IndustriasBizarras/SIE/PCB/Kicad/sie_kicad_mini/SAKC.brd.org

PCBNEW-BOARD Version 1 date Mon 28 Jun 2010 10:10:36 AM COT

$GENERAL
LayerCount 2
Ly 1FFF8001
Links 552
NoConn 0
Di 54745 42295 109665 82225
Ndraw 30
Ntrack 4642
Nzone 8332
Nmodule 163
Nnets 208
$EndGENERAL

$SHEETDESCR
Sheet A3 16535 11700
Title ""
Date "28 jun 2010"
Rev ""
Comp ""
Comment1 ""
Comment2 ""
Comment3 ""
Comment4 ""
$EndSHEETDESCR

$SETUP
InternalUnit 0.000100 INCH
ZoneGridSize 50
Layers 2
Layer[0] Copper signal
Layer[15] Component signal
TrackWidth 310
TrackWidthHistory 75
TrackWidthHistory 170
TrackWidthHistory 310
TrackClearence 75
ZoneClearence 118
DrawSegmWidth 79
EdgeSegmWidth 79
ViaSize 236
ViaDrill 118
ViaAltDrill 250
ViaSizeHistory 236
MicroViaSize 200
MicroViaDrill 80
MicroViasAllowed 0
TextPcbWidth 120
TextPcbSize 600 800
EdgeModWidth 79
TextModSize 600 600
TextModWidth 79
PadSize 600 600
PadDrill 200
AuxiliaryAxisOrg 0 0
$EndSETUP

$EQUIPOT
Na 0 ""
St ~
$EndEQUIPOT
$EQUIPOT
Na 1 "/LCD/3.3V"
St ~
$EndEQUIPOT
$EQUIPOT
Na 2 "/FPGA/DIGIN1"
St ~
$EndEQUIPOT
$EQUIPOT
Na 3 "/FPGA/DIGIN2"
St ~
$EndEQUIPOT
$EQUIPOT
Na 4 "N-000163"
St ~
$EndEQUIPOT
$EQUIPOT
Na 5 "/LCD/GND"
St ~
$EndEQUIPOT
$EQUIPOT
Na 6 "N-000177"
St ~
$EndEQUIPOT
$EQUIPOT
Na 7 "/CPU/LCD_D17"
St ~
$EndEQUIPOT
$EQUIPOT
Na 8 "/CPU/VREF"
St ~
$EndEQUIPOT
$EQUIPOT
Na 9 "/CPU/VDDA"
St ~
$EndEQUIPOT
$EQUIPOT
Na 10 "N-000174"
St ~
$EndEQUIPOT
$EQUIPOT
Na 11 "/CPU/RCLK"
St ~
$EndEQUIPOT
$EQUIPOT
Na 12 "N-000173"
St ~
$EndEQUIPOT
$EQUIPOT
Na 13 "/CPU/EXTAL"
St ~
$EndEQUIPOT
$EQUIPOT
Na 14 "/CPU/RESET_N"
St ~
$EndEQUIPOT
$EQUIPOT
Na 15 "/CPU/VDDADC"
St ~
$EndEQUIPOT
$EQUIPOT
Na 16 "/CPU/VDDUSB"
St ~
$EndEQUIPOT
$EQUIPOT
Na 17 "/CPU/VDDHP"
St ~
$EndEQUIPOT
$EQUIPOT
Na 18 "/CPU/VDDPLL"
St ~
$EndEQUIPOT
$EQUIPOT
Na 19 "/CPU/VDDCORE"
St ~
$EndEQUIPOT
$EQUIPOT
Na 20 "/CPU/VDDIO"
St ~
$EndEQUIPOT
$EQUIPOT
Na 21 "/FPGA/1V2"
St ~
$EndEQUIPOT
$EQUIPOT
Na 22 "N-000149"
St ~
$EndEQUIPOT
$EQUIPOT
Na 23 "N-000152"
St ~
$EndEQUIPOT
$EQUIPOT
Na 24 "N-000151"
St ~
$EndEQUIPOT
$EQUIPOT
Na 25 "N-000155"
St ~
$EndEQUIPOT
$EQUIPOT
Na 26 "N-000153"
St ~
$EndEQUIPOT
$EQUIPOT
Na 27 "N-000150"
St ~
$EndEQUIPOT
$EQUIPOT
Na 28 "/1.8V"
St ~
$EndEQUIPOT
$EQUIPOT
Na 29 "/FPGA/2V5"
St ~
$EndEQUIPOT
$EQUIPOT
Na 30 "/UART_USB_I2C/BAT_V"
St ~
$EndEQUIPOT
$EQUIPOT
Na 31 "N-000157"
St ~
$EndEQUIPOT
$EQUIPOT
Na 32 "/LCD/LCD_VDD"
St ~
$EndEQUIPOT
$EQUIPOT
Na 33 "N-000154"
St ~
$EndEQUIPOT
$EQUIPOT
Na 34 "N-000103"
St ~
$EndEQUIPOT
$EQUIPOT
Na 35 "N-000101"
St ~
$EndEQUIPOT
$EQUIPOT
Na 36 "N-000115"
St ~
$EndEQUIPOT
$EQUIPOT
Na 37 "N-000113"
St ~
$EndEQUIPOT
$EQUIPOT
Na 38 "/MEMORY/MSC_CMD"
St ~
$EndEQUIPOT
$EQUIPOT
Na 39 "N-000116"
St ~
$EndEQUIPOT
$EQUIPOT
Na 40 "/MEMORY/MSC_D0"
St ~
$EndEQUIPOT
$EQUIPOT
Na 41 "N-000112"
St ~
$EndEQUIPOT
$EQUIPOT
Na 42 "/MEMORY/SD_CD_N"
St ~
$EndEQUIPOT
$EQUIPOT
Na 43 "/UART_USB_I2C/TX1"
St ~
$EndEQUIPOT
$EQUIPOT
Na 44 "/UART_USB_I2C/RX1"
St ~
$EndEQUIPOT
$EQUIPOT
Na 45 "/FPGA/TDO_F"
St ~
$EndEQUIPOT
$EQUIPOT
Na 46 "/FPGA/TMS_F"
St ~
$EndEQUIPOT
$EQUIPOT
Na 47 "N-000145"
St ~
$EndEQUIPOT
$EQUIPOT
Na 48 "/UART_USB_I2C/DM0"
St ~
$EndEQUIPOT
$EQUIPOT
Na 49 "/UART_USB_I2C/DP0"
St ~
$EndEQUIPOT
$EQUIPOT
Na 50 "N-000147"
St ~
$EndEQUIPOT
$EQUIPOT
Na 51 "/CPU/UBOOT"
St ~
$EndEQUIPOT
$EQUIPOT
Na 52 "/CONNECTORS/ADIN0"
St ~
$EndEQUIPOT
$EQUIPOT
Na 53 "/CONNECTORS/ADIN1"
St ~
$EndEQUIPOT
$EQUIPOT
Na 54 "/CONNECTORS/R-HPO"
St ~
$EndEQUIPOT
$EQUIPOT
Na 55 "/CONNECTORS/L-HPO"
St ~
$EndEQUIPOT
$EQUIPOT
Na 56 "/CONNECTORS/L-LINEIN"
St ~
$EndEQUIPOT
$EQUIPOT
Na 57 "/CONNECTORS/R-LINEIN"
St ~
$EndEQUIPOT
$EQUIPOT
Na 58 "/CONNECTORS/MICIN"
St ~
$EndEQUIPOT
$EQUIPOT
Na 59 "N-000146"
St ~
$EndEQUIPOT
$EQUIPOT
Na 60 "/FPGA/IRQ_F"
St ~
$EndEQUIPOT
$EQUIPOT
Na 61 "/FPGA/DIG12"
St ~
$EndEQUIPOT
$EQUIPOT
Na 62 "/FPGA/DIG11"
St ~
$EndEQUIPOT
$EQUIPOT
Na 63 "/FPGA/DIG10"
St ~
$EndEQUIPOT
$EQUIPOT
Na 64 "/FPGA/DIG9"
St ~
$EndEQUIPOT
$EQUIPOT
Na 65 "/FPGA/DIG8"
St ~
$EndEQUIPOT
$EQUIPOT
Na 66 "/FPGA/DIG7"
St ~
$EndEQUIPOT
$EQUIPOT
Na 67 "/FPGA/DIG6"
St ~
$EndEQUIPOT
$EQUIPOT
Na 68 "/FPGA/DIG5"
St ~
$EndEQUIPOT
$EQUIPOT
Na 69 "/FPGA/DIG4"
St ~
$EndEQUIPOT
$EQUIPOT
Na 70 "/FPGA/DIG3"
St ~
$EndEQUIPOT
$EQUIPOT
Na 71 "/FPGA/DIG2"
St ~
$EndEQUIPOT
$EQUIPOT
Na 72 "/FPGA/DIG1"
St ~
$EndEQUIPOT
$EQUIPOT
Na 73 "/FPGA/DIG0"
St ~
$EndEQUIPOT
$EQUIPOT
Na 74 "/FPGA/DIG14"
St ~
$EndEQUIPOT
$EQUIPOT
Na 75 "/FPGA/DIG15"
St ~
$EndEQUIPOT
$EQUIPOT
Na 76 "/FPGA/DIG16"
St ~
$EndEQUIPOT
$EQUIPOT
Na 77 "/FPGA/DIG17"
St ~
$EndEQUIPOT
$EQUIPOT
Na 78 "/FPGA/DIG18"
St ~
$EndEQUIPOT
$EQUIPOT
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
$EQUIPOT
Na 169 "/CS2_N"
St ~
$EndEQUIPOT
$EQUIPOT
Na 170 "/MEMORY/CS1_N"
St ~
$EndEQUIPOT
$EQUIPOT
Na 171 "/UART_USB_I2C/RXD"
St ~
$EndEQUIPOT
$EQUIPOT
Na 172 "/POWER_SUPPLY/VRTC"
St ~
$EndEQUIPOT
$EQUIPOT
Na 173 "/LCD/LCD_SCL"
St ~
$EndEQUIPOT
$EQUIPOT
Na 174 "/LCD/LCD_SDA"
St ~
$EndEQUIPOT
$EQUIPOT
Na 175 "/LCD/LCD_VSYNC"
St ~
$EndEQUIPOT
$EQUIPOT
Na 176 "/LCD/LCD_HSYNC"
St ~
$EndEQUIPOT
$EQUIPOT
Na 177 "/LCD/LCD_DE"
St ~
$EndEQUIPOT
$EQUIPOT
Na 178 "/FPGA/ADC_EOC"
St ~
$EndEQUIPOT
$EQUIPOT
Na 179 "/FPGA/ADC_SCLK"
St ~
$EndEQUIPOT
$EQUIPOT
Na 180 "/FPGA/ADC_SDIN"
St ~
$EndEQUIPOT
$EQUIPOT
Na 181 "/FPGA/ADC_SDOUT"
St ~
$EndEQUIPOT
$EQUIPOT
Na 182 "/FPGA/ADC_CS"
St ~
$EndEQUIPOT
$EQUIPOT
Na 183 "/FPGA/ADC_CSTART"
St ~
$EndEQUIPOT
$EQUIPOT
Na 184 "/FPGA/OSC_XM"
St ~
$EndEQUIPOT
$EQUIPOT
Na 185 "N-000162"
St ~
$EndEQUIPOT
$EQUIPOT
Na 186 "/LCD/V1M"
St ~
$EndEQUIPOT
$EQUIPOT
Na 187 "/LCD/V1P"
St ~
$EndEQUIPOT
$EQUIPOT
Na 188 "/LCD/V2M"
St ~
$EndEQUIPOT
$EQUIPOT
Na 189 "/LCD/V2P"
St ~
$EndEQUIPOT
$EQUIPOT
Na 190 "/LCD/V3M"
St ~
$EndEQUIPOT
$EQUIPOT
Na 191 "/LCD/V3P"
St ~
$EndEQUIPOT
$EQUIPOT
Na 192 "/LCD/V4M"
St ~
$EndEQUIPOT
$EQUIPOT
Na 193 "/LCD/V4P"
St ~
$EndEQUIPOT
$EQUIPOT
Na 194 "/LCD/AGND"
St ~
$EndEQUIPOT
$EQUIPOT
Na 195 "/LCD/DVDD"
St ~
$EndEQUIPOT
$EQUIPOT
Na 196 "/LCD/VINT1"
St ~
$EndEQUIPOT
$EQUIPOT
Na 197 "/LCD/VINT2"
St ~
$EndEQUIPOT
$EQUIPOT
Na 198 "/LCD/VINT3"
St ~
$EndEQUIPOT
$EQUIPOT
Na 199 "/LCD/VCAC"
St ~
$EndEQUIPOT
$EQUIPOT
Na 200 "/LCD/VGH"
St ~
$EndEQUIPOT
$EQUIPOT
Na 201 "/LCD/VGL"
St ~
$EndEQUIPOT
$EQUIPOT
Na 202 "/LCD/VCOM"
St ~
$EndEQUIPOT
$EQUIPOT
Na 203 "/LCD/FRP"
St ~
$EndEQUIPOT
$EQUIPOT
Na 204 "/LCD/VLED"
St ~
$EndEQUIPOT
$EQUIPOT
Na 205 "N-000067"
St ~
$EndEQUIPOT
$EQUIPOT
Na 206 "/LCD/DRV"
St ~
$EndEQUIPOT
$EQUIPOT
Na 207 "/LCD/FB"
St ~
$EndEQUIPOT
$MODULE J12
Po 78680 81380 0 15 4B8F50FA 4B7C7019 ~~
Li J12
Sc 4B7C7019
AR /4B8F6097/4B7C7019
Op 0 0 0
T0 0 -79 157 157 0 20 N I 21 N"J12"
T1 0 118 118 118 0 20 N I 21 N"HOLE1"
DS -840 840 -840 -830 10 24
DS -840 -830 830 -830 10 24
DS 830 -830 830 840 10 24
DS 830 840 -840 840 10 24
$PAD
Sh "1" C 3140 3140 0 0 0
Dr 1180 0 0
At STD N 0CC08001
Ne 0 ""
Po 15130 -7960
$EndPAD
$EndMODULE  J12
$MODULE J14
Po 97420 45150 0 15 4B8F50EE 4B7C701D ~~
Li J14
Sc 4B7C701D
AR /4B8F6097/4B7C701D
Op 0 0 0
T0 0 -79 157 157 0 20 N I 21 N"J14"
T1 0 118 118 118 0 20 N I 21 N"HOLE4"
DS -840 840 -840 -830 10 24
DS -840 -830 830 -830 10 24
DS 830 -830 830 840 10 24
DS 830 840 -840 840 10 24
$PAD
Sh "1" C 3140 3140 0 0 0
Dr 1180 0 0
At STD N 0CC08001
Ne 0 ""
Po -3620 -210
$EndPAD
$EndMODULE  J14
$MODULE R33
Po 85152 71912 0 15 4BA7D56B 4BA504CA ~~
Li R33
Sc 4BA504CA
AR /4B8F57B1/4BA504CA
Op 0 0 0
T0 -608 -16 157 157 -1800 20 N V 21 N"R33"
T1 0 118 118 118 -2700 20 N I 21 N"4.7K"
DS -330 360 880 360 10 24
DS 880 360 880 -350 10 24
DS 880 -350 -330 -350 10 24
DS -330 -350 -330 360 10 24
DS -300 330 -300 -320 60 21
DS -300 -320 -300 -320 60 21
DS -300 -320 850 -320 60 21
DS 850 -320 850 330 60 21
DS 850 330 -300 330 60 21
DS -300 330 -300 -320 60 26
DS -300 -320 -300 -320 60 26
DS -300 -320 850 -320 60 26
DS 850 -320 850 330 60 26
DS 850 330 -300 330 60 26
$PAD
Sh "1" R 380 320 0 0 900
Dr 0 0 0
At SMD N 04888000
Ne 1 "/LCD/3.3V"
Po 0 0
$EndPAD
$PAD
Sh "2" R 380 320 0 0 900
Dr 0 0 0
At SMD N 04888000
Ne 2 "/FPGA/DIGIN1"
Po 560 0
$EndPAD
$EndMODULE  R33
$MODULE R32
Po 89824 72420 0 15 4BA7D577 4BA504C2 ~~
Li R32
Sc 4BA504C2
AR /4B8F57B1/4BA504C2
Op 0 0 0
T0 -536 -40 157 157 -1800 20 N V 21 N"R32"
T1 0 118 118 118 -2700 20 N I 21 N"4.7K"
DS -330 360 880 360 10 24
DS 880 360 880 -350 10 24
DS 880 -350 -330 -350 10 24
DS -330 -350 -330 360 10 24
DS -300 330 -300 -320 60 21
DS -300 -320 -300 -320 60 21
DS -300 -320 850 -320 60 21
DS 850 -320 850 330 60 21
DS 850 330 -300 330 60 21
DS -300 330 -300 -320 60 26
DS -300 -320 -300 -320 60 26
DS -300 -320 850 -320 60 26
DS 850 -320 850 330 60 26
DS 850 330 -300 330 60 26
$PAD
Sh "1" R 380 320 0 0 900
Dr 0 0 0
At SMD N 04888000
Ne 1 "/LCD/3.3V"
Po 0 0
$EndPAD
$PAD
Sh "2" R 380 320 0 0 900
Dr 0 0 0
At SMD N 04888000
Ne 3 "/FPGA/DIGIN2"
Po 560 0
$EndPAD
$EndMODULE  R32
$MODULE R31
Po 90668 45280 0 15 4BA7DC55 4BA5068A ~~
Li R31
Sc 4BA5068A
AR /4B8F6097/4BA5068A
Op 0 0 0
T0 37 -396 157 157 0 20 N V 21 N"R31"
T1 0 118 118 118 -900 20 N I 21 N"1K"
DS -300 -250 -300 -300 60 21
DS -300 -300 300 -300 60 21
DS 300 -300 300 -250 60 21
DS -600 300 -600 -300 60 24
DS -600 -300 600 -300 60 24
DS 600 -300 600 300 60 24
DS 600 300 -600 300 60 24
DS -600 300 600 300 60 26
DS 600 300 600 -300 60 26
DS 600 -300 -600 -300 60 26
DS -600 -300 -600 300 60 26
DS -300 250 -300 300 60 21
DS -300 300 300 300 60 21
DS 300 300 300 250 60 21
$PAD
Sh "1" R 300 340 0 0 900
Dr 0 0 0
At SMD N 00888000
Ne 4 "N-000163"
Po -330 0
$EndPAD
$PAD
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
Po 0 70520 61744 72592 59672 75 -1
De 0 0 129 0 0
Po 0 72592 59672 72880 59672 75 -1
De 0 0 129 0 0
Po 0 70520 61956 70520 61744 75 -1
De 0 0 129 0 0
Po 0 70520 62112 70520 63890 75 -1
De 15 0 129 0 400
Po 0 70520 61956 70520 62112 75 -1
De 15 0 129 0 0
Po 3 70520 61956 70520 61956 236 -1
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
