IndustriasBizarras/SIE/docs/Board_layout.png

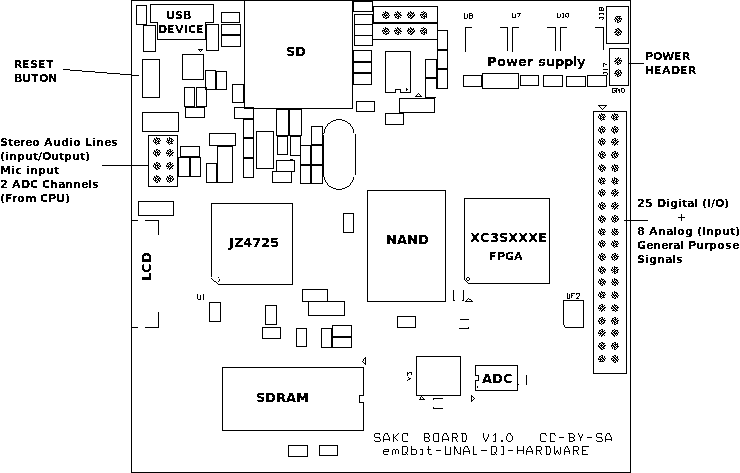
docs/Board_layout.png
