IndustriasBizarras/SIE/docs/SACK_BOT.png

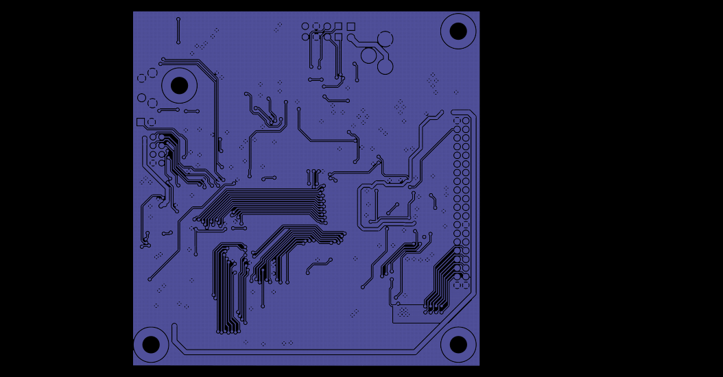
docs/SACK_BOT.png
