IndustriasBizarras/SIE/docs/SACK_SST.png

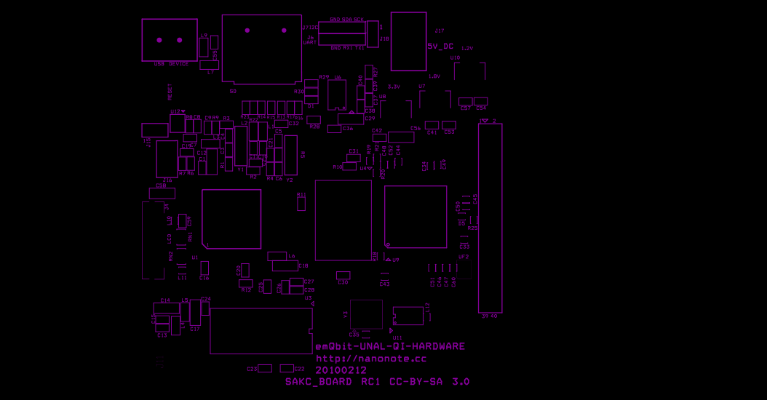
docs/SACK_SST.png
