IndustriasBizarras/SIE/docs/SACK_TOP.png

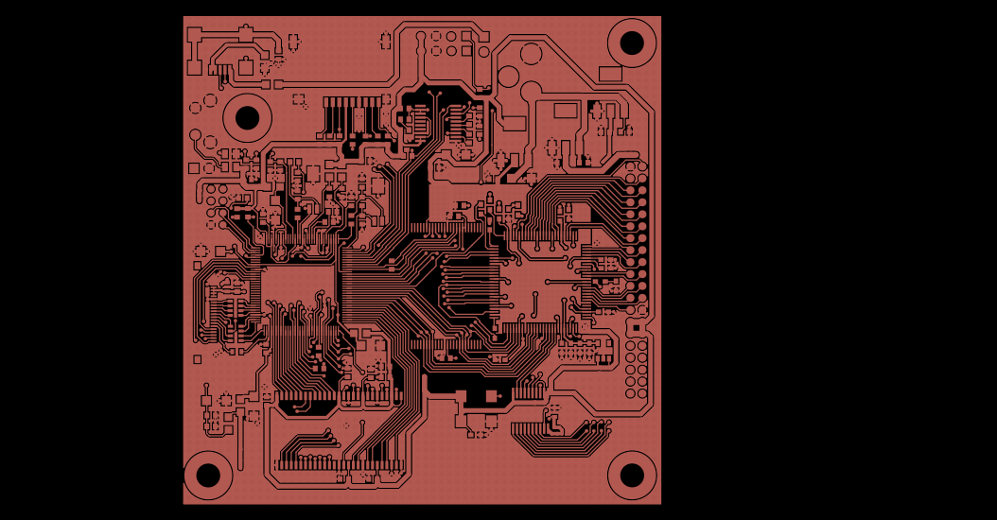
docs/SACK_TOP.png
