IndustriasBizarras/SIE/Examples/moto_display/COMPLEMENTOS/IMAGENES/imagenes/200px-RTL_ADC.png

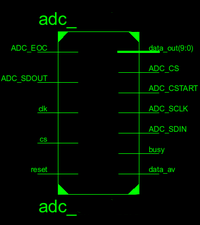
Examples/moto_display/COMPLEMENTOS/IMAGENES/imagenes/200px-RTL_ADC.png
