IndustriasBizarras/SIE/Examples/moto_display/COMPLEMENTOS/IMAGENES/imagenes/450px-ADC_Es1.jpg

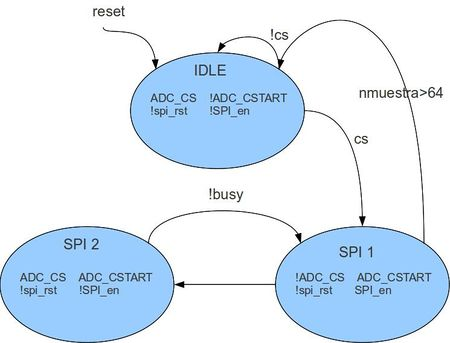
Examples/moto_display/COMPLEMENTOS/IMAGENES/imagenes/450px-ADC_Es1.jpg
