IndustriasBizarras/SIE/Examples/moto_display/COMPLEMENTOS/IMAGENES/imagenes/450px-ADC_ES2.jpg

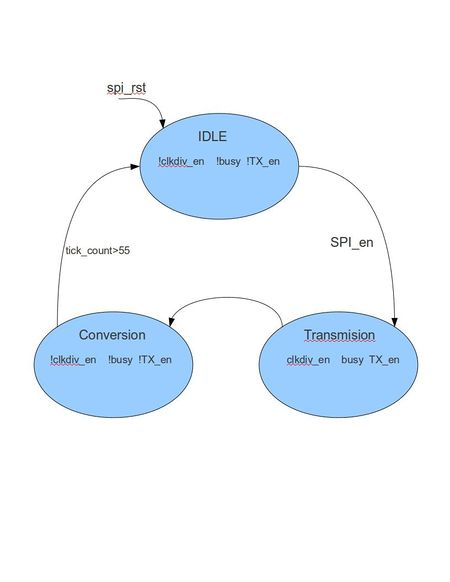
Examples/moto_display/COMPLEMENTOS/IMAGENES/imagenes/450px-ADC_ES2.jpg
