IndustriasBizarras/SIE/Examples/moto_display/COMPLEMENTOS/IMAGENES/imagenes/520px-ADC_diagrama.jpg

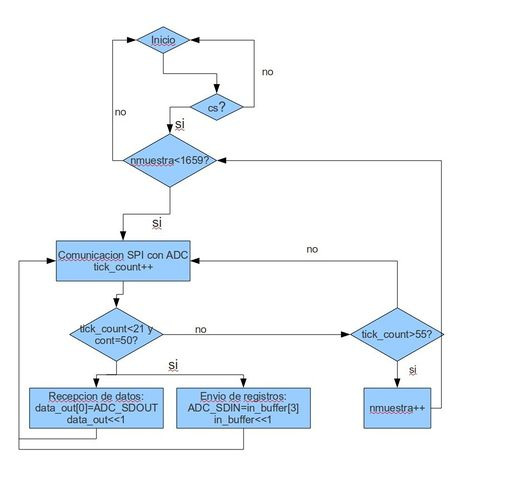
Examples/moto_display/COMPLEMENTOS/IMAGENES/imagenes/520px-ADC_diagrama.jpg
