IndustriasBizarras/SIE/Examples/moto_display/COMPLEMENTOS/IMAGENES/imagenes/520px-Time_ADC.png

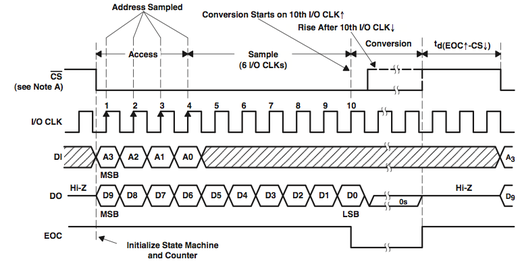
Examples/moto_display/COMPLEMENTOS/IMAGENES/imagenes/520px-Time_ADC.png
