IndustriasBizarras/SIE/Examples/moto_display/COMPLEMENTOS/IMAGENES/imagenes/antena.png

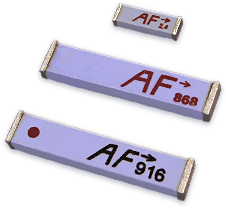
Examples/moto_display/COMPLEMENTOS/IMAGENES/imagenes/antena.png
