IndustriasBizarras/SIE/Examples/moto_display/COMPLEMENTOS/IMAGENES/imagenes/buffer.jpg

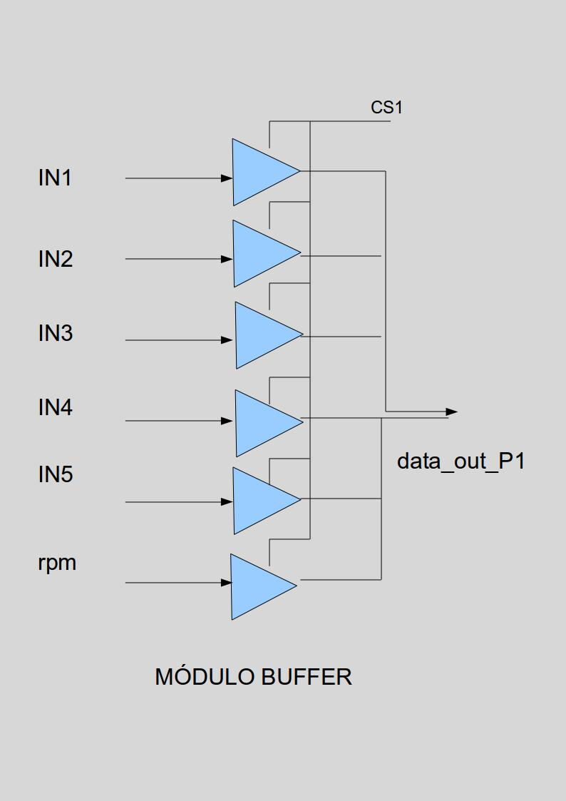
Examples/moto_display/COMPLEMENTOS/IMAGENES/imagenes/buffer.jpg
