IndustriasBizarras/SIE/Examples/moto_display/COMPLEMENTOS/IMAGENES/imagenes/Buffer.png

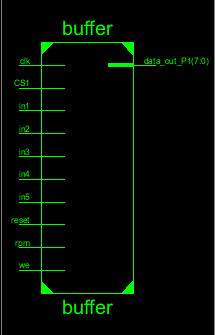
Examples/moto_display/COMPLEMENTOS/IMAGENES/imagenes/Buffer.png
