IndustriasBizarras/SIE/Examples/moto_display/COMPLEMENTOS/IMAGENES/imagenes/grafic1.jpg

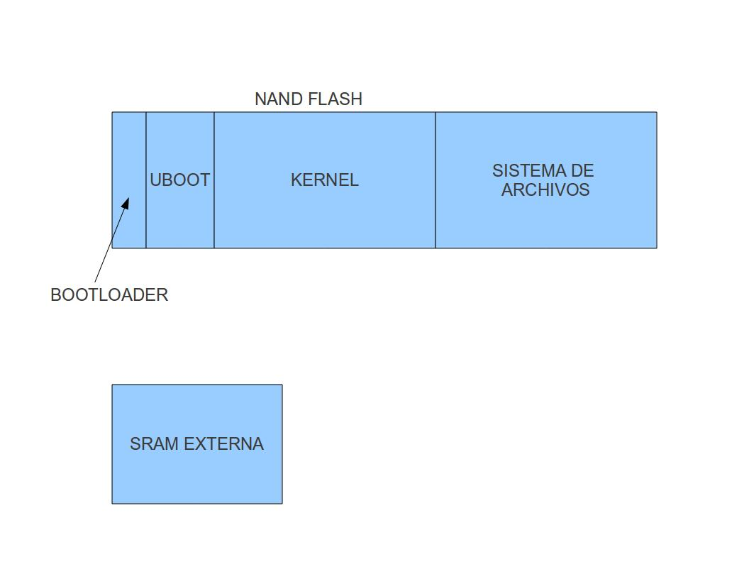
Examples/moto_display/COMPLEMENTOS/IMAGENES/imagenes/grafic1.jpg
