IndustriasBizarras/SIE/Examples/moto_display/COMPLEMENTOS/IMAGENES/imagenes/Honda_Slammer.jpg

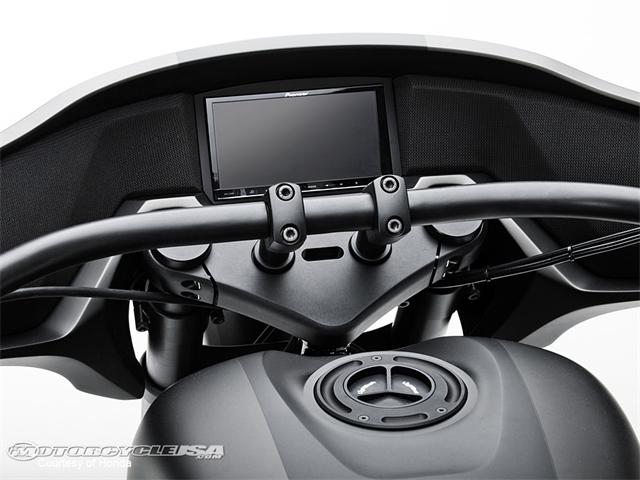
Examples/moto_display/COMPLEMENTOS/IMAGENES/imagenes/Honda_Slammer.jpg
