IndustriasBizarras/SIE/Examples/moto_display/COMPLEMENTOS/IMAGENES/imagenes/hw-BLOQ.jpg

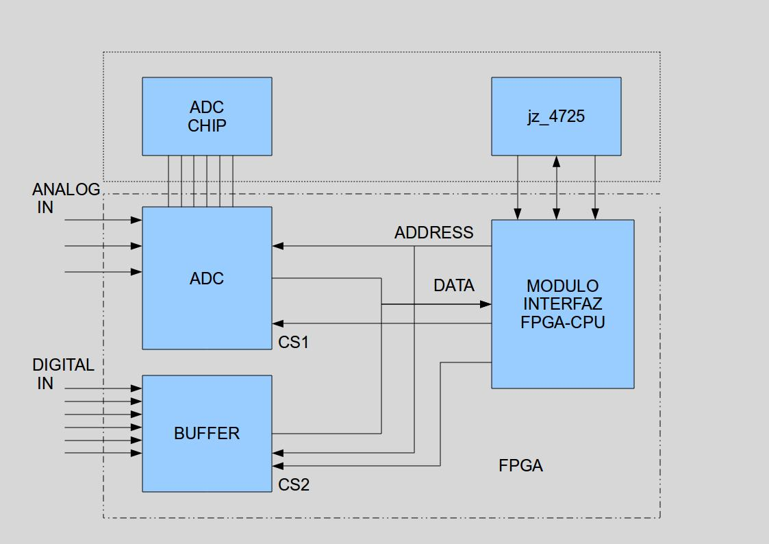
Examples/moto_display/COMPLEMENTOS/IMAGENES/imagenes/hw-BLOQ.jpg
