IndustriasBizarras/SIE/Examples/moto_display/COMPLEMENTOS/IMAGENES/imagenes/interfpgacpu.jpg

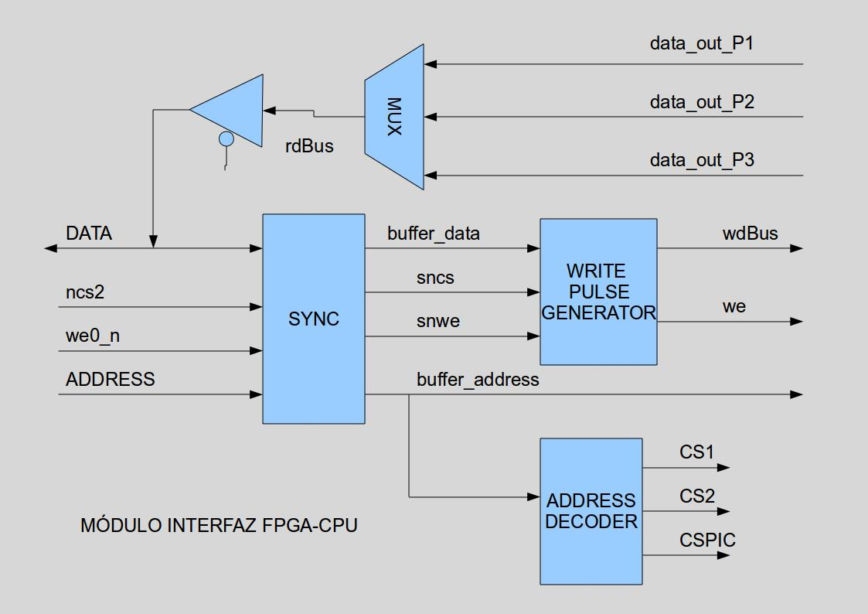
Examples/moto_display/COMPLEMENTOS/IMAGENES/imagenes/interfpgacpu.jpg
