IndustriasBizarras/SIE/Examples/moto_display/COMPLEMENTOS/IMAGENES/imagenes/Kc5290.jpeg

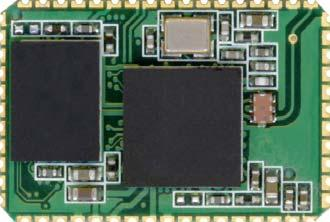
Examples/moto_display/COMPLEMENTOS/IMAGENES/imagenes/Kc5290.jpeg
