IndustriasBizarras/SIE/Examples/moto_display/COMPLEMENTOS/IMAGENES/imagenes/microstrip2.jpg

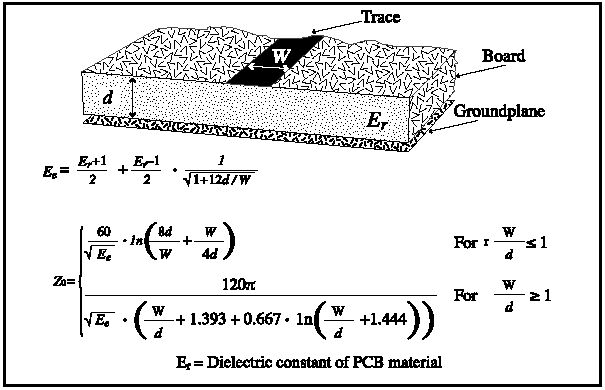
Examples/moto_display/COMPLEMENTOS/IMAGENES/imagenes/microstrip2.jpg
