IndustriasBizarras/SIE/Examples/moto_display/COMPLEMENTOS/IMAGENES/imagenes/moto.png

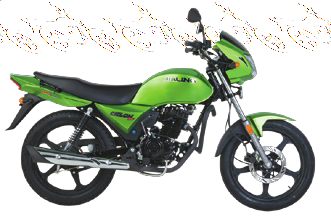
Examples/moto_display/COMPLEMENTOS/IMAGENES/imagenes/moto.png
