IndustriasBizarras/SIE/Examples/moto_display/COMPLEMENTOS/IMAGENES/imagenes/SMM-Back.jpg

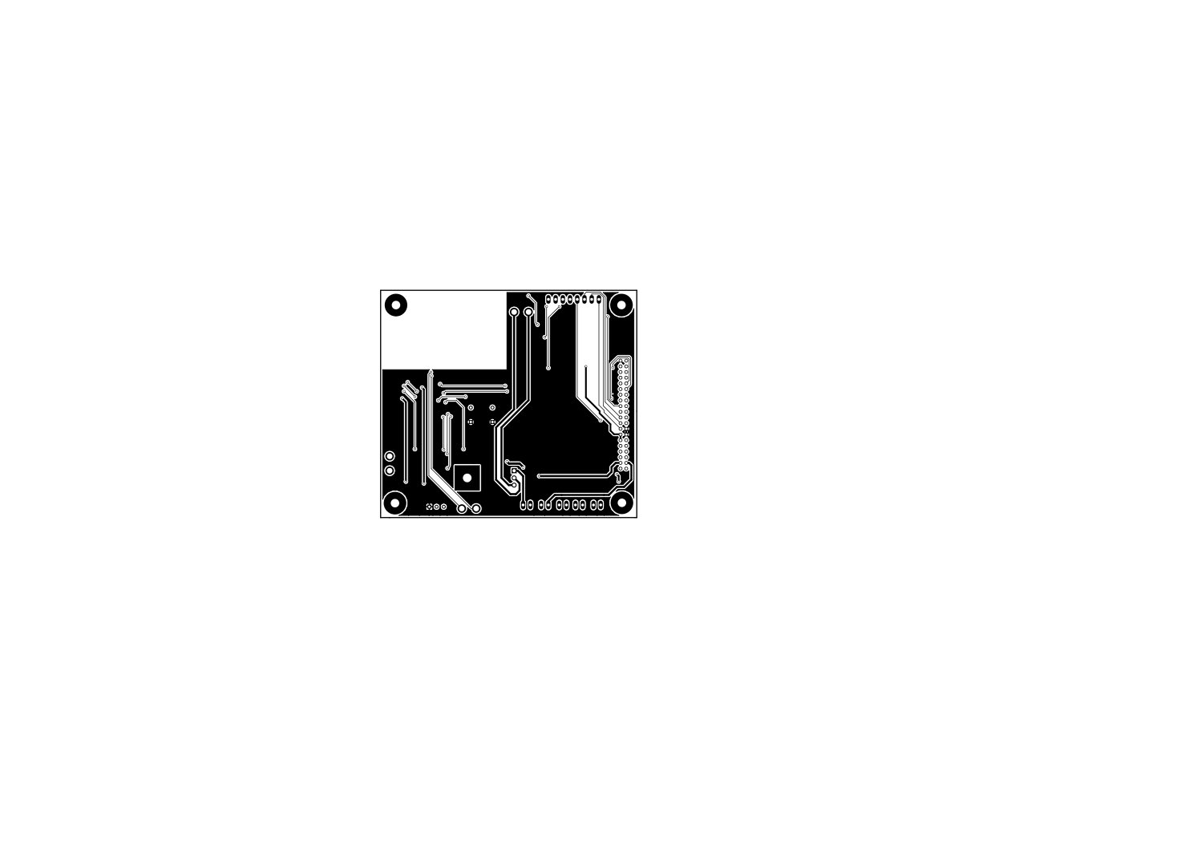
Examples/moto_display/COMPLEMENTOS/IMAGENES/imagenes/SMM-Back.jpg
