IndustriasBizarras/SIE/Examples/moto_display/COMPLEMENTOS/IMAGENES/imagenes/SMM.jpg

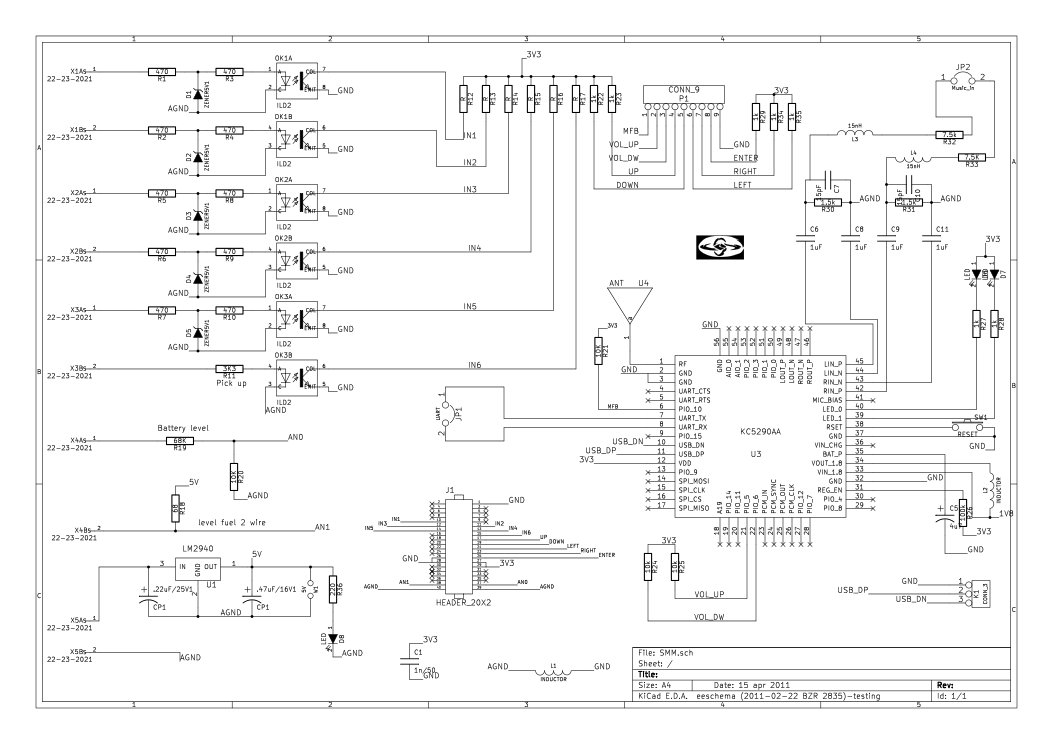
Examples/moto_display/COMPLEMENTOS/IMAGENES/imagenes/SMM.jpg
