IndustriasBizarras/SIE/Examples/moto_display/MAIN/Imagenes y Video/IMG_0109.jpg

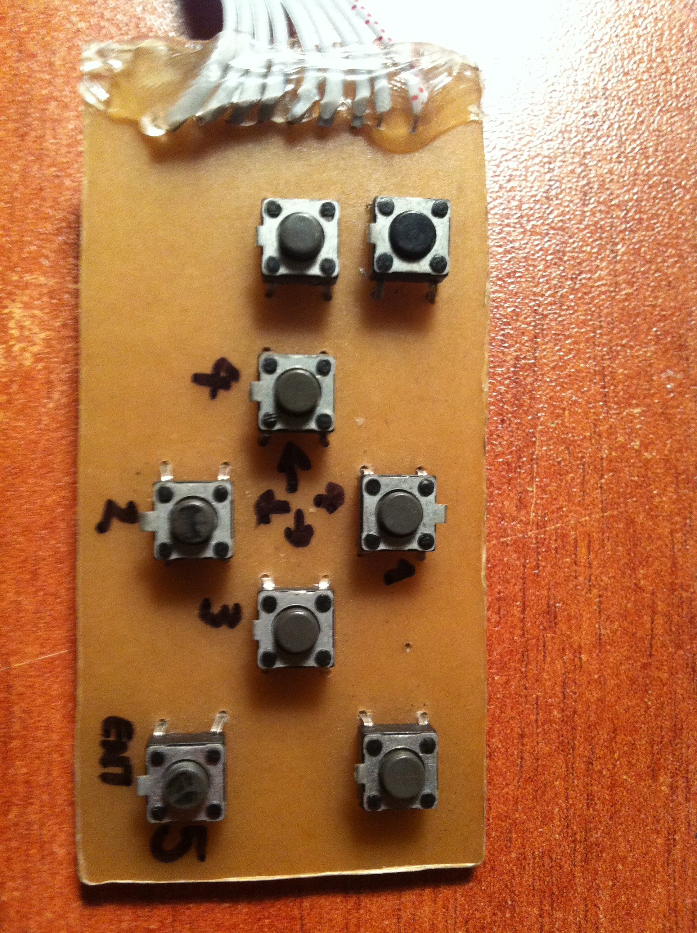
Examples/moto_display/MAIN/Imagenes y Video/IMG_0109.jpg
