IndustriasBizarras/SIE/Examples/moto_display/MAIN/Imagenes y Video/keypad.png

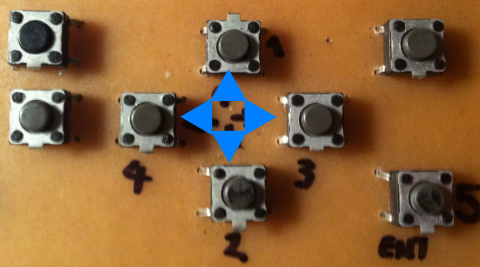
Examples/moto_display/MAIN/Imagenes y Video/keypad.png
