IndustriasBizarras/SIE/Examples/moto_display/MAIN/quasar_embedded.png

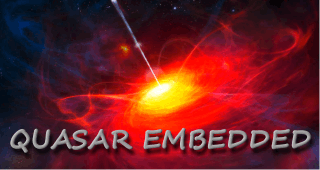
Examples/moto_display/MAIN/quasar_embedded.png
