IndustriasBizarras/SIE/Examples/moto_display/MAIN/source/userspace/QT_GUI/Moto_V2/carbon.png

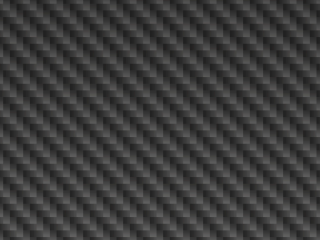
Examples/moto_display/MAIN/source/userspace/QT_GUI/Moto_V2/carbon.png
