IndustriasBizarras/SIE/Examples/moto_display/SCHEMATICS/AnalogINS.jpg

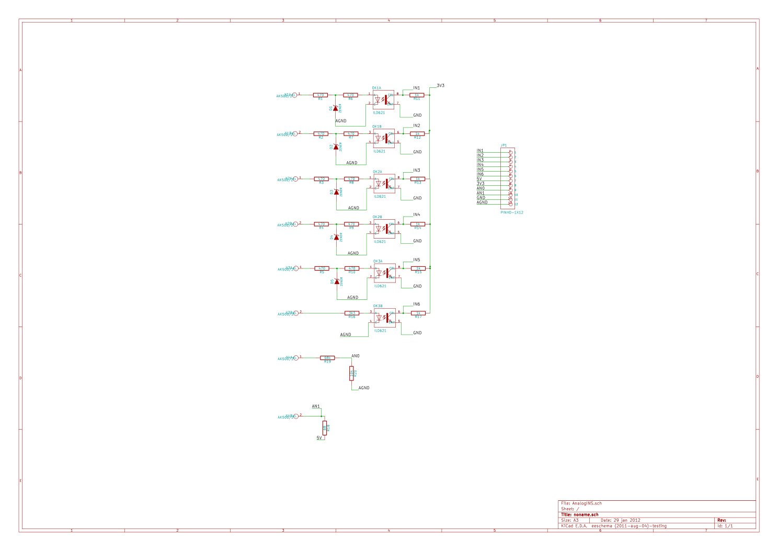
Examples/moto_display/SCHEMATICS/AnalogINS.jpg
