IndustriasBizarras/SIE/Examples/moto_display/SCHEMATICS/Keyboard.jpg

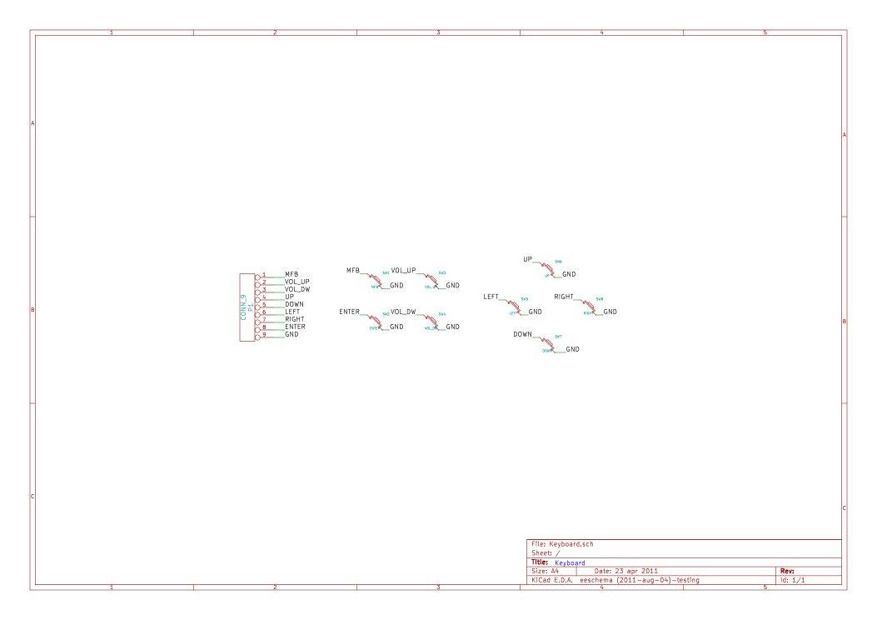
Examples/moto_display/SCHEMATICS/Keyboard.jpg
