IndustriasBizarras/SIE/Examples/moto_display/SCHEMATICS/SMM_2.jpg

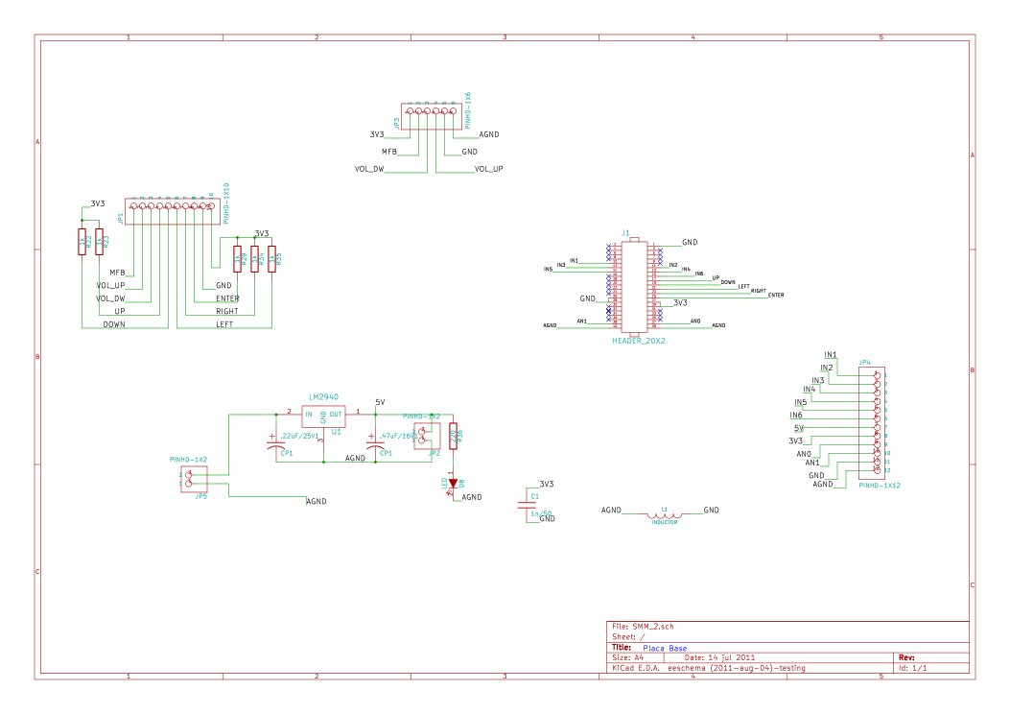
Examples/moto_display/SCHEMATICS/SMM_2.jpg
