IndustriasBizarras/SIE/Examples/pedal_de_efectos/PedalPCB/pcbauxiliar2.jpg

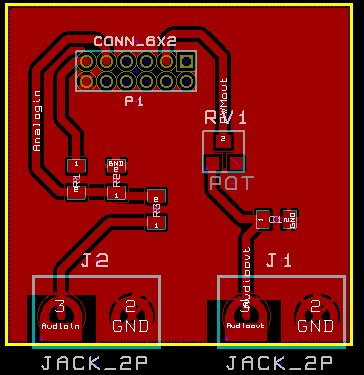
Examples/pedal_de_efectos/PedalPCB/pcbauxiliar2.jpg
