IndustriasBizarras/SIE/Examples/pedal_de_efectos/PedalPCB/pcbauxiliar.jpg

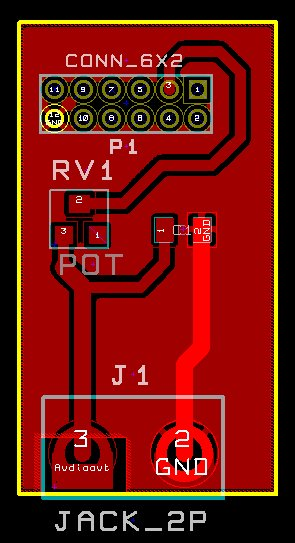
Examples/pedal_de_efectos/PedalPCB/pcbauxiliar.jpg
