IndustriasBizarras/SIE/Examples/PS2_INTERFACE/images/DRIVERS.png

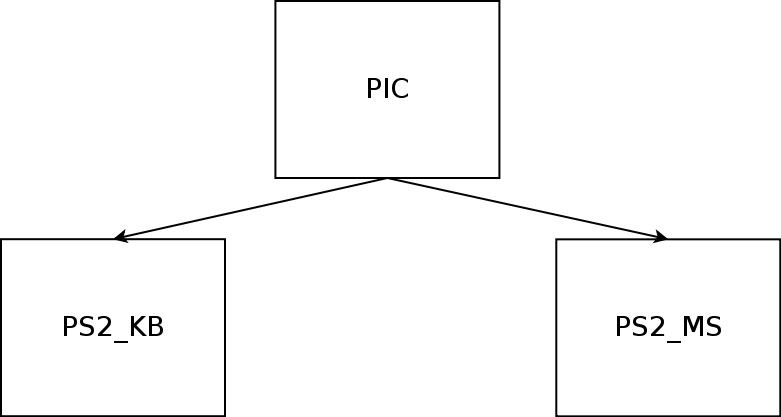
Examples/PS2_INTERFACE/images/DRIVERS.png
