IndustriasBizarras/SIE/Examples/PS2_INTERFACE/images/fsm_ps2.png

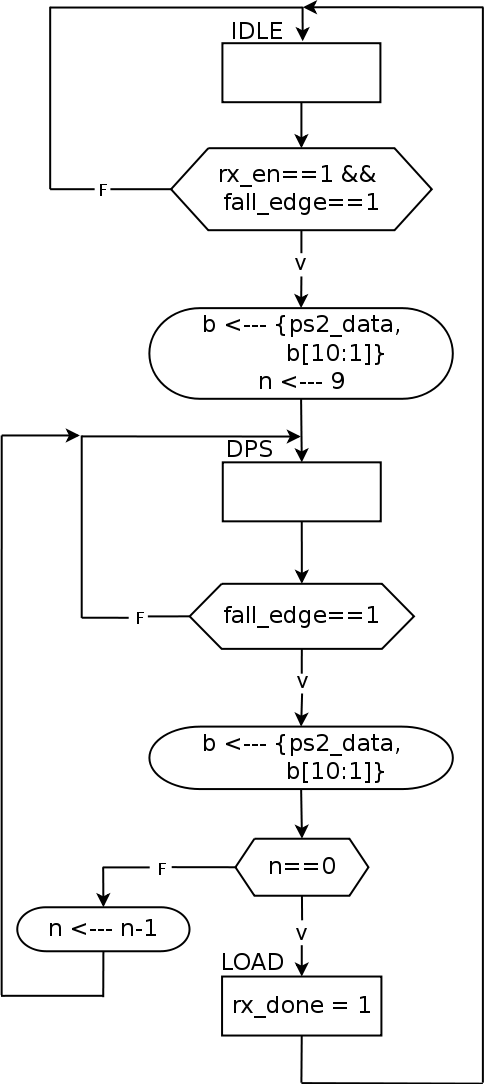
Examples/PS2_INTERFACE/images/fsm_ps2.png
