IndustriasBizarras/SIE/Examples/PS2_INTERFACE/images/kb_ps2.png

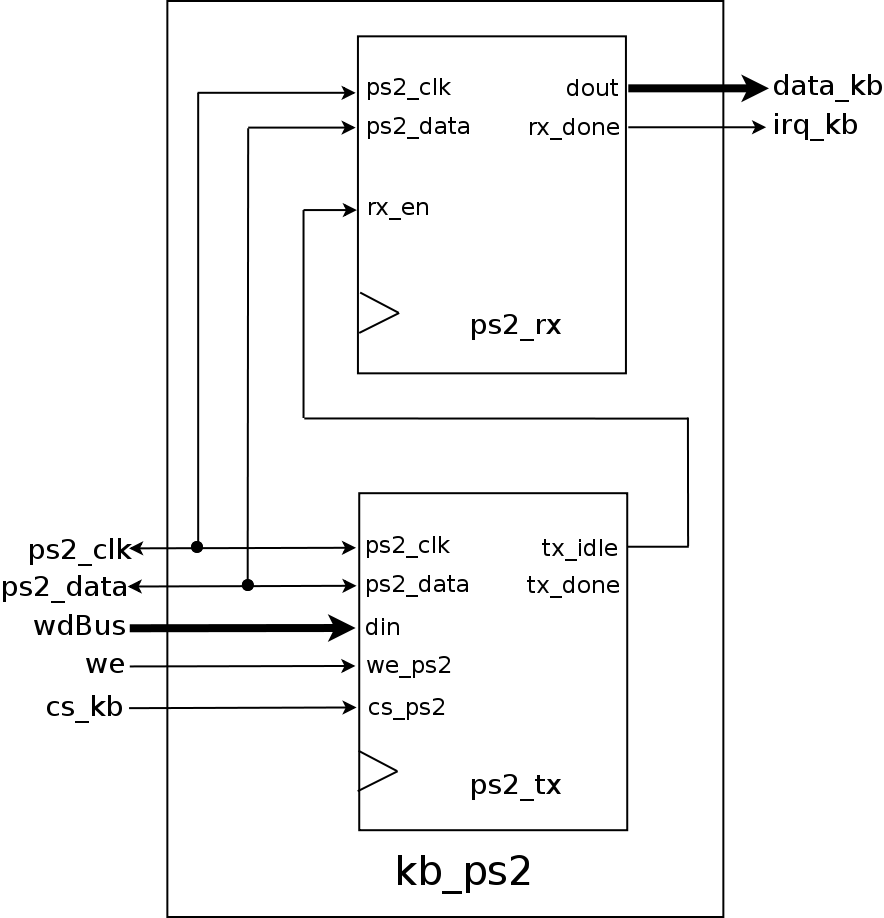
Examples/PS2_INTERFACE/images/kb_ps2.png
