IndustriasBizarras/SIE/Examples/PS2_INTERFACE/images/PlacaPS2.png

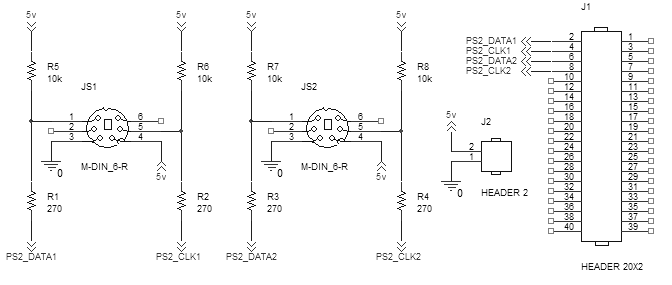
Examples/PS2_INTERFACE/images/PlacaPS2.png
