IndustriasBizarras/SIE/Examples/PS2_INTERFACE/images/ps2_HW.png

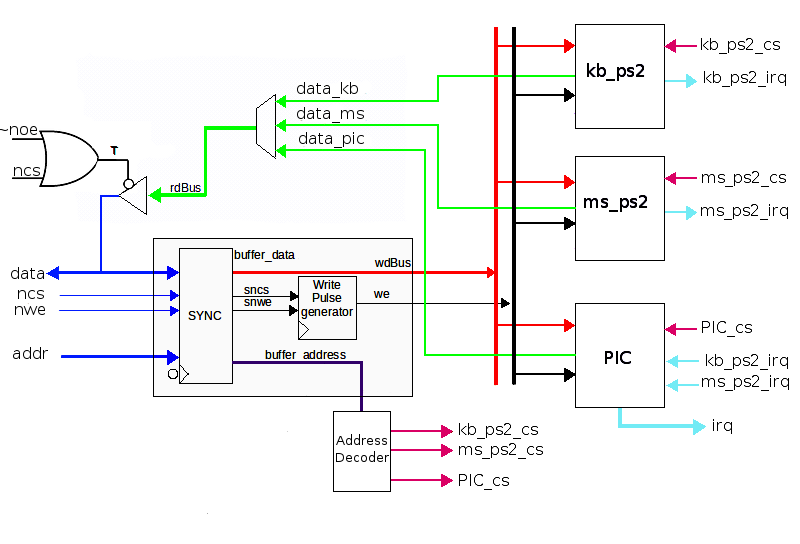
Examples/PS2_INTERFACE/images/ps2_HW.png
