IndustriasBizarras/SIE/Examples/PS2_INTERFACE/images/ps2_interface_simulation.png

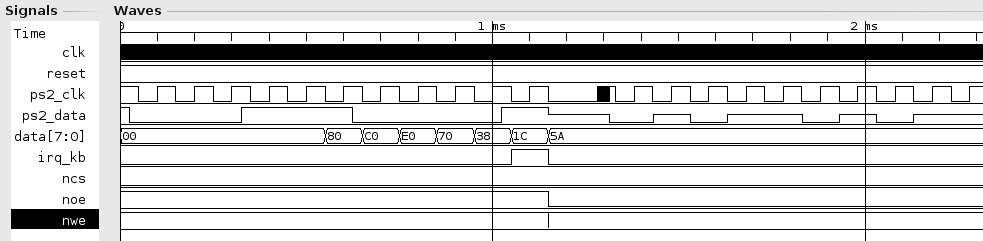
Examples/PS2_INTERFACE/images/ps2_interface_simulation.png
