IndustriasBizarras/SIE/Examples/PS2_INTERFACE/images/ps2_lineas.png

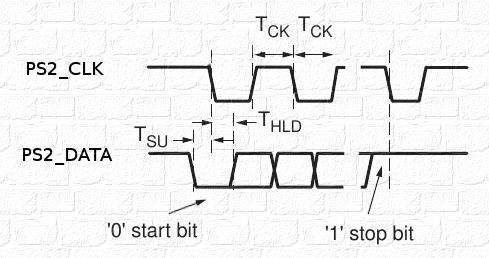
Examples/PS2_INTERFACE/images/ps2_lineas.png
