IndustriasBizarras/SIE/Examples/PS2_INTERFACE/images/PS2_PCB.png

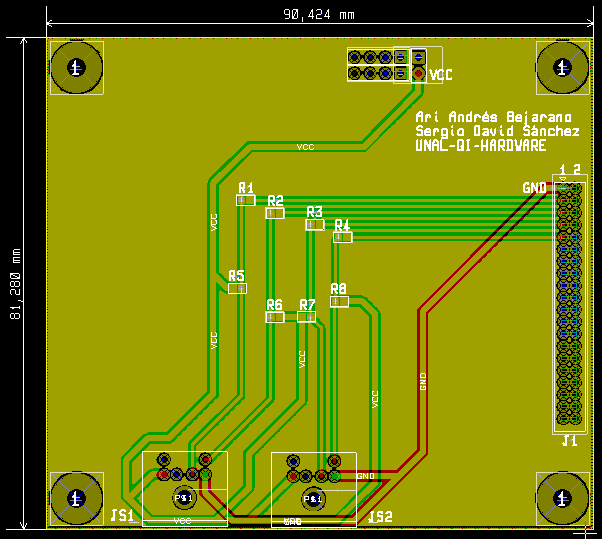
Examples/PS2_INTERFACE/images/PS2_PCB.png
