IndustriasBizarras/SIE/Examples/PS2_INTERFACE/images/ps2_rx.png

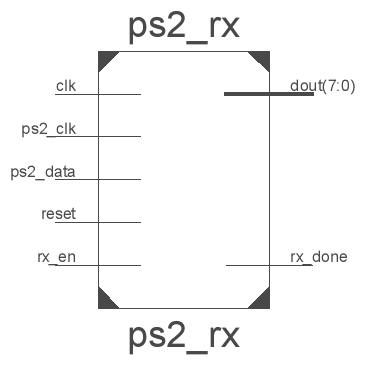
Examples/PS2_INTERFACE/images/ps2_rx.png
