IndustriasBizarras/SIE/Examples/PS2_INTERFACE/images/ps2_tx.png

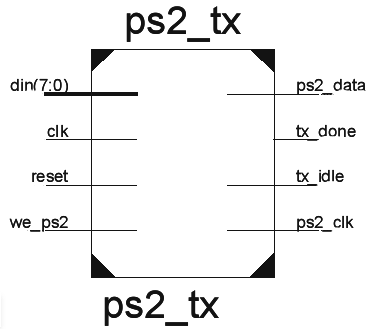
Examples/PS2_INTERFACE/images/ps2_tx.png
