IndustriasBizarras/SIE/PCB/Kicad/sie_kicad_mini/L7.png

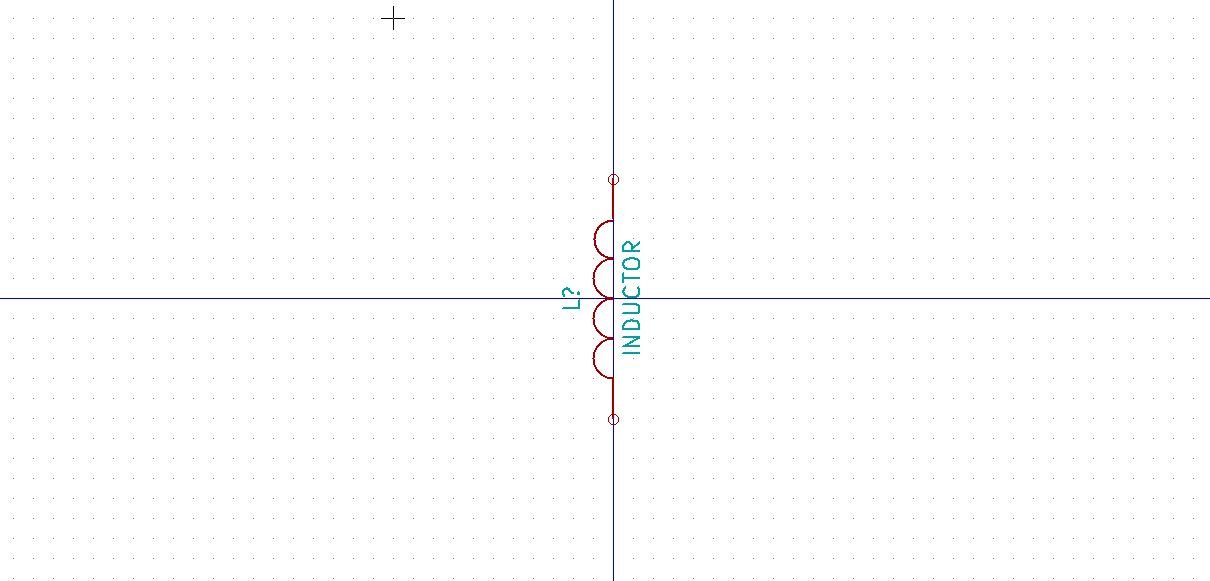
PCB/Kicad/sie_kicad_mini/L7.png
