IndustriasBizarras/SIE/software/sie_cg/images/background1.png

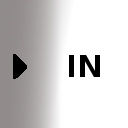
software/sie_cg/images/background1.png
