IndustriasBizarras/SIE/software/sie_cg/images/background2.png

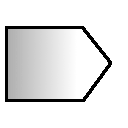
software/sie_cg/images/background2.png
