IndustriasBizarras/SIE/software/sie_cg/images/background3.png

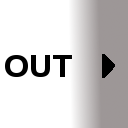
software/sie_cg/images/background3.png
