IndustriasBizarras/SIE/software/sie_cg/images/background4.png

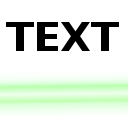
software/sie_cg/images/background4.png
