IndustriasBizarras/SIE/PCB/Orcad/sie_orcad_v1.1/sakc_bom_v3.ods

ITEM | REFERENCE | QUANTITY | MANUFACTURER P/N | DATASHEET LINK | MANUFACTURER | DESCRIPTION | PACKAGE | COMMENT | UNIT PRICE | USAGE PRICE | SUBSTITUTION P/N | SUBSTITUTION LINK | SOURCING STATUS | NOTE
1 | U1 | 1 | JZ4725 | http://downloads.qi-hardware.com/hardware/sakc/datasheet/U1~Jz4725_ds.pdf | INGENIC | AC \'97 Rev. 2.1 MultichanneL Audio Codec with Stereo Headphone Amplifier Sample Rate Conversion and National 3D SOUND | LQFP-128 |  | 2,924 | 2,924 |  |  | DONE | WL59/WL190
2 | U3 | 1 | Z2V56S40BTP-G6 | http://downloads.qi-hardware.com/hardware/sakc/datasheet/U3~Z2V56S40BTP-G6~32MB.pdf | DEUTRON/Mezza | 32MB 256Mb SDRAM 4-bank x 4,194,304-WORD x 16-bit 166MHz 6ns/3-3-3 3.3V | 54Pin TSOPII (400mil x 875mil) |  | 2,632 | 2,632 | P3V56S40ETP-G6 | http://downloads.qi-hardware.com/hardware/sakc/datasheet/U3~P3V56S40ETP-G6~32MB.pdf | DONE | WL191
3 | U4 | 1 | K9GAG08U0M-PCB0 | http://www.samsung.com/global/business/semiconductor/productInfo.do?fmly_id=672&partnum=K9GAG08U0M | SAMSUNG | 2G x 8bit NAND FLASH 2.7V~3.6V | 48Pin TSOP I (12 x 20 / 0.5 mm pitch) |  | 6,510 | 6,510 |  |  | DONE | WL192
4 | U6 | 1 | MAX3223IPWR | http://www.ti.com/lit/gpn/max3223 | TI | 3V TO 5.5V MULTICHANNEL RS-232 LINE DRIVER/RECEIVER WITH ±15kV ESD PROTECTION | TSSOP-20 |  | 1,462 | 1,462 |  |  | DONE | WL62
5 | U7 | 1 | AP1117E18G-13 | http://www.diodes.com/datasheets/AP1117.pdf | DIODES | 1A LOW DROPOUT 1.8V FIXED-MODE REGULATOR | SOT223-3L |  | 0,146 | 0,146 |  |  | DONE | WL63
6 | U8 | 1 | AP1117E33G-13 | http://www.diodes.com/datasheets/AP1117.pdf | DIODES | 1A LOW DROPOUT 3.3V FIXED-MODE REGULATOR | SOT223-3L |  | 0,146 | 0,146 |  |  | DONE | WL64
7 | U9 | 1 | XC3S500E-4VQG100C | http://www.xilinx.com/support/documentation/data_sheets/ds312.pdf | XILINX | SPARTAN-3E, SYSTEM GATES 500K, LOGIC CELLS 10476, DISTRIBUTED RAM BITS 73K, MAXIMUM USER IO 232 | 100-pin Very Thin Quad Flat Pack (VQFP) |  | 21,000 | 21,000 |  |  | DONE | WL193
8 | U10 | 1 | AP1122EG-13 | http://www.diodes.com/datasheets/AP1122.pdf | DIODES | 1A LOW DROPOUT 1.2V FIXED-MODE POSITIVE REGULATOR | SOT223-3L |  | 0,175 | 0,175 |  |  | DONE | WL65
10 | U12 | 1 | MIC811TUY | http://www.micrel.com/_PDF/mic811-812.pdf | MICREL | Microprocessor Reset Circuits 3.08V THRESHOLD 140ms minimum reset pulse | SOT-143 |  | 0,263 | 0,263 |  |  | DONE | WL67
11 | UF2 | 1 | LP3988IMF-2.5 | http://www.national.com/ds/LP/LP3988.pdf | NS | 150mA ULTRA LOW DROPOUT COMS 2.5V FIXED-MODE REGULATOR WITH POWER GOOD | SOT-23-5 |  | 0,263 | 0,263 |  |  | DONE | WL68
12 | Y1 | 1 | P1AT26070327681220AD | http://downloads.qi-hardware.com/hardware/qi_avt2/v1.0/datasheet/Y1~QI%20AT2607-032768-12.5PF-20-QA~YOKETAN~.pdf | YOKETANT | AT26 Crystal 32.768KHz 12.5pF 2 x 6mm ±20ppm | 2*6mm |  | 0,055 | 0,055 |  |  | DONE | WL21
13 | Y2 | 1 | P1AT2608012000FA2030A | http://downloads.qi-hardware.com/hardware/qi_avt2/v1.0/datasheet/Y2~QI%20AT2608-012000-F20-YYY-YQA~20PF~YOKETAN~.pdf | YOKETANT | AT26 Crystal 12MHz 20pF 2 x 6mm ±30ppm | 2*6mm |  | 0,085 | 0,085 |  |  | DONE | WL22
14 | Y3 | 1 | SO5032-050000-O3A-BBE-QA | http://downloads.qi-hardware.com/hardware/sakc/datasheet/Y3~SO5032-050000-O3A-BBE-QA.pdf | YOKETANT | OSC, 3.2X5MM, CER, 50.000MHZ, SMD | 3.2*5mm |  | 0,778 | 0,778 |  |  | DONE | WL194
18 | D1, D5, D6, D7 | 4 | 30272010107T |  | EVERLIGHT | RED LED LAMP SURFACE MOUNT 1.6mm * 0.8mm 19-213VRC/S530-A3/TR8 | 0603 |  | 0,015 | 0,058 | BL-HS136D-TR | http://downloads.qi-hardware.com/hardware/sakc/datasheet/D1_5~BL-HS136D-TR.pdf | DONE | WL69
19 | J1 | 1 | TFC014A-YS | http://downloads.qi-hardware.com/hardware/qi_avt2/v1.0/datasheet/J1~TFC014x-YS(090122).pdf | TAKEWING | Micro SD Memory Card CONN | TFC014A-YS |  | 0,309 | 0,309 |  |  | DONE | WL31
20 | J6, J7 | 1 | MD241844 | http://www.stm.com.tw/test/pdf-1/c24184.pdf | STM | SIP 4 POS PITCH 2.54mm 2*4PINS | 2.54mm Pitch | FREE |  | 0,000 |  |  | DONE
21 | J8 | 1 | B034-3130-YS | http://downloads.qi-hardware.com/hardware/qi_avt2/v1.0/datasheet/J2~B034-xxxx-YS.pdf | TAKEWING | MINI USB B TYPE 5F SMT | B034-3130-YS |  | 0,093 | 0,093 |  |  | DONE | WL32
22 | J15, J18 | 2 | MD241841 | http://www.stm.com.tw/test/pdf-1/c24184.pdf | STM | SIP 2POS PITCH 2.54mm 2*1PINS | 2.54mm Pitch | FREE |  | 0,000 |  |  | DONE
24 | J17 | 1 | SCD441CPS011B00G | http://www.scpre.com.tw/D1-D21/d8.htm | SCPRE | SOCKET, PCB, DC POWER, 2.1mm | DC JACK 2.1mm |  | 0,090 | 0,090 |  |  | DONE | WL217/ not mounted
25 | EXP1 | 1
26 | EXP2 | 1
27 | R4, R12, R15 | 3 | RC0603JR-0733RL | http://www.yageo.com/pdf/PYu-RC0603_51_RoHS_L_4.pdf | YAGEO | Resistor, 33, 0603, 5% | 0603 |  | 0,030 | 0,090 |  |  | DONE | WL198
28 | R18, R19, R20, R21 | 4 | RC0603JR-0768RL | http://www.yageo.com/pdf/PYu-RC0603_51_RoHS_L_4.pdf | YAGEO | Resistor, 68, 0603, 5% | 0603 |  | 0,030 | 0,120 |  |  | DONE | WL199
29 | R25, R26, R30, R31 | 4 | RC0603JR-071KL | http://www.yageo.com/pdf/PYu-RC0603_51_RoHS_L_4.pdf | YAGEO | Resistor, 1K, 0603, 5% | 0603 |  | 0,030 | 0,120 |  |  | DONE | WL200
30 | R1 | 1 | RC0603JR-071K5L | http://www.yageo.com/pdf/PYu-RC0603_51_RoHS_L_4.pdf | YAGEO | Resistor, 1.5K, 0603, 5% | 0603 |  | 0,030 | 0,030 |  |  | DONE | WL201
31 | R27, R28, R32, R33 | 4 | RC0603JR-074K7L | http://www.yageo.com/pdf/PYu-RC0603_51_RoHS_L_4.pdf | YAGEO | Resistor, 4.7K, 0603, 5% | 0603 |  | 0,055 | 0,220 |  |  | DONE | WL202
32 | R2 | 1 | 0603F2491T5E | http://www.royalohm.com/?gclid=CIeky6WoiKMCFQJCbgoduynRcw | ROYALOHM | Resistor, 2.49K, 0603, 1% | 0603 |  | 0,060 | 0,060 |  |  | DONE | WL99
33 | R6, R7, R10, R13, R14, R16, R17, R22, R23 | 9 | RC0603JR-0747KL | http://www.yageo.com/pdf/PYu-RC0603_51_RoHS_L_4.pdf | YAGEO | Resistor, 47K, 0603, 5% | 0603 |  | 0,030 | 0,270 |  |  | DONE | WL203
34 | R29 | 1 | RC0603JR-07100KL | http://www.yageo.com/pdf/PYu-RC0603_51_RoHS_L_4.pdf | YAGEO | Resistor, 100K, 0603, 5% | 0603 |  | 0,030 | 0,030 |  |  | DONE | WL204
35 | R5 | 2 | RC0603JR-071ML | http://www.yageo.com/pdf/PYu-RC0603_51_RoHS_L_4.pdf | YAGEO | Resistor, 1M, 0603, 5% | 0603 |  | 0,030 | 0,060 |  |  | DONE | WL205
37 | R3 | 1 | RC0603JR-0710ML | http://www.yageo.com/pdf/PYu-RC0603_51_RoHS_L_4.pdf | YAGEO | Resistor, 10M, 0603, 5% | 0603 |  | 0,027 | 0,027 |  |  | DONE | WL207
38 | C3, C4, C5, C6 | 4 | CC0603JRNPO9BN220 | http://www.yageo.com/pdf/UPY-GP_NP0_16V-to-50V_3.pdf | YAGEO | MLCC, NPO, 50V, 22pF, 5%, SMD | 0603 |  | 0,040 | 0,159 |  |  | DONE | WL208
39 | C15 | 1 | CC0603KRX7R9BB103 | http://www.yageo.com/pdf/UPY-GPHC_X7R_6.3V-to-50V_4.pdf | YAGEO | MLCC, X7R, 50V, 10nF, 10%, SMD | 0603 |  | 0,003 | 0,003 |  |  | DONE | WL209
40 | C13, C16, C19, C20, C21, C22, C23, C24, C25, C26, C27, C28, C30, C31, C32, C33, C34, C35, C36, C37, C38, C39, C40, C41, C42, C43, C44, C45, C46, C47, C48, C49, C50, C51, C52, C53, C54, C55, C57, C60 | 40 | CC0603KRX7R7BB104 | http://www.yageo.com/pdf/UPY-GPHC_X7R_6.3V-to-50V_4.pdf | YAGEO | MLCC, X7R, 16V, 100nF, 10%, SMD | 0603 |  | 0,003 | 0,104 |  |  | DONE | WL210
41 | C1, C2, C10, C11 | 4 | CC0603KRX7R7BB105 | http://www.yageo.com/pdf/UPY-GPHC_X7R_6.3V-to-50V_4.pdf | YAGEO | MLCC, X7R, 16V, 1uF, 10%, SMD | 0603 |  | 0,084 | 0,337 |  |  | DONE | WL211
42 | C12, C14, C17, C18, C29, C56, C74 | 7 | TAJA106K010RNJ | http://datasheet.octopart.com/TAJA106K010RNJ-AVX-datasheet-111970.pdf | AVX | TANTALUM, 10V, 10uF, 10%, SMD | 1206 |  | 0,044 | 0,307 |  |  | DONE | WL70
46 | L1, L2, L3, L4, L5, L6, L7, L9 | 8 | PZ1608D221TF | http://downloads.qi-hardware.com/hardware/qi_avt2/v1.0/datasheet/BD2_3_6_7_8_9_10~PZ1608D221.pdf | SUNLORD | Multilayer Chip Ferrite Bead 220±25%Ω 1.6mm x 0.8mm 1A | 0603 |  | 0,013 | 0,105 |  |  | DONE | WL26
48 | PB1, PB2, PB3 | 3 | TL1105SF160Q | http://spec.e-switch.com/P-J/P010299D.pdf | E-SWITCH | Tact Switch 6mm*6mm 160±50gf 50mA @ 12 VDC | THROUGH HOLE |  | 0,512 | 1,535 |  |  | DONE | WL221
51 | LCM | 1 | GPM940B0 | http://downloads.qi-hardware.com/hardware/qi_avt2/v1.0/datasheet/LCM~GPM940B0-SPEC_A_2009.01.13~~FINAL_LCM-NOT_ON_SOME_PROTOTYPES~~.pdf | GIANT PLUS | 960x240, 16.7M, Digital RGB 8bits, ILI8960, 2 LEDs Series / 20mA, 70.2(W)x51.4(H)x2.65(D) | MODULE |  | 12,000 | 12,000 |  |  | DONE | WL214
52 | PCB | 1 | SIE V2 PCB | http://en.qi-hardware.com/wiki/SIE_PCB_V2 | SIN YING | SIE V2 PCB |  |  | 6,000 | 6,000 |  |  | DONE | WL222
53 | Jumpers | 2 | MJ501-OXX-X-X | http://php2.twinner.com.tw/files/townes/MJ501X-XXX-X-X.pdf | TOWNES | Mini Jumper 2.54mm |  | FREE |  | 0,000 |  |  | DONE | WL224
54 | ANTI-STATIC BAG | 1 | PBD14011030 | http://www.pushco.com.tw/ | PUSH | 抗靜電雙層氣泡袋開口14*長11+舌片3CM |  |  | 0,140 | 0,140 |  |  | DONE | WL223
55 | CABLE | 1 |  | http://www.sunty.cc | SUNTY | MINI USB B TO USB A CABLE |  |  | 0,450 | 0,450 |  |  | DONE
56 |  | 1 | SMT/DIP |  | MINBO | MOUNTING PARTS |  |  | 18,899 | 18,899
 |  |  |  |  |  |  |  |  | TOTAL | 78,06
