IndustriasBizarras/SIE/software/sie_cg/test1.png

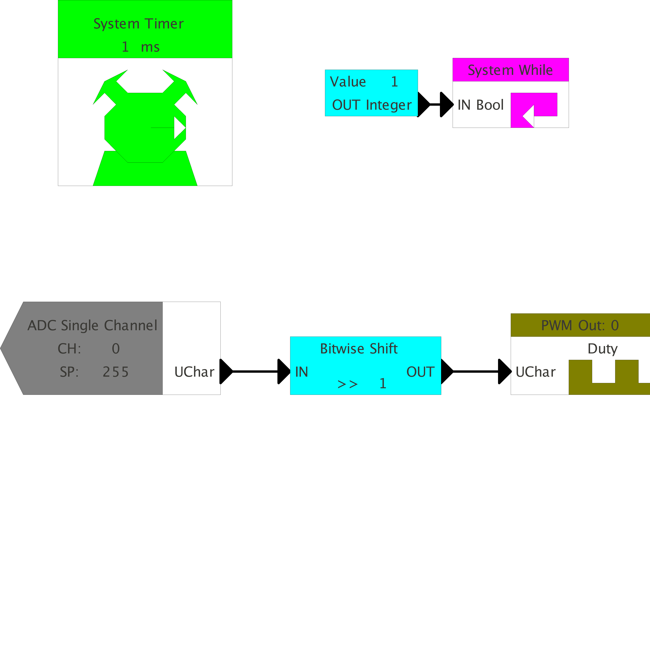
software/sie_cg/test1.png
