IndustriasBizarras/SIE/PCB/Orcad/sie_orcad_v1.1/SIE_V3.pdf

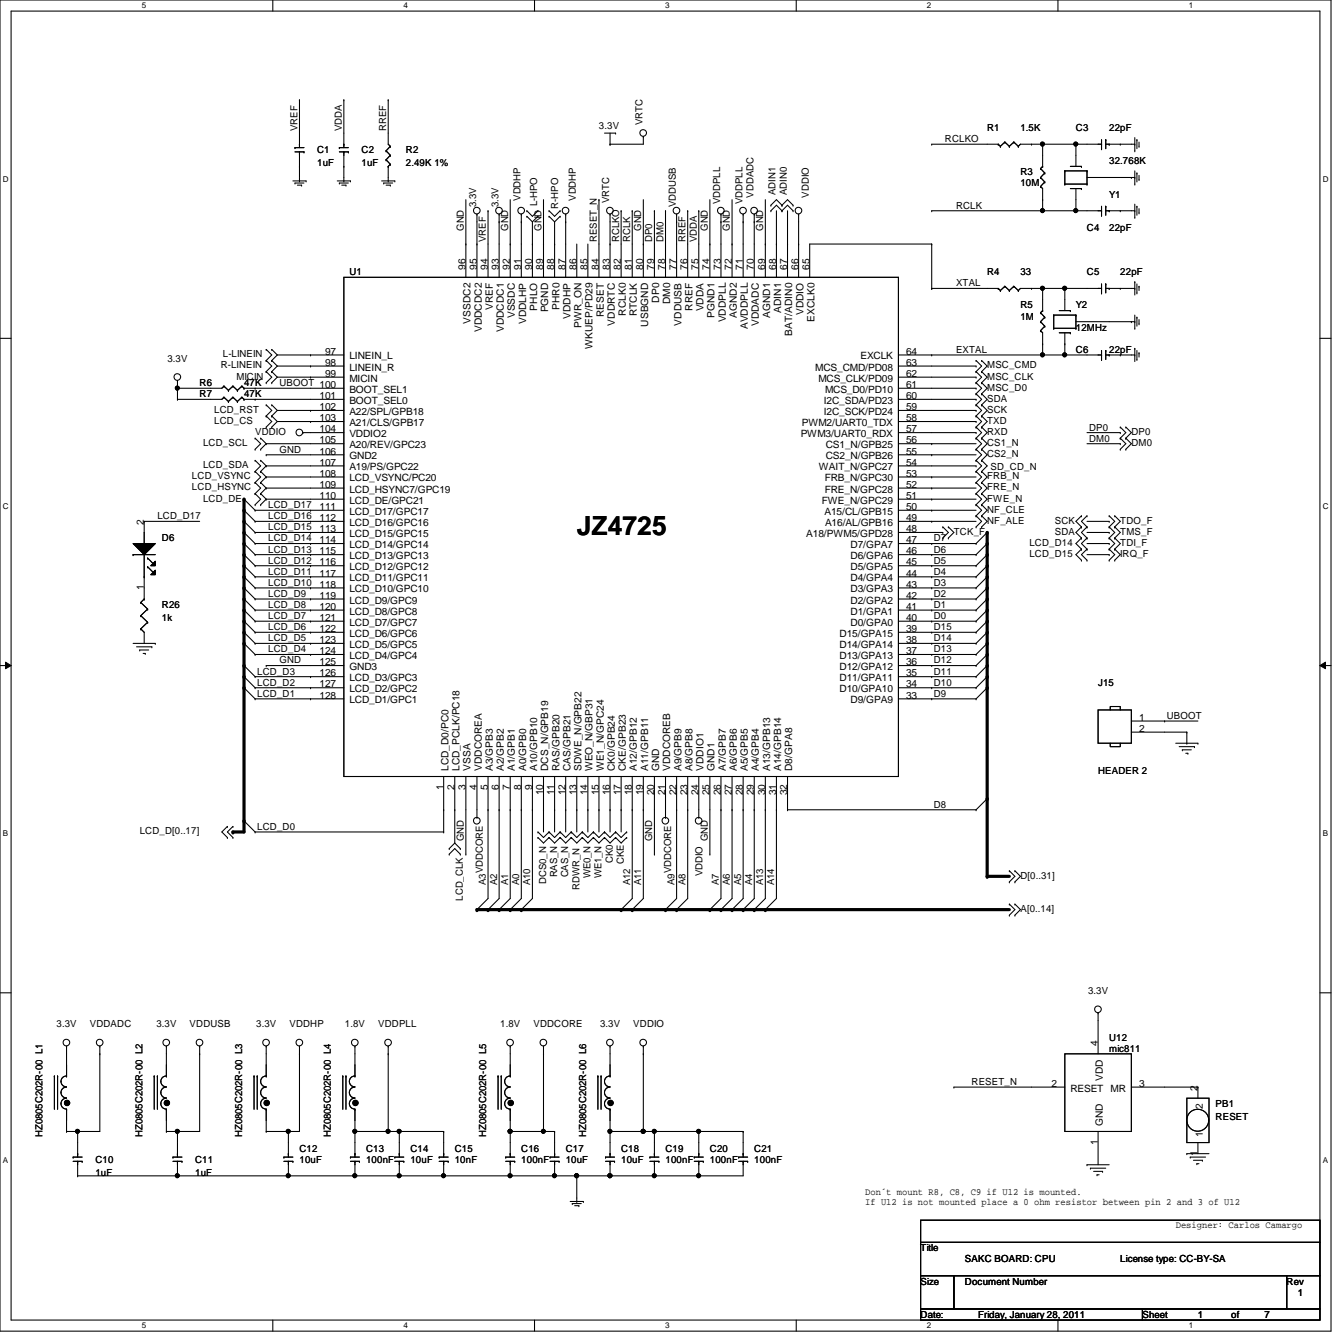
[picture p73: page 1]

Don´t mount R8, C8, C9 if U12 is mounted.
If U12 is not mounted place a 0 ohm resistor between pin 2 and 3 of U12

License type: CC-BY-SA

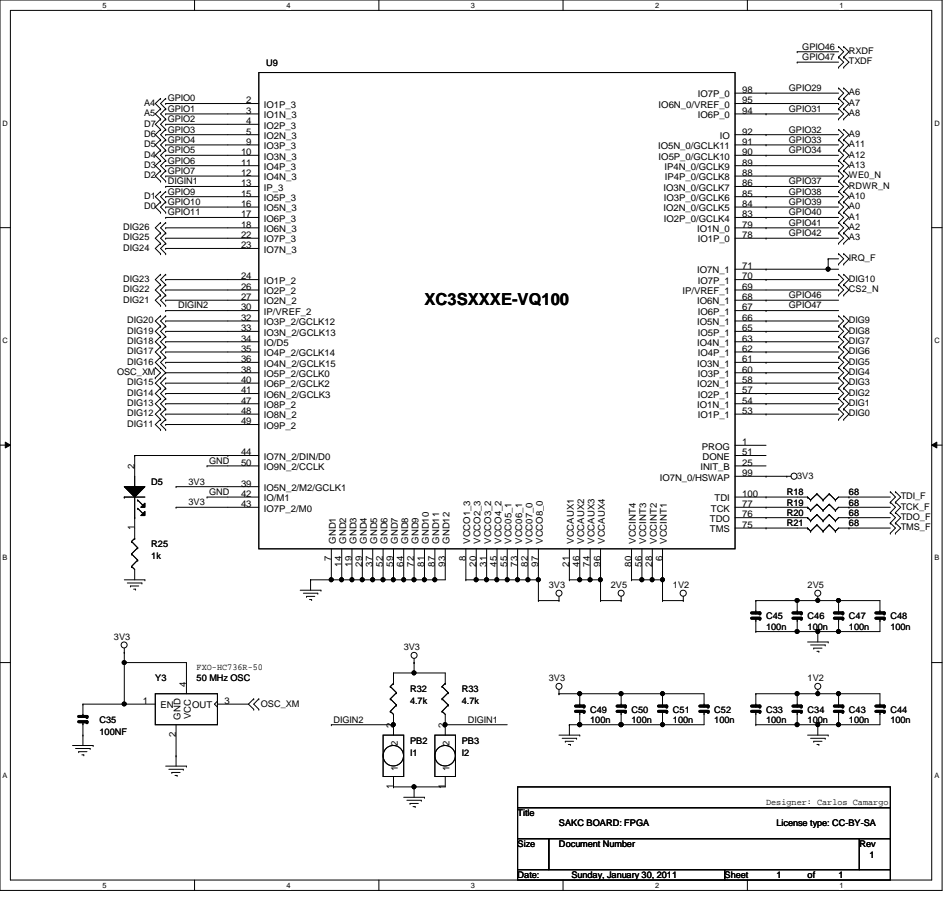
[picture p74: page 2]

Designer: Carlos Camargo
License type: CC-BY-SA

## MLC NAND Flash SDRAM

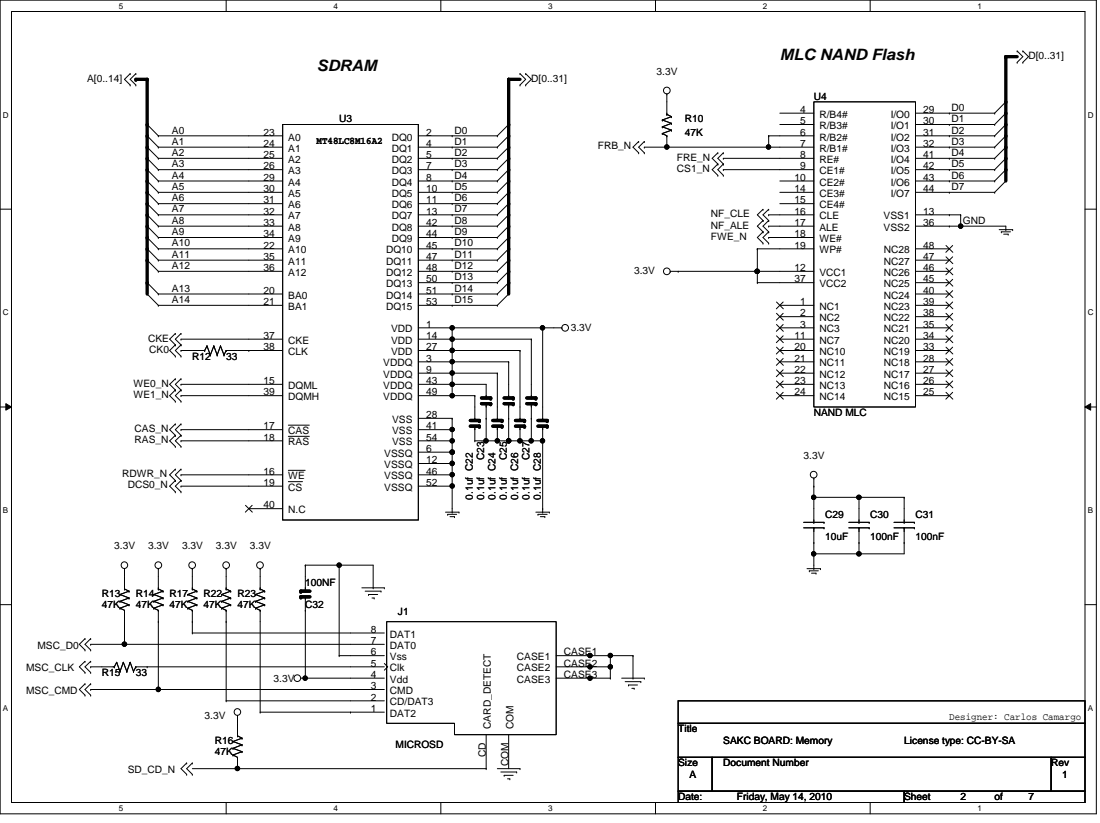
[picture p75: page 3]

License type: CC-BY-SA

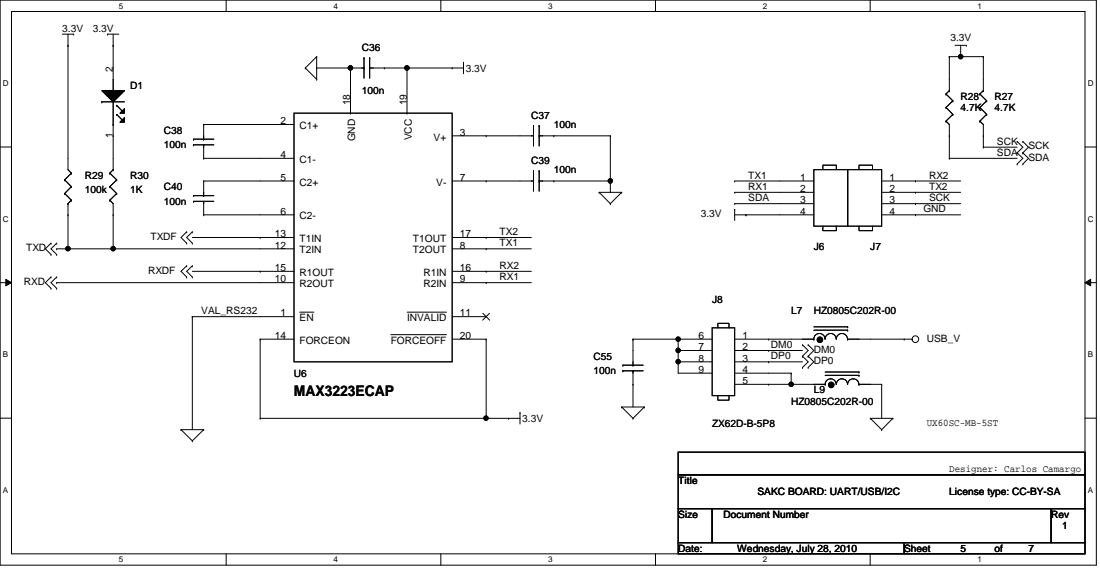
[picture p76: page 4]

Designer: Carlos Camargo
License type: CC-BY-SA

SAKC BOARD: UART/USB/I2C

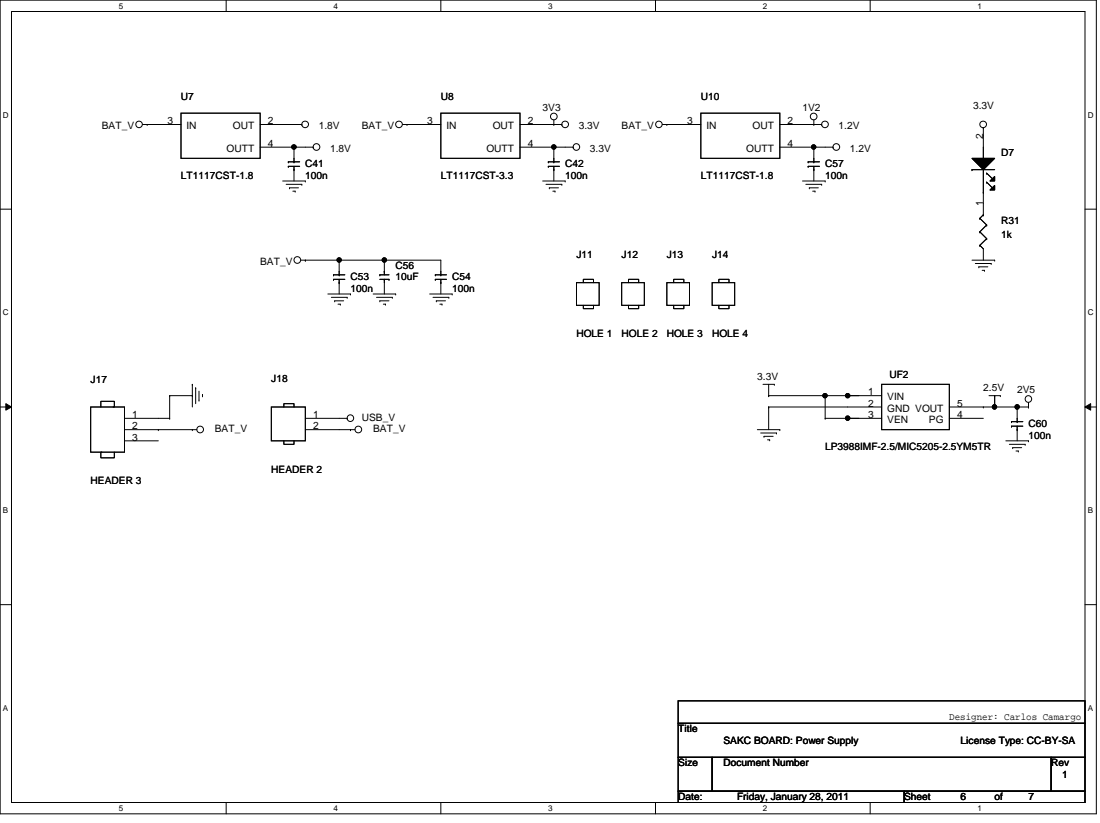
[picture p77: page 5]

Designer: Carlos Camargo
License Type: CC-BY-SA

SAKC BOARD: Power Supply

3.3V
3.3V

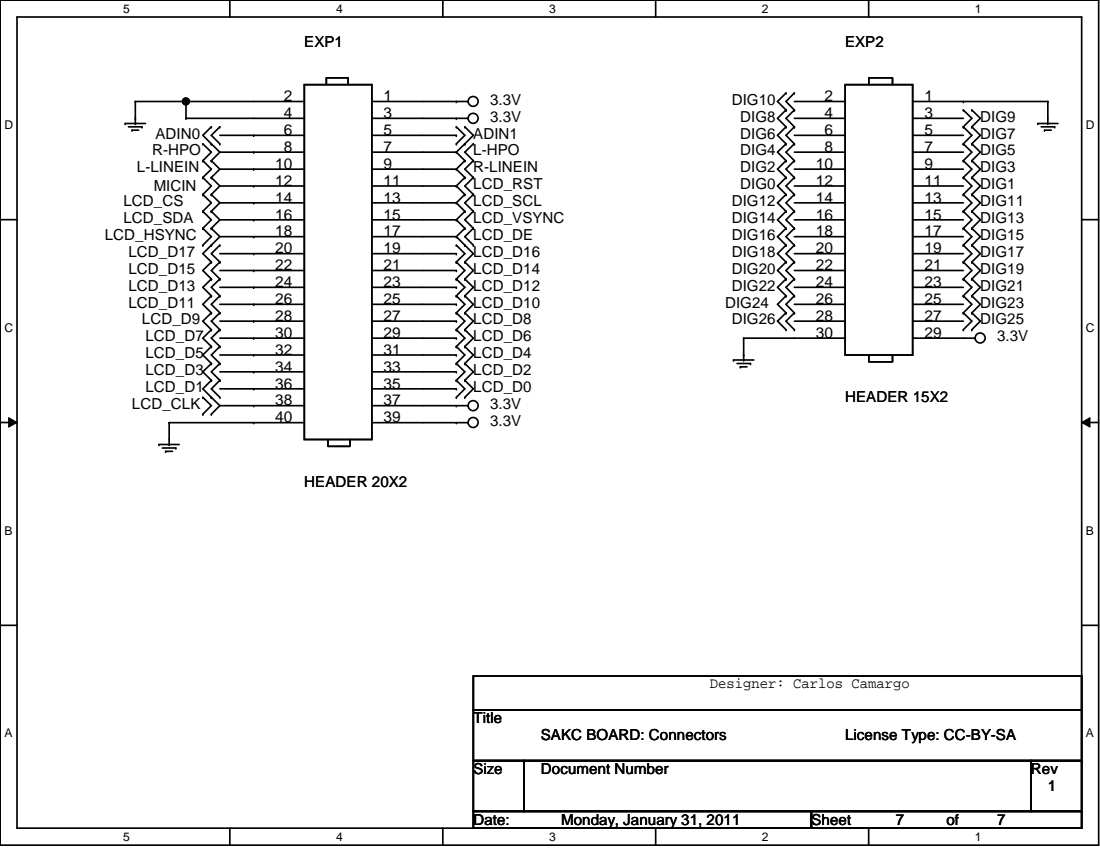
[picture p78: page 6]
ADIN1 L-HPO R-LINEIN; MICIN; L-LINEIN; R-HPO; ADIN0; LCD_RST; LCD_CS; LCD_SCL; LCD_SDA; LCD_VSYNC; LCD_HSYNC; LCD_DE; LCD_D17; LCD_D11; LCD_D13; LCD_D15; LCD_D16; LCD_D10; LCD_D12; LCD_D14; LCD_D9 LCD_D7; LCD_D1; LCD_D3; LCD_D5; LCD_D6; LCD_D0; LCD_D2; LCD_D4; LCD_D8; LCD_CLK; DIG14 DIG16 DIG18 DIG20 DIG22; DIG15 DIG17 DIG19 DIG21; DIG24; DIG23; DIG26; DIG25; DIG0; DIG13; DIG12; DIG11; DIG1; DIG2; DIG3; DIG4; DIG5; DIG6; DIG7; DIG8; DIG9; DIG10; Title; Size; Document Number; Rev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

Designer: Carlos Camargo

SAKC BOARD: Connectors

License Type: CC-BY-SA
