IndustriasBizarras/SIE/Examples/moto_display/SCHEMATICS/pruebaconec.pdf

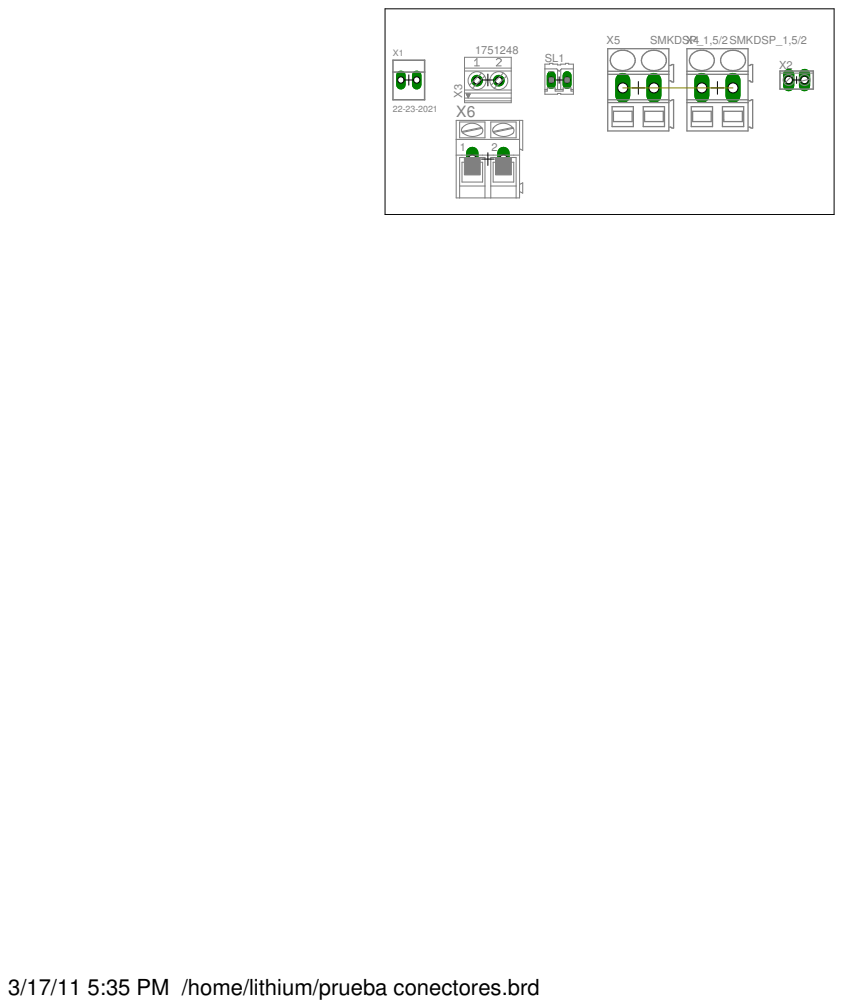
[picture p79: page 1]

3/17/11 5:35 PM /home/lithium/prueba conectores.brd
