IndustriasBizarras/SIE/PCB/Kicad/sie_kicad_mini/SIE Sin FPGA.pdf

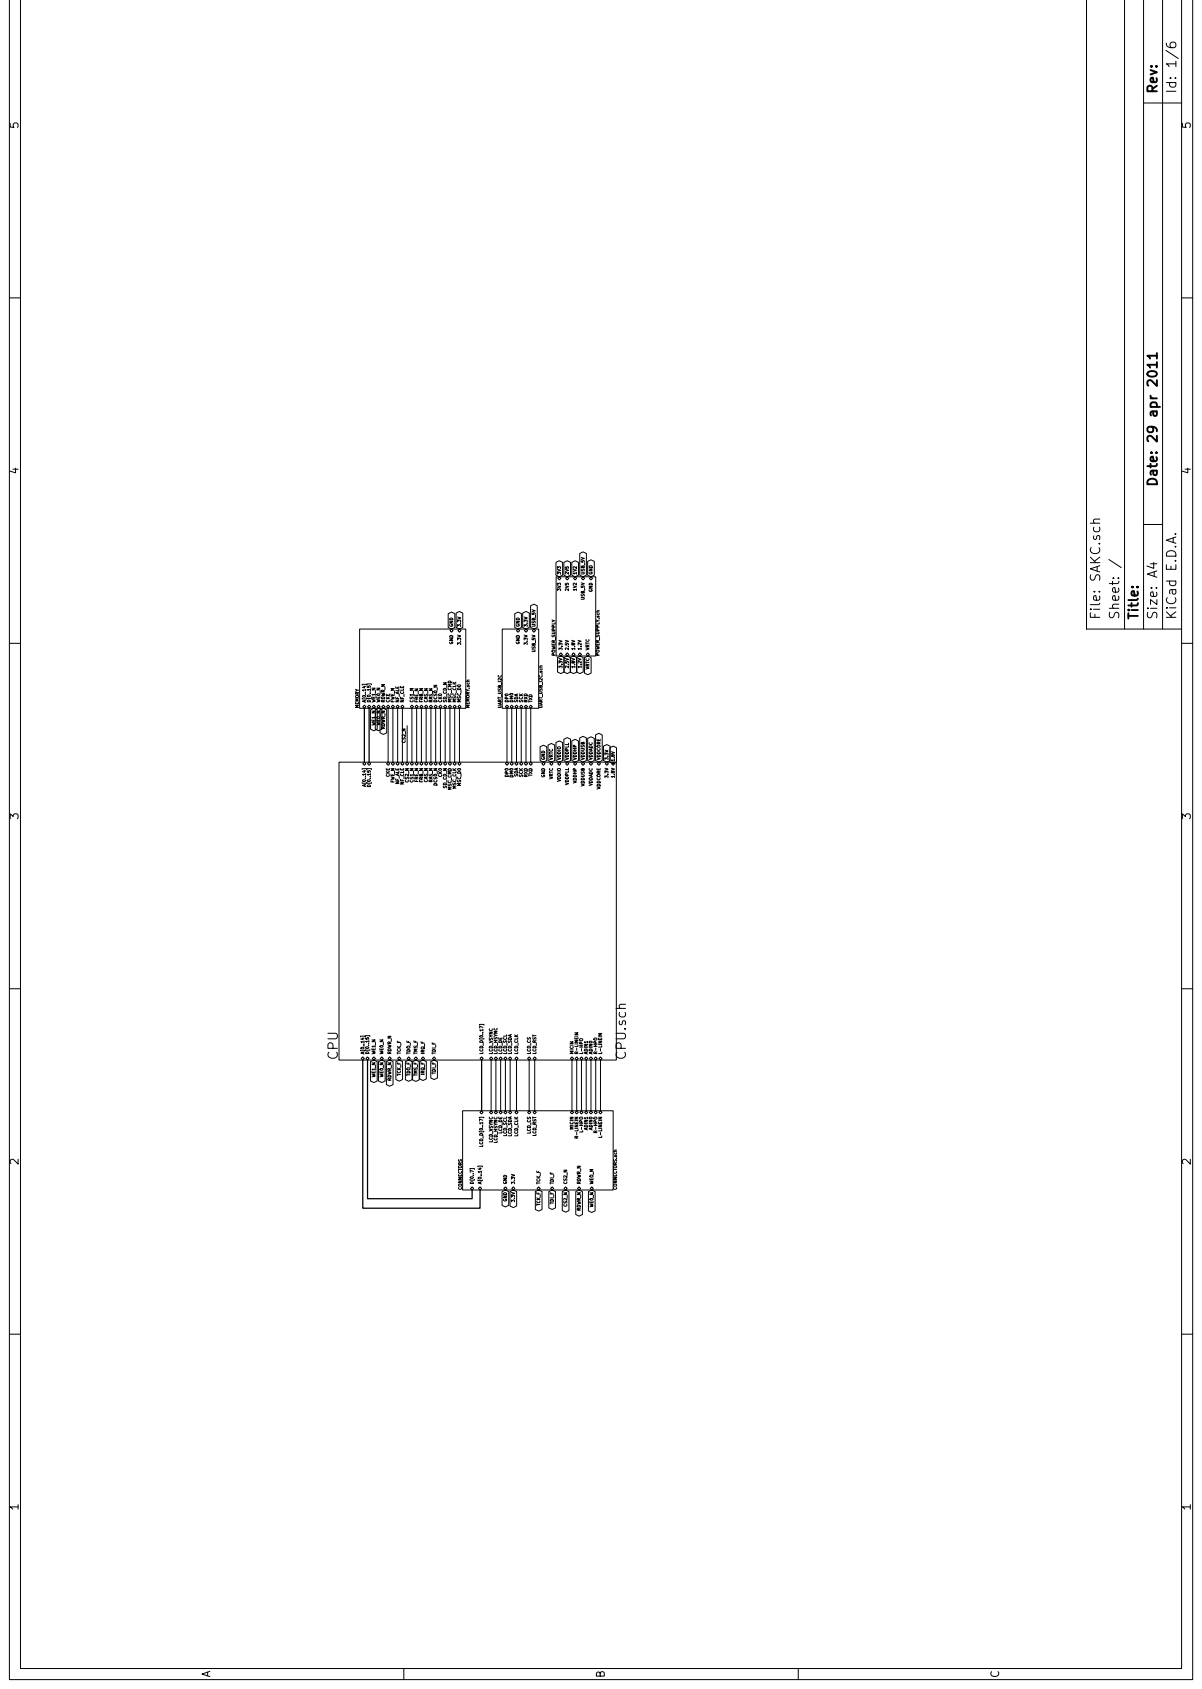
[picture p80: page 1]

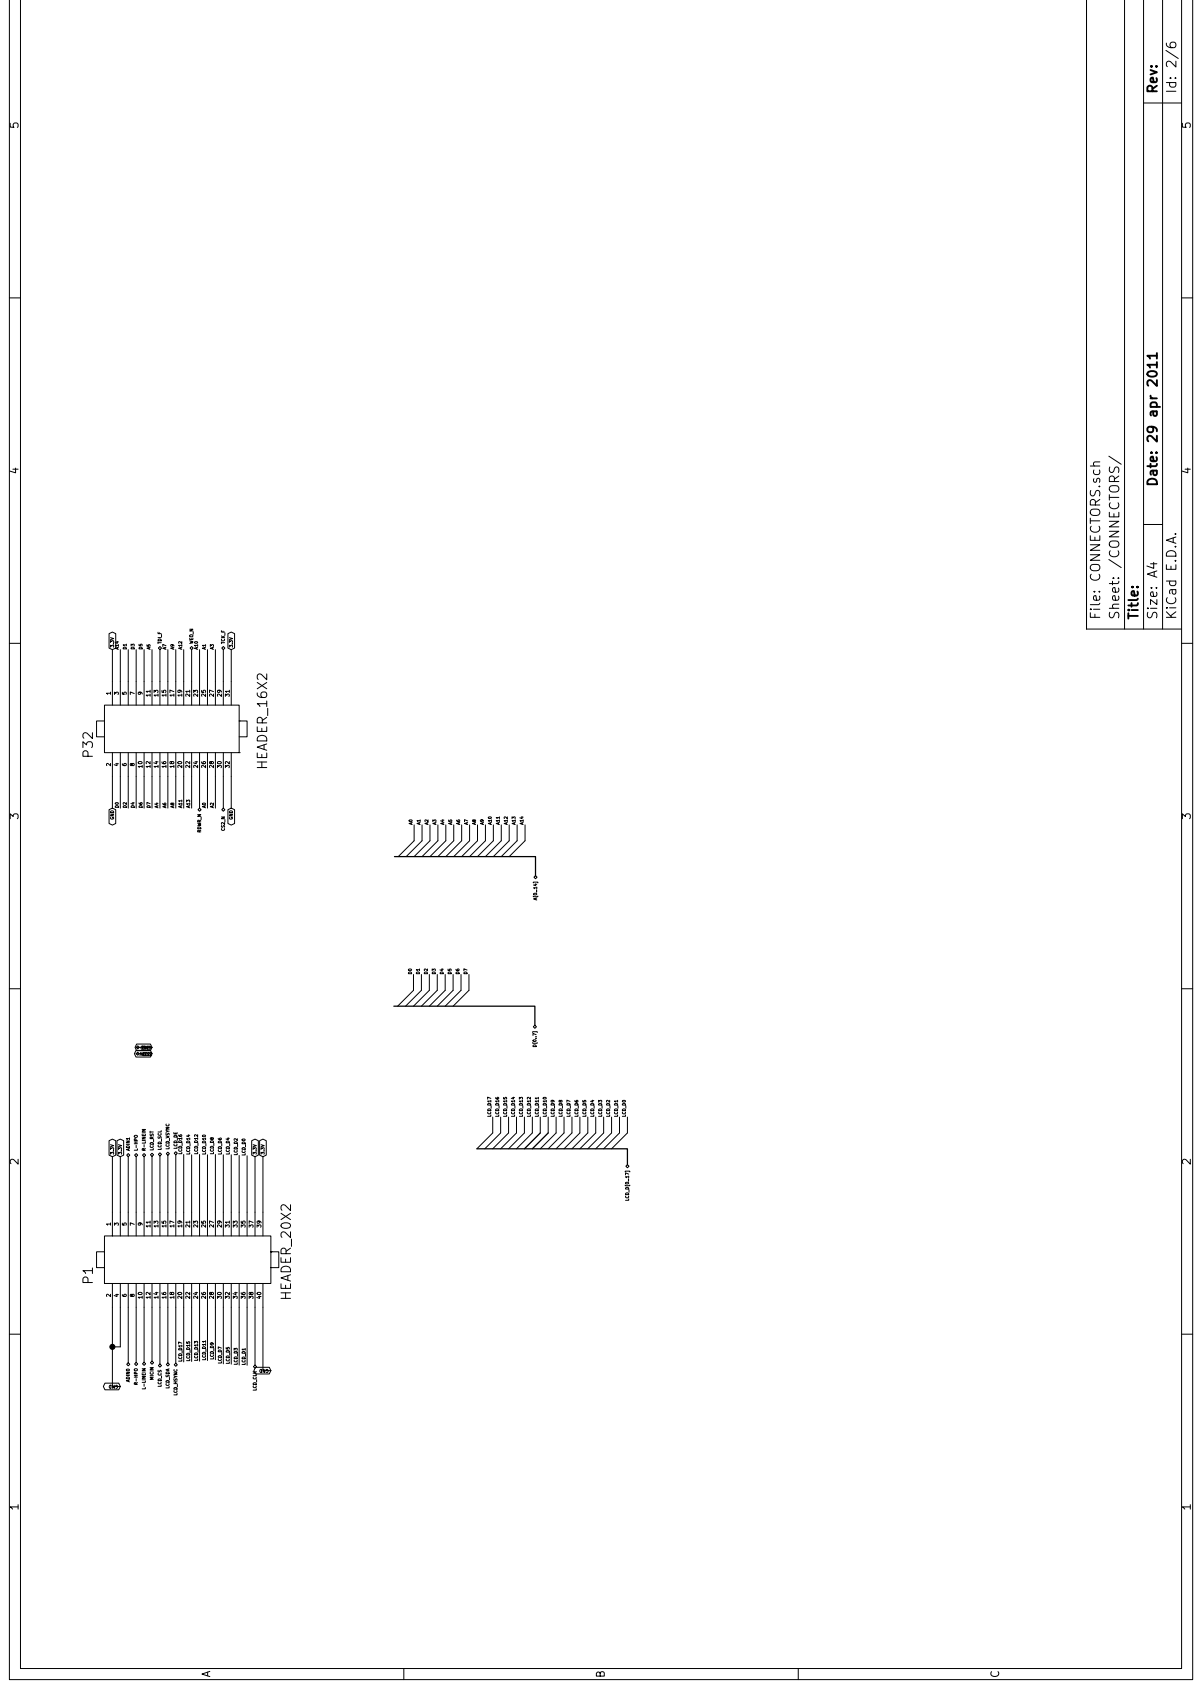
[picture p81: page 2]

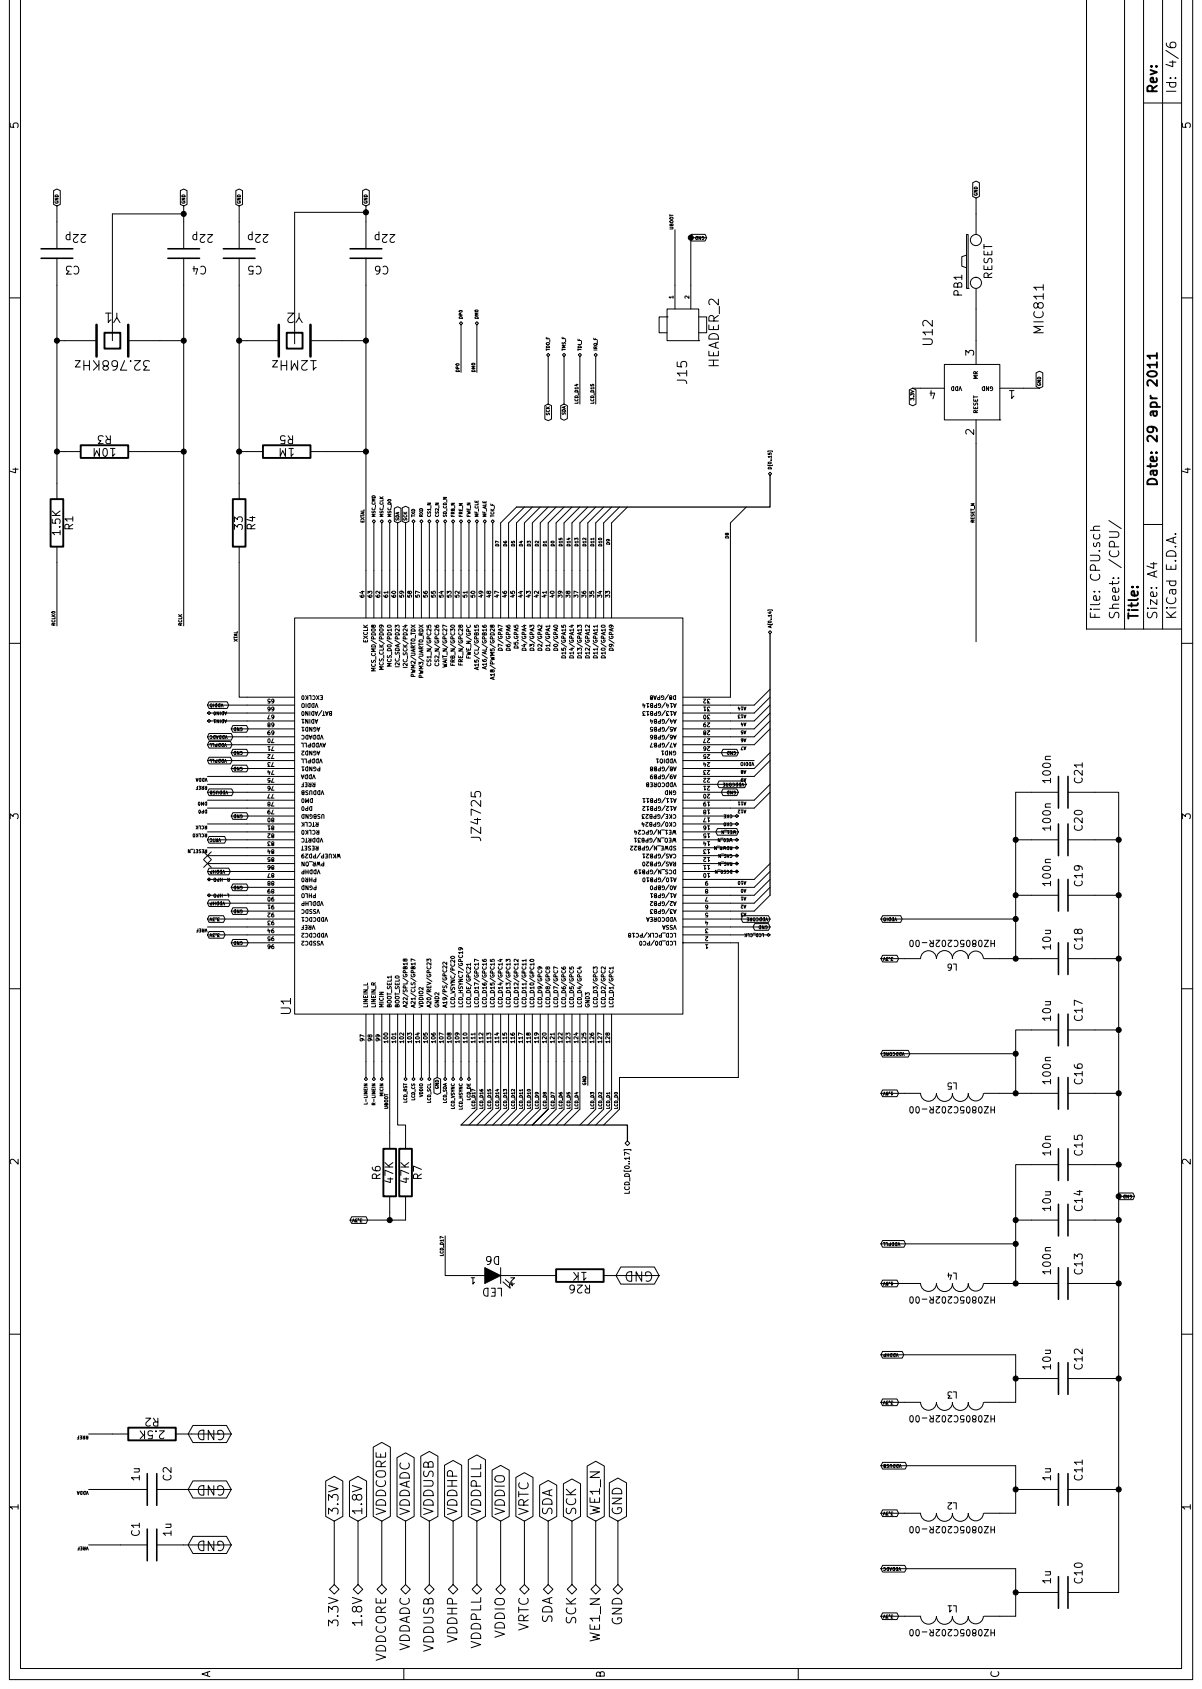
[picture p82: page 3]

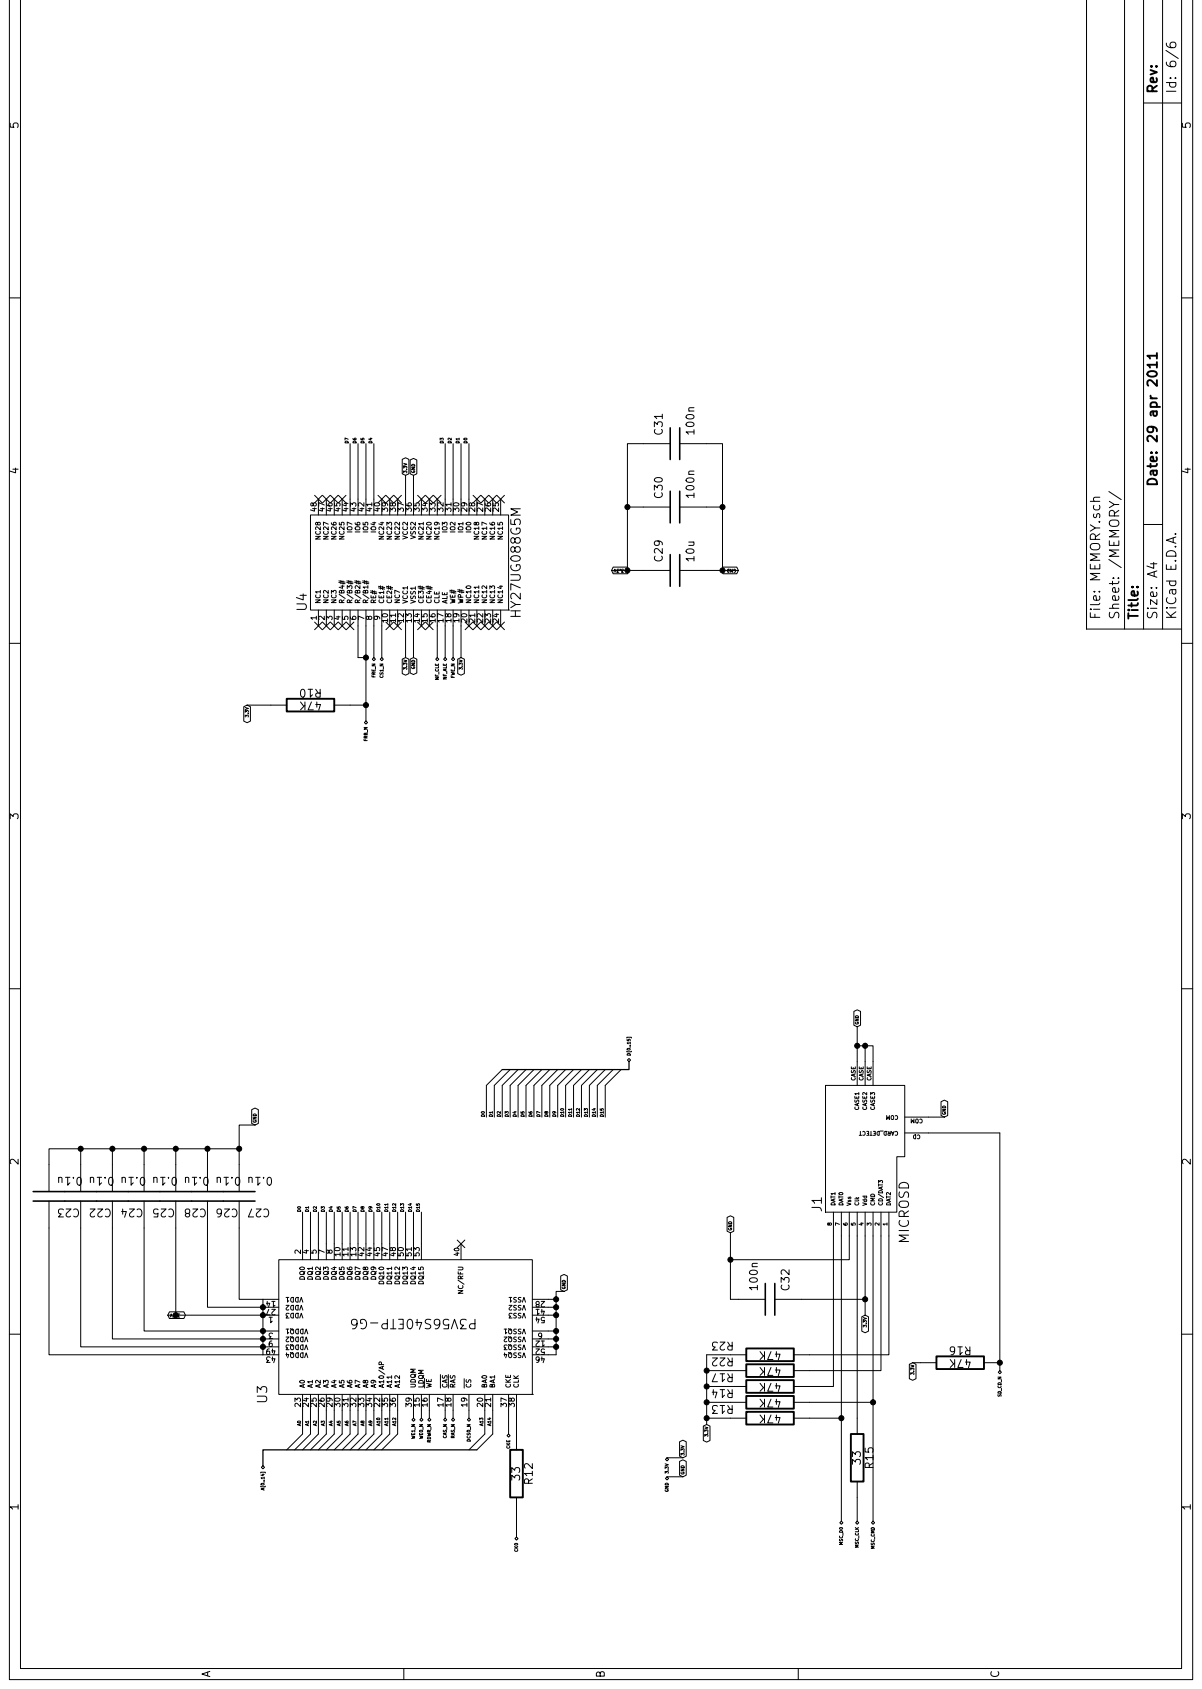
[picture p83: page 4]

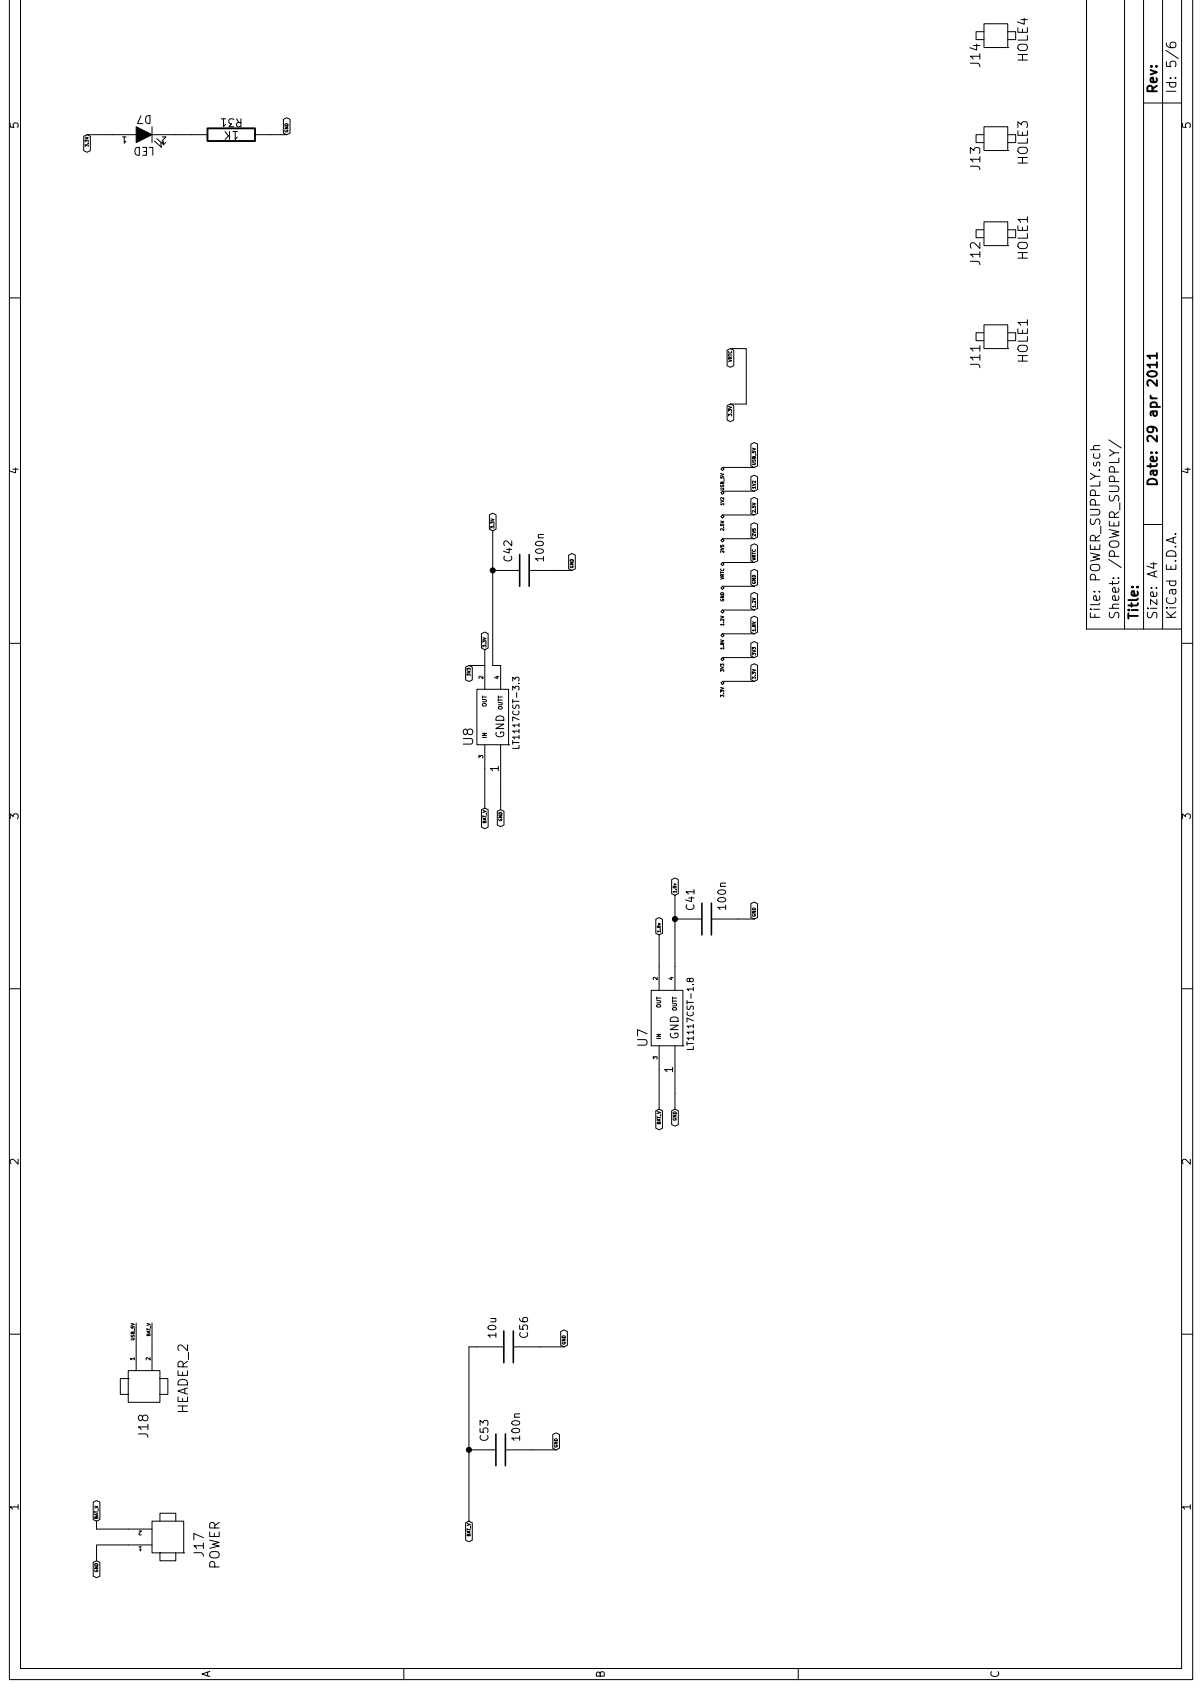
[picture p84: page 5]

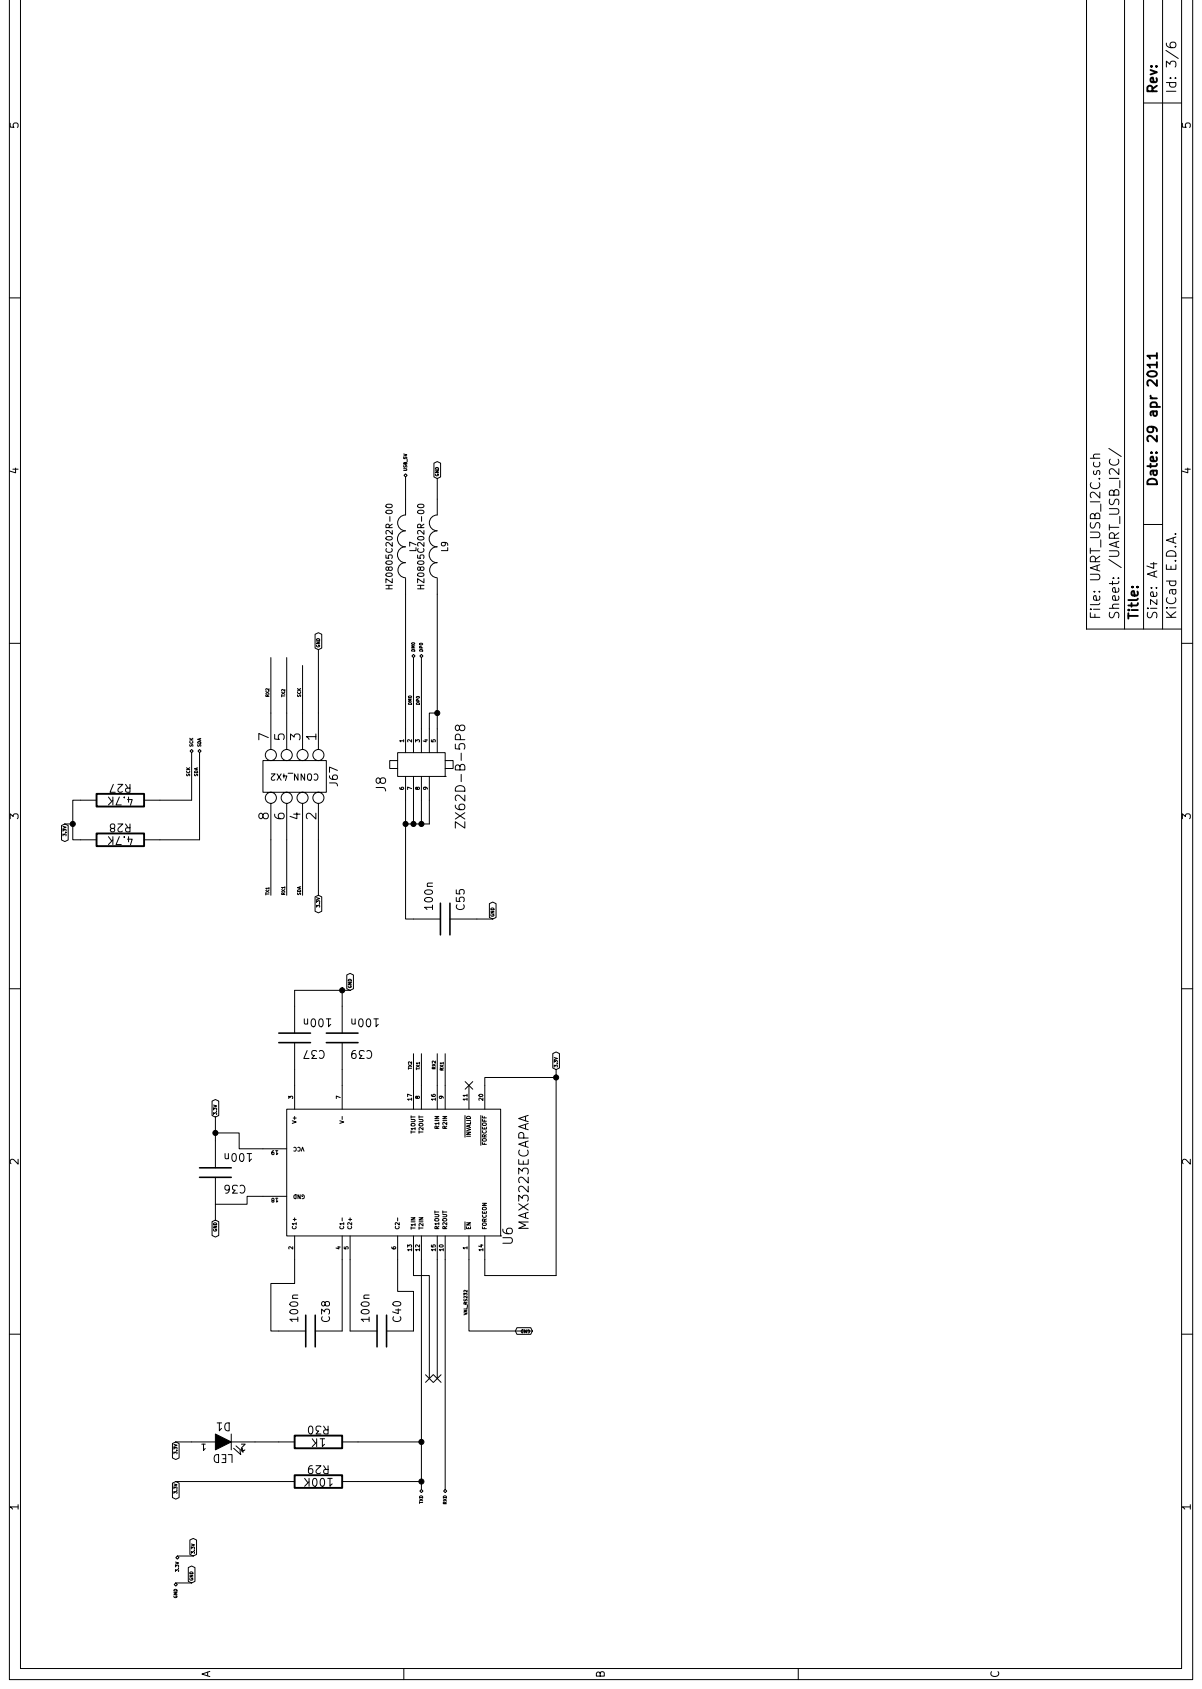
[picture p85: page 6]
