IndustriasBizarras/SIE/PCB/Orcad/sie_orcad_v1/SAKC.pdf

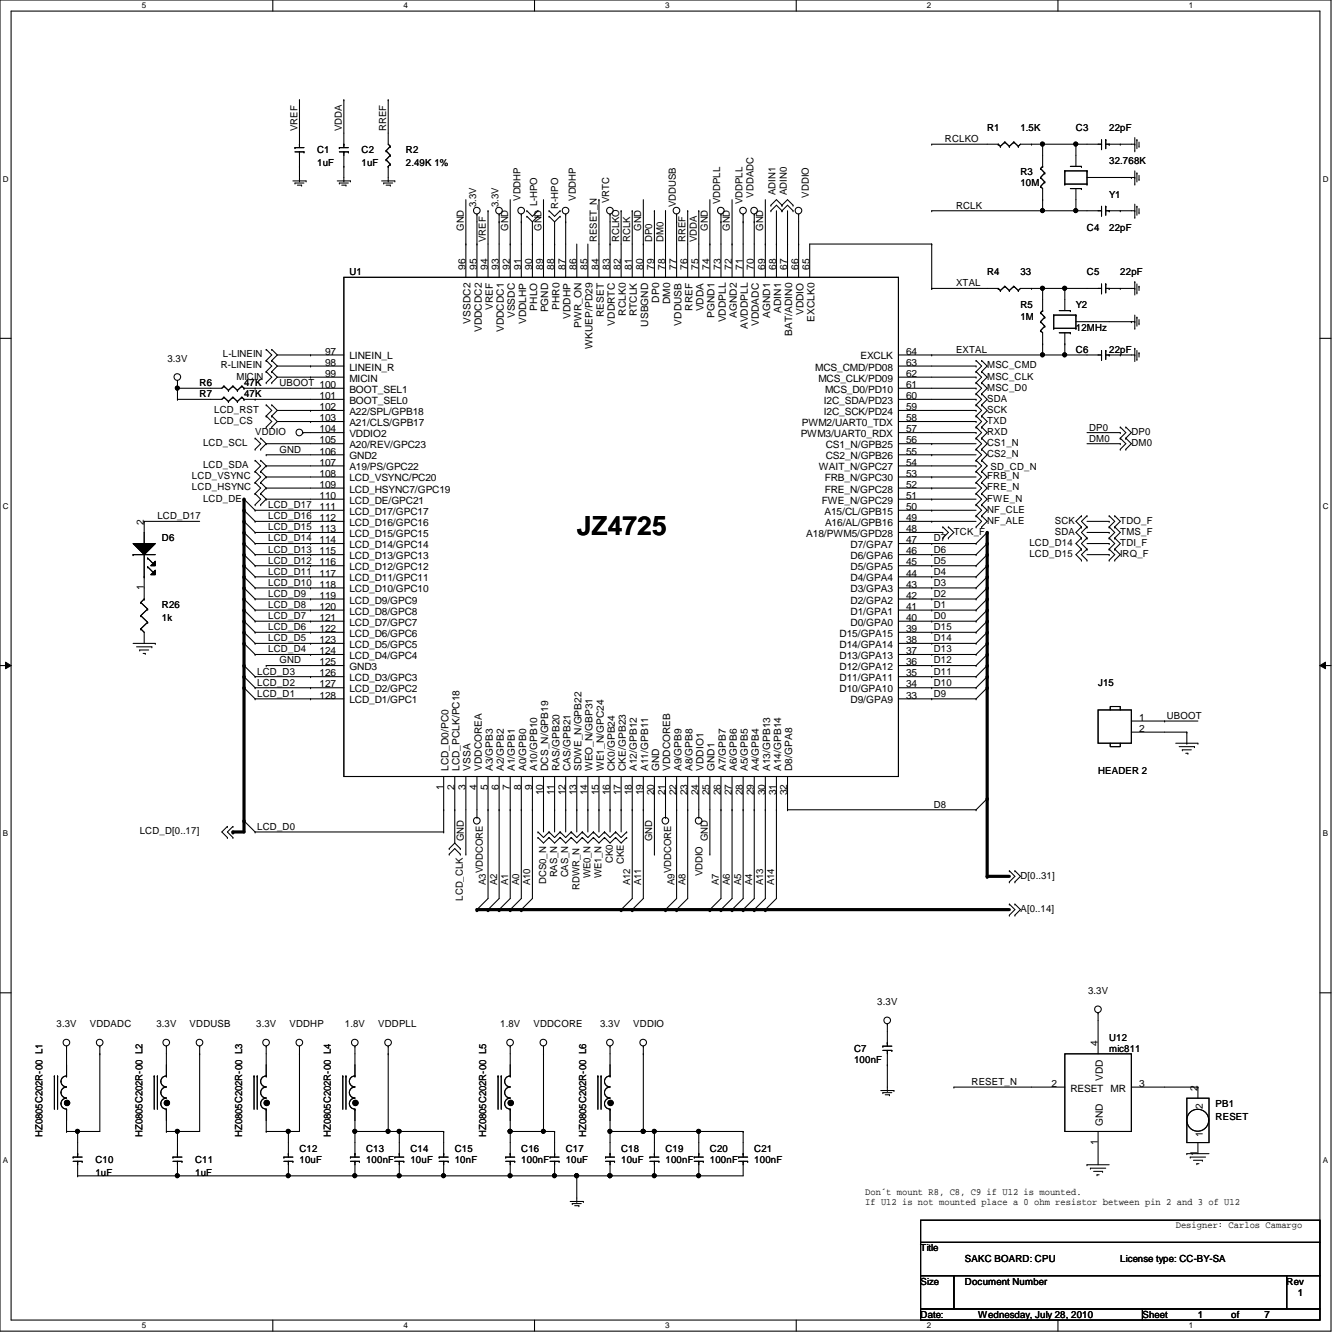
[picture p86: page 1]

Don´t mount R8, C8, C9 if U12 is mounted.
If U12 is not mounted place a 0 ohm resistor between pin 2 and 3 of U12

License type: CC-BY-SA

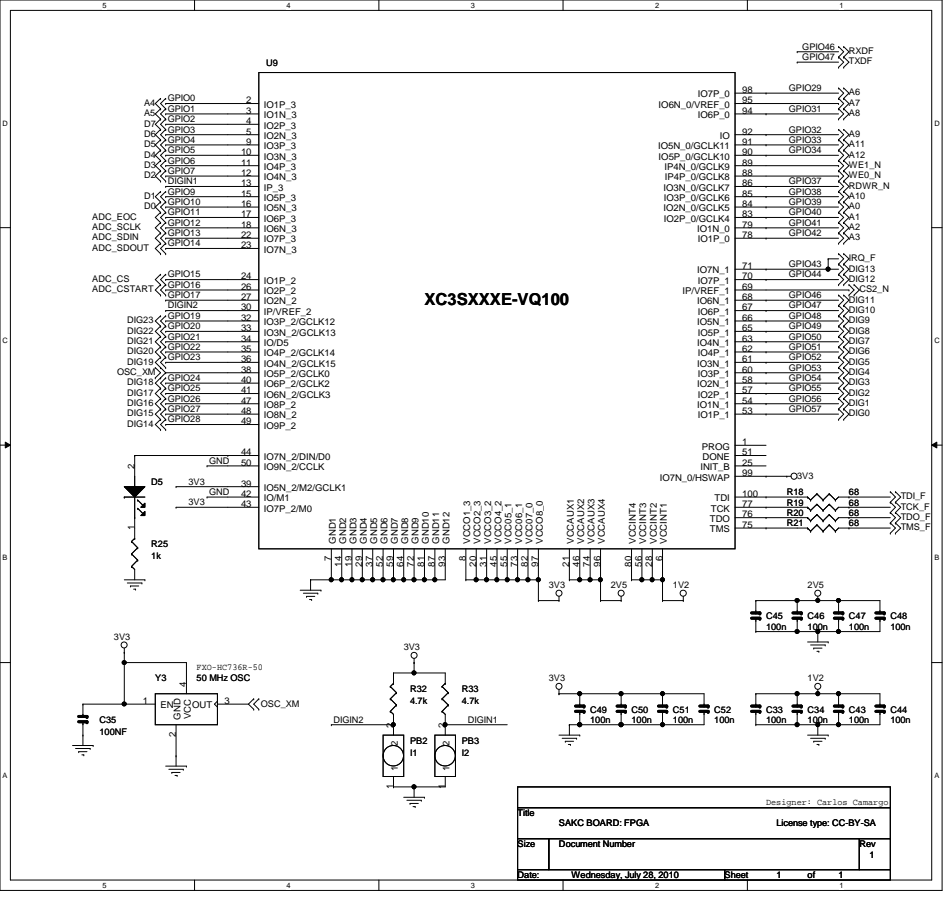
[picture p87: page 2]

Designer: Carlos Camargo
License type: CC-BY-SA

ADC_SDOUT; ADC_EOC; ADC_SCLK; ADC_SDIN; ADC_CS ADC_CSTART; AN_GND; ANALOG0 ANALOG1 ANALOG2 ANALOG3 ANALOG4 ANALOG5 ANALOG6 ANALOG7; ADC_VREF; Title; Size; Document Number; Rev; Friday, May 14, 2010; TLV1548; REF+ 14 REF- 13; EOC 19; nCS 15 nCSTART 9; nINVCLK 11; I/OCLK 18; D_IN 17 D_OUT 16; VADC; 20 GND_ADC

Designer: Carlos Camargo
License Type: CC-BY-SA

SAKC BOARD: A/D Converter

## MLC NAND Flash SDRAM


License type: CC-BY-SA

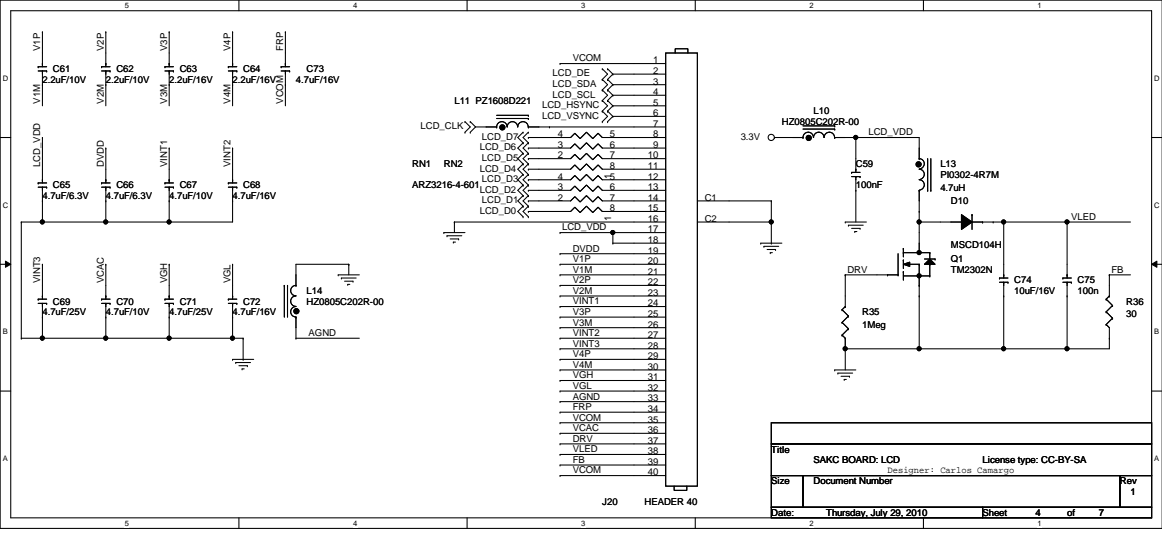
[picture p88: page 5]

License type: CC-BY-SA

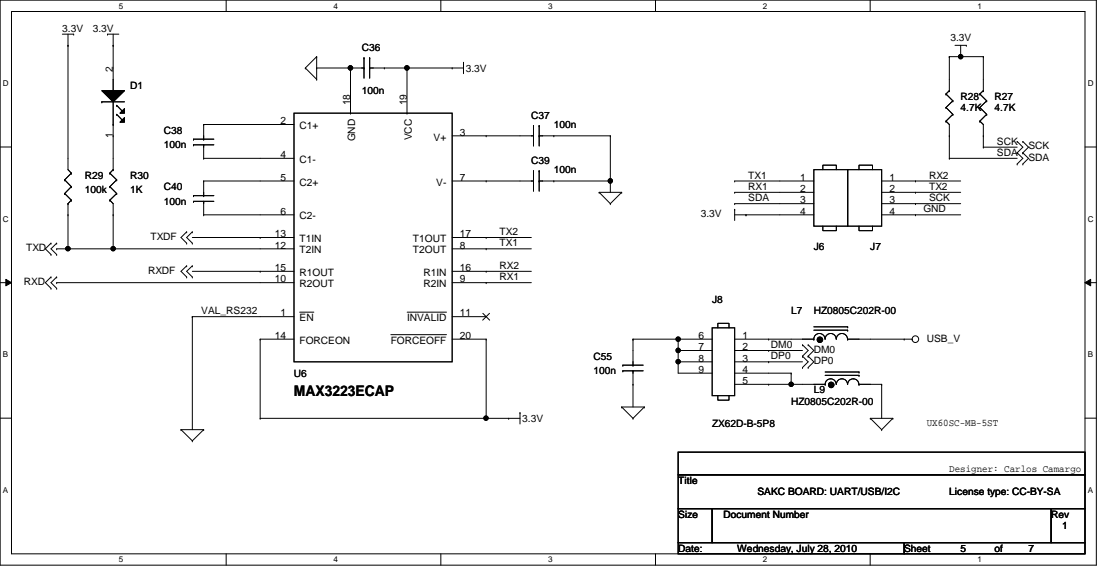
[picture p89: page 6]

Designer: Carlos Camargo
License type: CC-BY-SA

SAKC BOARD: UART/USB/I2C

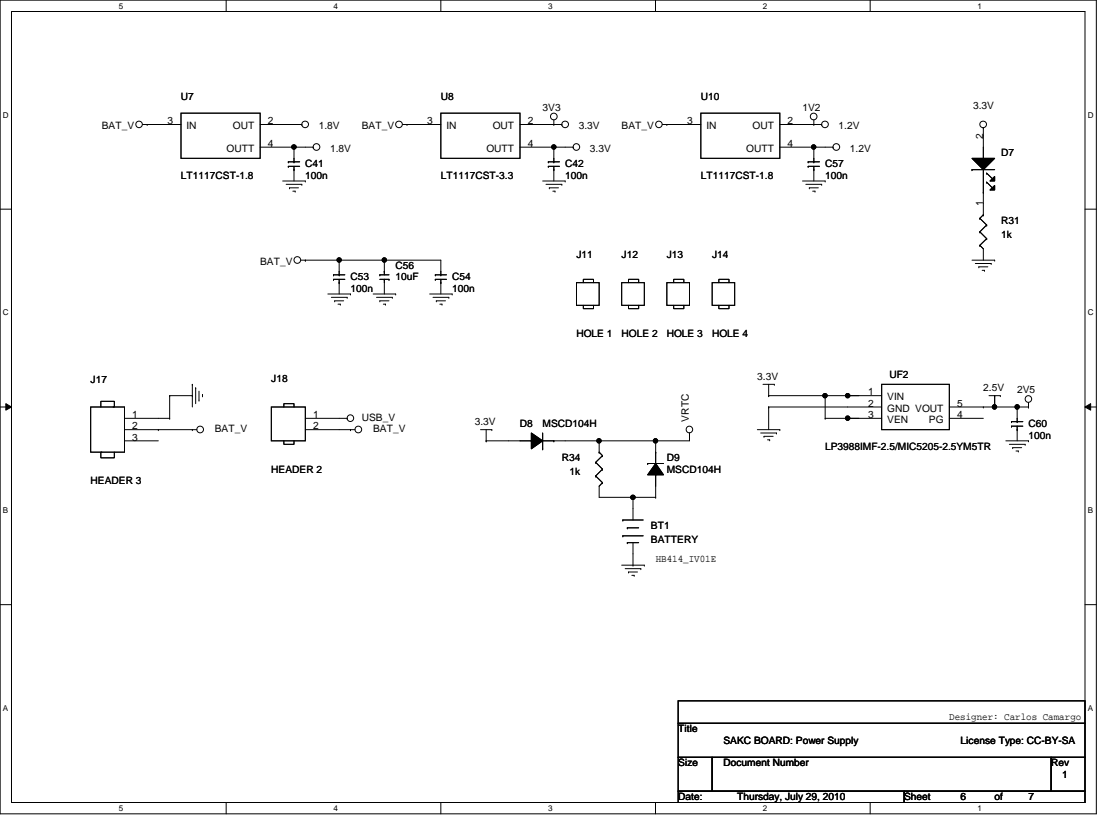
[picture p90: page 7]

Designer: Carlos Camargo
License Type: CC-BY-SA

SAKC BOARD: Power Supply

## ADIN1 L-HPO

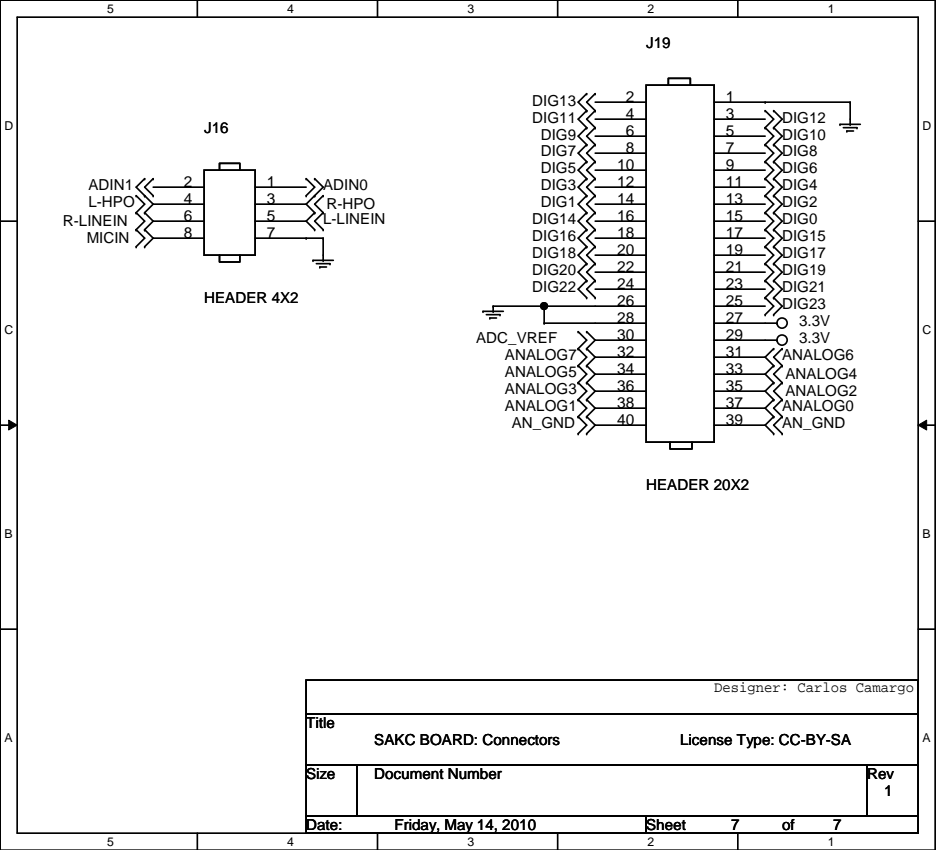
[picture p91: page 8]
R-LINEIN MICIN; L-LINEIN; R-HPO; ADIN0; DIG13; DIG11; DIG12; DIG10 DIG8 DIG6 DIG4 DIG2 DIG0; DIG9 DIG7 DIG5 DIG3 DIG1 DIG14 DIG16 DIG18 DIG20 DIG22; DIG15 DIG17 DIG19 DIG21 DIG23; AN_GND; ANALOG6 ANALOG4 ANALOG2 ANALOG0; ANALOG7 ANALOG5 ANALOG3 ANALOG1; ADC_VREF; Title; Size; Document Number; Rev; Friday, May 14, 2010; HEADER 20X2; HEADER 4X2

Designer: Carlos Camargo

SAKC BOARD: Connectors

License Type: CC-BY-SA
