IndustriasBizarras/SIE/(list of files, drawings)

Other design files:
Examples/moto_display/SCHEMATICS/AnalogINS.dsn
Examples/moto_display/SCHEMATICS/AnalogINS_prueba.dsn
Examples/PaInTES/KICAD_design_files/LCD.dsn
Examples/PS2_INTERFACE/ORCAD_desing_files/PS2.DSN
Examples/PS2_INTERFACE/ORCAD_desing_files/ps2.opj
PCB/Orcad/sie_orcad_v1.1/SIE_V3.DSN
PCB/Orcad/sie_orcad_v1.1/XBURST.OLB
PCB/Orcad/sie_orcad_v1/ECB_JZ7425.DSN
PCB/Orcad/sie_orcad_v1/ECB_JZ7425.opj
PCB/Orcad/sie_orcad_v1/XBURST.OLB
