IndustriasBizarras/SIE/Examples/PS2_INTERFACE/KICAD_design_files/ps2.sch

## KiCad design Examples/PS2_INTERFACE/KICAD_design_files/ps2.sch (2011-02-02)

Schematic: ps2.sch

Parts:
J1: HEADER_20X2
J2: HEADER_2
J3, J4: HEADER_4
JS1, JS2: MINI-DIN6PTH
R1, R2, R3, R4: 270
R5, R6, R7, R8: 10K
