IndustriasBizarras/SIE/Examples/moto_display/SCHEMATICS/AnalogINS.sch

## KiCad design Examples/moto_display/SCHEMATICS/AnalogINS.sch (2012-02-03)

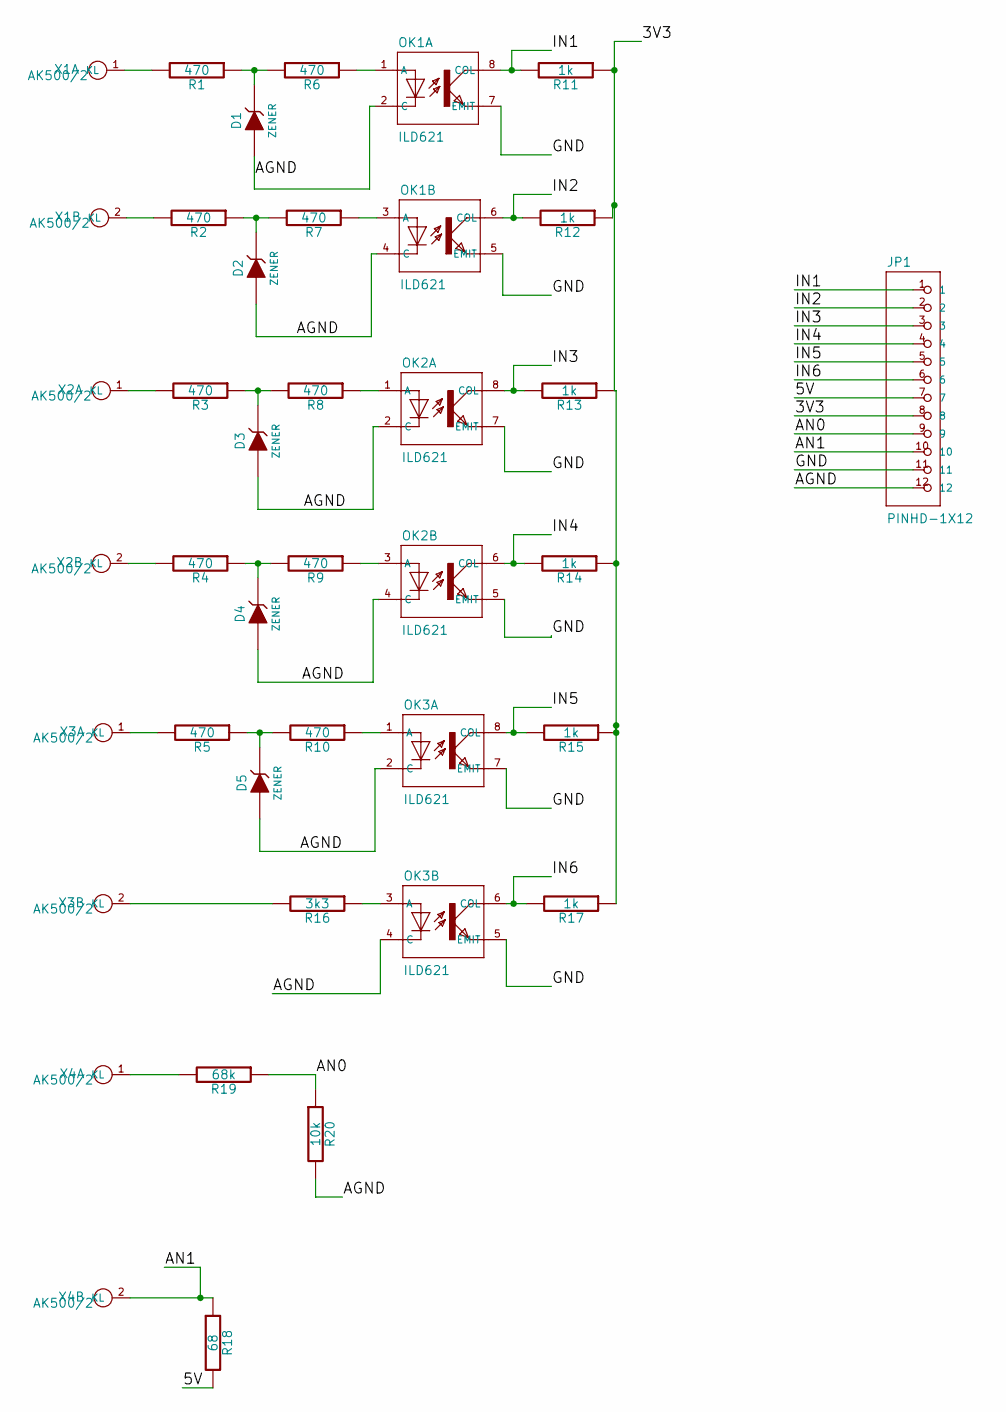
[picture p92: schematic AnalogINS.sch]

Parts:
D1, D2, D3, D4, D5: ZENER
JP1: PINHD-1X12; pinhead-1X12
OK1, OK2, OK3: ILD621; optocoupler-DIL08
R1, R2, R3, R4, R5, R6, R7, R8, R9, R10: 470
R11, R12, R13, R14, R15, R17: 1k
R16: 3k3
R18: 68
R19: 68k
R20: 10k
X1, X2, X3, X4: AK500/2; con-ptr500-AK500/2

Connections:
3V3: JP1.8, R11.1, R12.1, R13.1, R14.1, R15.1, R17.1
5V: JP1.7, R18.2
AGND: D1.1 (A), D2.1 (A), D3.1 (A), D4.1 (A), D5.1 (A), JP1.12, OK1.2 (C), OK1.4 (C), OK2.2 (C), OK2.4 (C), OK3.2 (C), OK3.4 (C), R20.2
AN0: JP1.9, R19.1, R20.1
AN1: JP1.10, R18.1, X4.2
GND: JP1.11, OK1.5 (EMIT), OK1.7 (EMIT), OK2.5 (EMIT), OK2.7 (EMIT), OK3.5 (EMIT), OK3.7 (EMIT)
IN1: JP1.1, OK1.8 (COL), R11.2
IN2: JP1.2, OK1.6 (COL), R12.2
IN3: JP1.3, OK2.8 (COL), R13.2
IN4: JP1.4, OK2.6 (COL), R14.2
IN5: JP1.5, OK3.8 (COL), R15.2
IN6: JP1.6, OK3.6 (COL), R17.2
unnamed: D1.2 (K), R1.1, R6.2
unnamed: D2.2 (K), R2.1, R7.2
unnamed: D3.2 (K), R3.1, R8.2
unnamed: D4.2 (K), R4.1, R9.2
unnamed: D5.2 (K), R5.1, R10.2
unnamed: OK1.1 (A), R6.1
unnamed: OK1.3 (A), R7.1
unnamed: OK2.1 (A), R8.1
unnamed: OK2.3 (A), R9.1
unnamed: OK3.1 (A), R10.1
unnamed: OK3.3 (A), R16.1
unnamed: R1.2, X1.1
unnamed: R2.2, X1.2
unnamed: R3.2, X2.1
unnamed: R4.2, X2.2
unnamed: R5.2, X3.1
unnamed: R16.2, X3.2
unnamed: R19.2, X4.1
