IndustriasBizarras/SIE/Examples/moto_display/SCHEMATICS/Keyboard.sch

## KiCad design Examples/moto_display/SCHEMATICS/Keyboard.sch (2012-02-03)

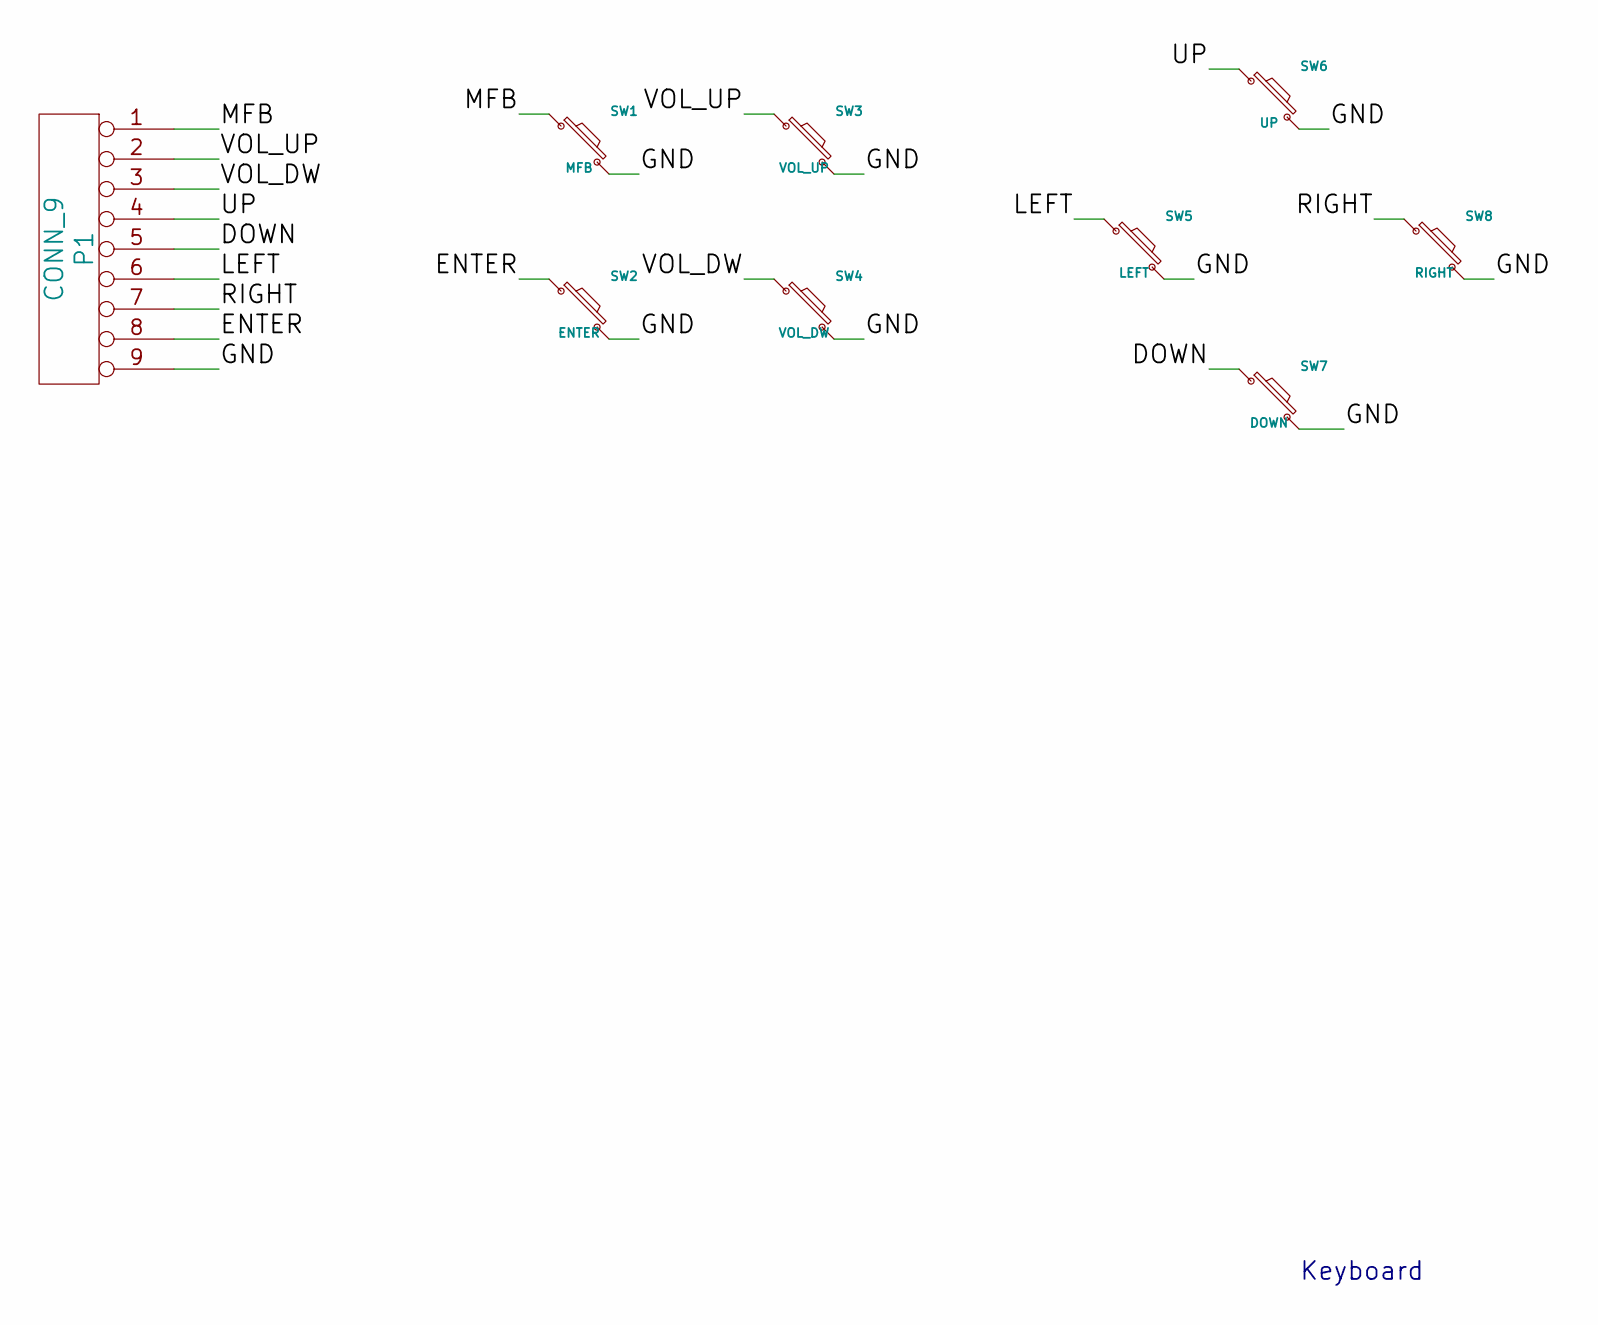
[picture p93: schematic Keyboard.sch]

Parts:
P1: CONN_9
SW1: MFB
SW2: ENTER
SW3: VOL_UP
SW4: VOL_DW
SW5: LEFT
SW6: UP
SW7: DOWN
SW8: RIGHT

Connections:
DOWN: P1.5, SW7.1
ENTER: P1.8, SW2.1
GND: P1.9, SW1.2, SW2.2, SW3.2, SW4.2, SW5.2, SW6.2, SW7.2, SW8.2
LEFT: P1.6, SW5.1
MFB: P1.1, SW1.1
RIGHT: P1.7, SW8.1
UP: P1.4, SW6.1
VOL_DW: P1.3, SW4.1
VOL_UP: P1.2, SW3.1

Notes on the sheet:
Keyboard
