IndustriasBizarras/SIE/Examples/moto_display/SCHEMATICS/SMM_2.sch

## KiCad design Examples/moto_display/SCHEMATICS/SMM_2.sch (2012-02-03)

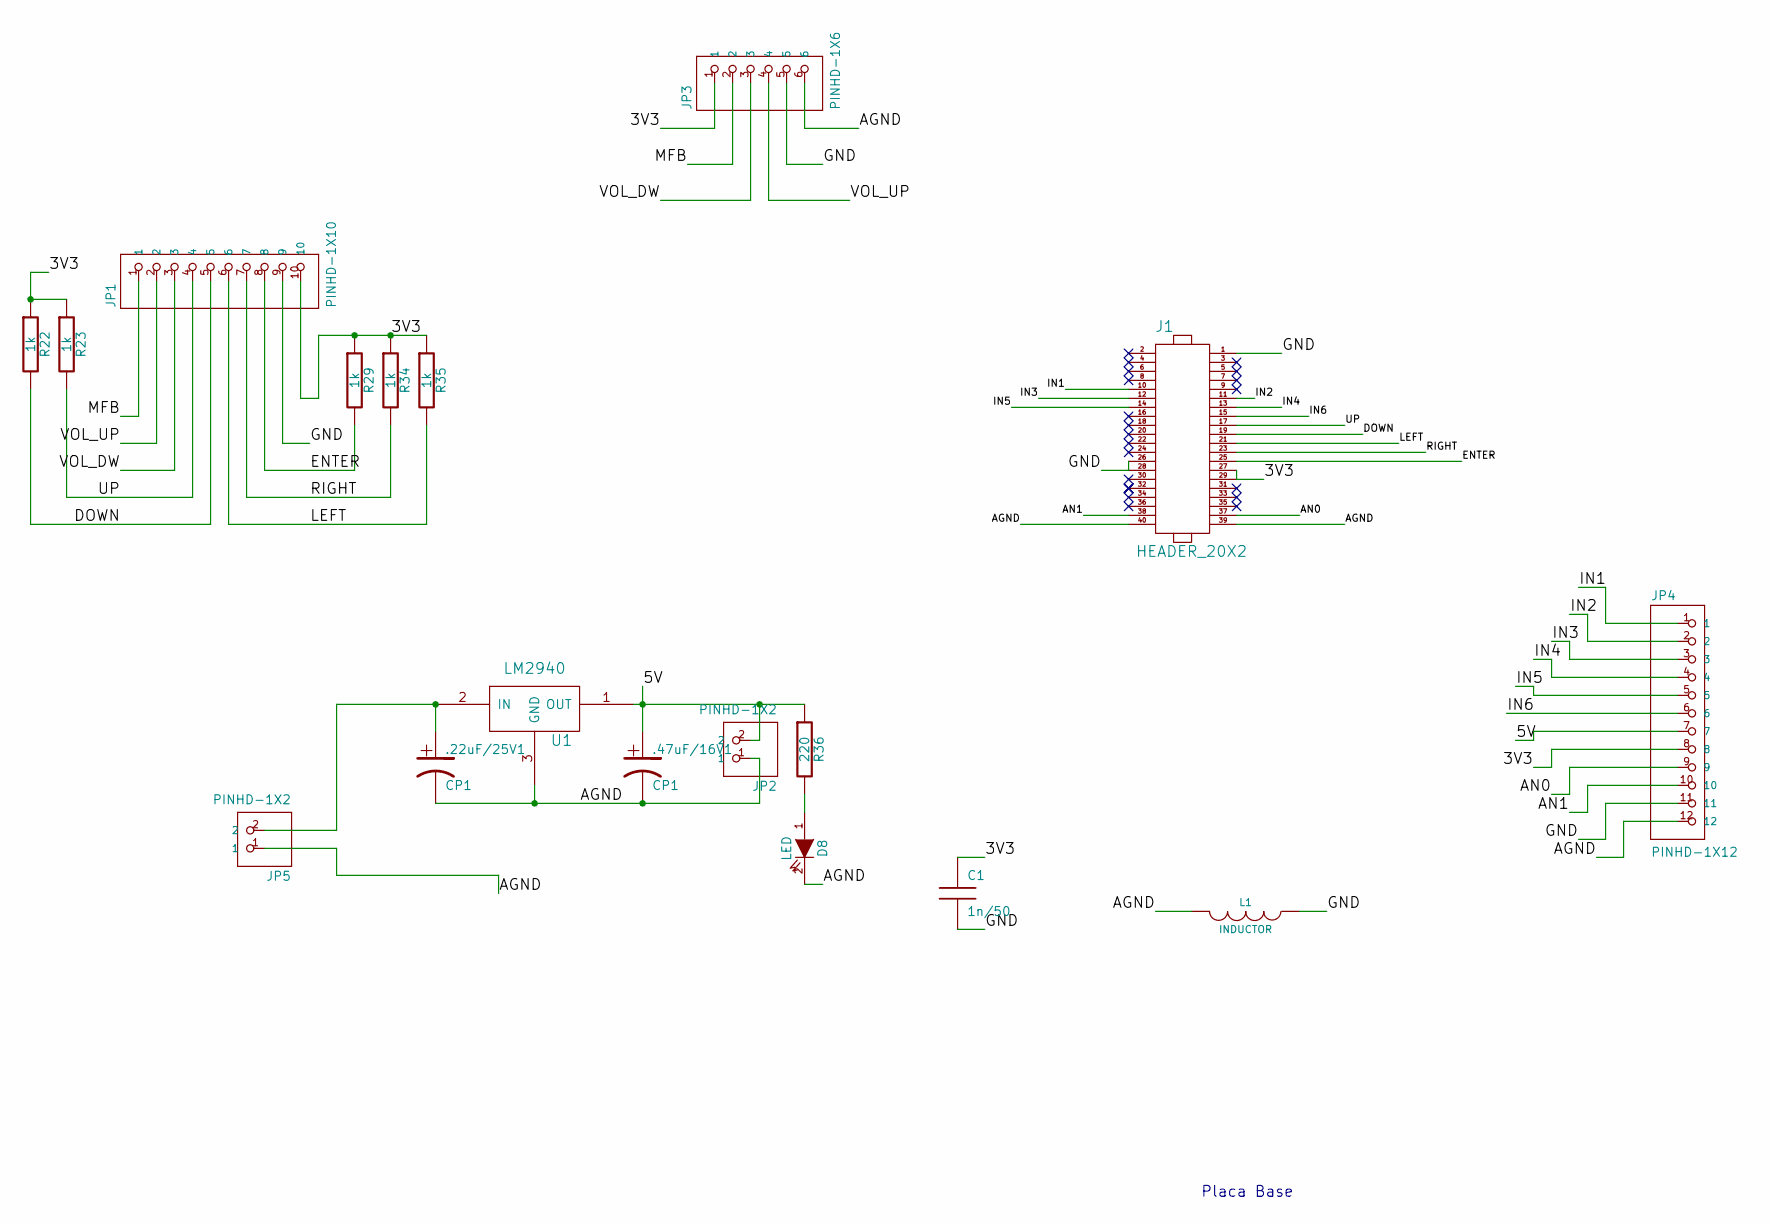
[picture p94: schematic SMM_2.sch]

Parts:
.22uF/25V1, .47uF/16V1: CP1
C1: 1n/50
D8: LED
J1: HEADER_20X2
JP1: PINHD-1X10; pinhead-1X10
JP2, JP5: PINHD-1X2; pinhead-1X02
JP3: PINHD-1X6; pinhead-1X06
JP4: PINHD-1X12; pinhead-1X12
L1: INDUCTOR
R22, R23, R29, R34, R35: 1k
R36: 220
U1: LM2940

Connections:
3V3: C1.1, J1.27, J1.29, JP1.10, JP3.1, JP4.8, R22.1, R23.1, R29.1, R34.1, R35.1
5V: .47uF/16V1.1, JP2.2, JP4.7, R36.1, U1.1 (OUT)
AGND: .22uF/25V1.2, .47uF/16V1.2, D8.2 (K), J1.39, J1.40, JP2.1, JP3.6, JP4.12, JP5.1, L1.2, U1.3 (GND)
AN0: J1.37, JP4.9
AN1: J1.38, JP4.10
DOWN: J1.19, JP1.5, R22.2
ENTER: J1.25, JP1.8, R29.2
GND: C1.2, J1.1, J1.26, J1.28, JP1.9, JP3.5, JP4.11, L1.1
IN1: J1.10, JP4.1
IN2: J1.11, JP4.2
IN3: J1.12, JP4.3
IN4: J1.13, JP4.4
IN5: J1.14, JP4.5
IN6: J1.15, JP4.6
LEFT: J1.21, JP1.6, R35.2
MFB: JP1.1, JP3.2
unnamed: .22uF/25V1.1, JP5.2, U1.2 (IN)
unnamed: D8.1 (A), R36.2
RIGHT: J1.23, JP1.7, R34.2
UP: J1.17, JP1.4, R23.2
VOL_DW: JP1.3, JP3.3
VOL_UP: JP1.2, JP3.4

Notes on the sheet:
Placa Base
