IndustriasBizarras/SIE/Examples/moto_display/SCHEMATICS/bluetooh.sch

## KiCad design Examples/moto_display/SCHEMATICS/bluetooh.sch (2012-02-03)

Schematic: bluetooh.sch

Parts:
C2, C5: 4u7
C6, C8, C9, C11: 1uF
C7, C10: 15pF
D6, D7: LED
JP1: UART
JP2: Music_in
JP3, JP4: PINHD-1X2; pinhead-1X02
L2: INDUCTOR
L3, L4: 15nH
P1: CONN_6
R21, R24, R25, R26, R37: 10k
R27, R28: 1k
R30, R31: 1.5k
R32: 7.5k
R33: 7.5K
SW1: RESET
SW2: BTB
U3: KC5290AA
U4: ANT
