IndustriasBizarras/SIE/Examples/pedal_de_efectos/PedalPCB/Pedalv2.sch

## KiCad design Examples/pedal_de_efectos/PedalPCB/Pedalv2.sch (2011-03-01)

Schematic: Pedalv2.sch

Parts:
J1: HEADER_20X2
J2: CONN16
J3, J4: JACK_2P
P1, P2, P3, P4: CONN_1
P5: CONN_6X2
R1: TRIMMERSMD
R2, R3, R4, R5, R9, R10, R11, R12, R13, R14, R15, R16, R17, R18, R19: R
SW1, SW2, SW3, SW4: SW_PUSH
SW5: SWITCH_INV
USBIN1: Conn USB
USBSIE1: Conn USB
