IndustriasBizarras/SIE/Examples/pedal_de_efectos/PedalPCB/board2.sch

## KiCad design Examples/pedal_de_efectos/PedalPCB/board2.sch (2011-03-01)

Schematic: board2.sch

Parts:
C1: C
J1, J2: JACK_2P
P1: CONN_6X2
R1, R2, R3: R
RV1: POT
