IndustriasBizarras/SIE/PCB/Kicad/sie_kicad_mini/CONNECTORS.sch

## KiCad design PCB/Kicad/sie_kicad_mini/CONNECTORS.sch (2011-08-01)

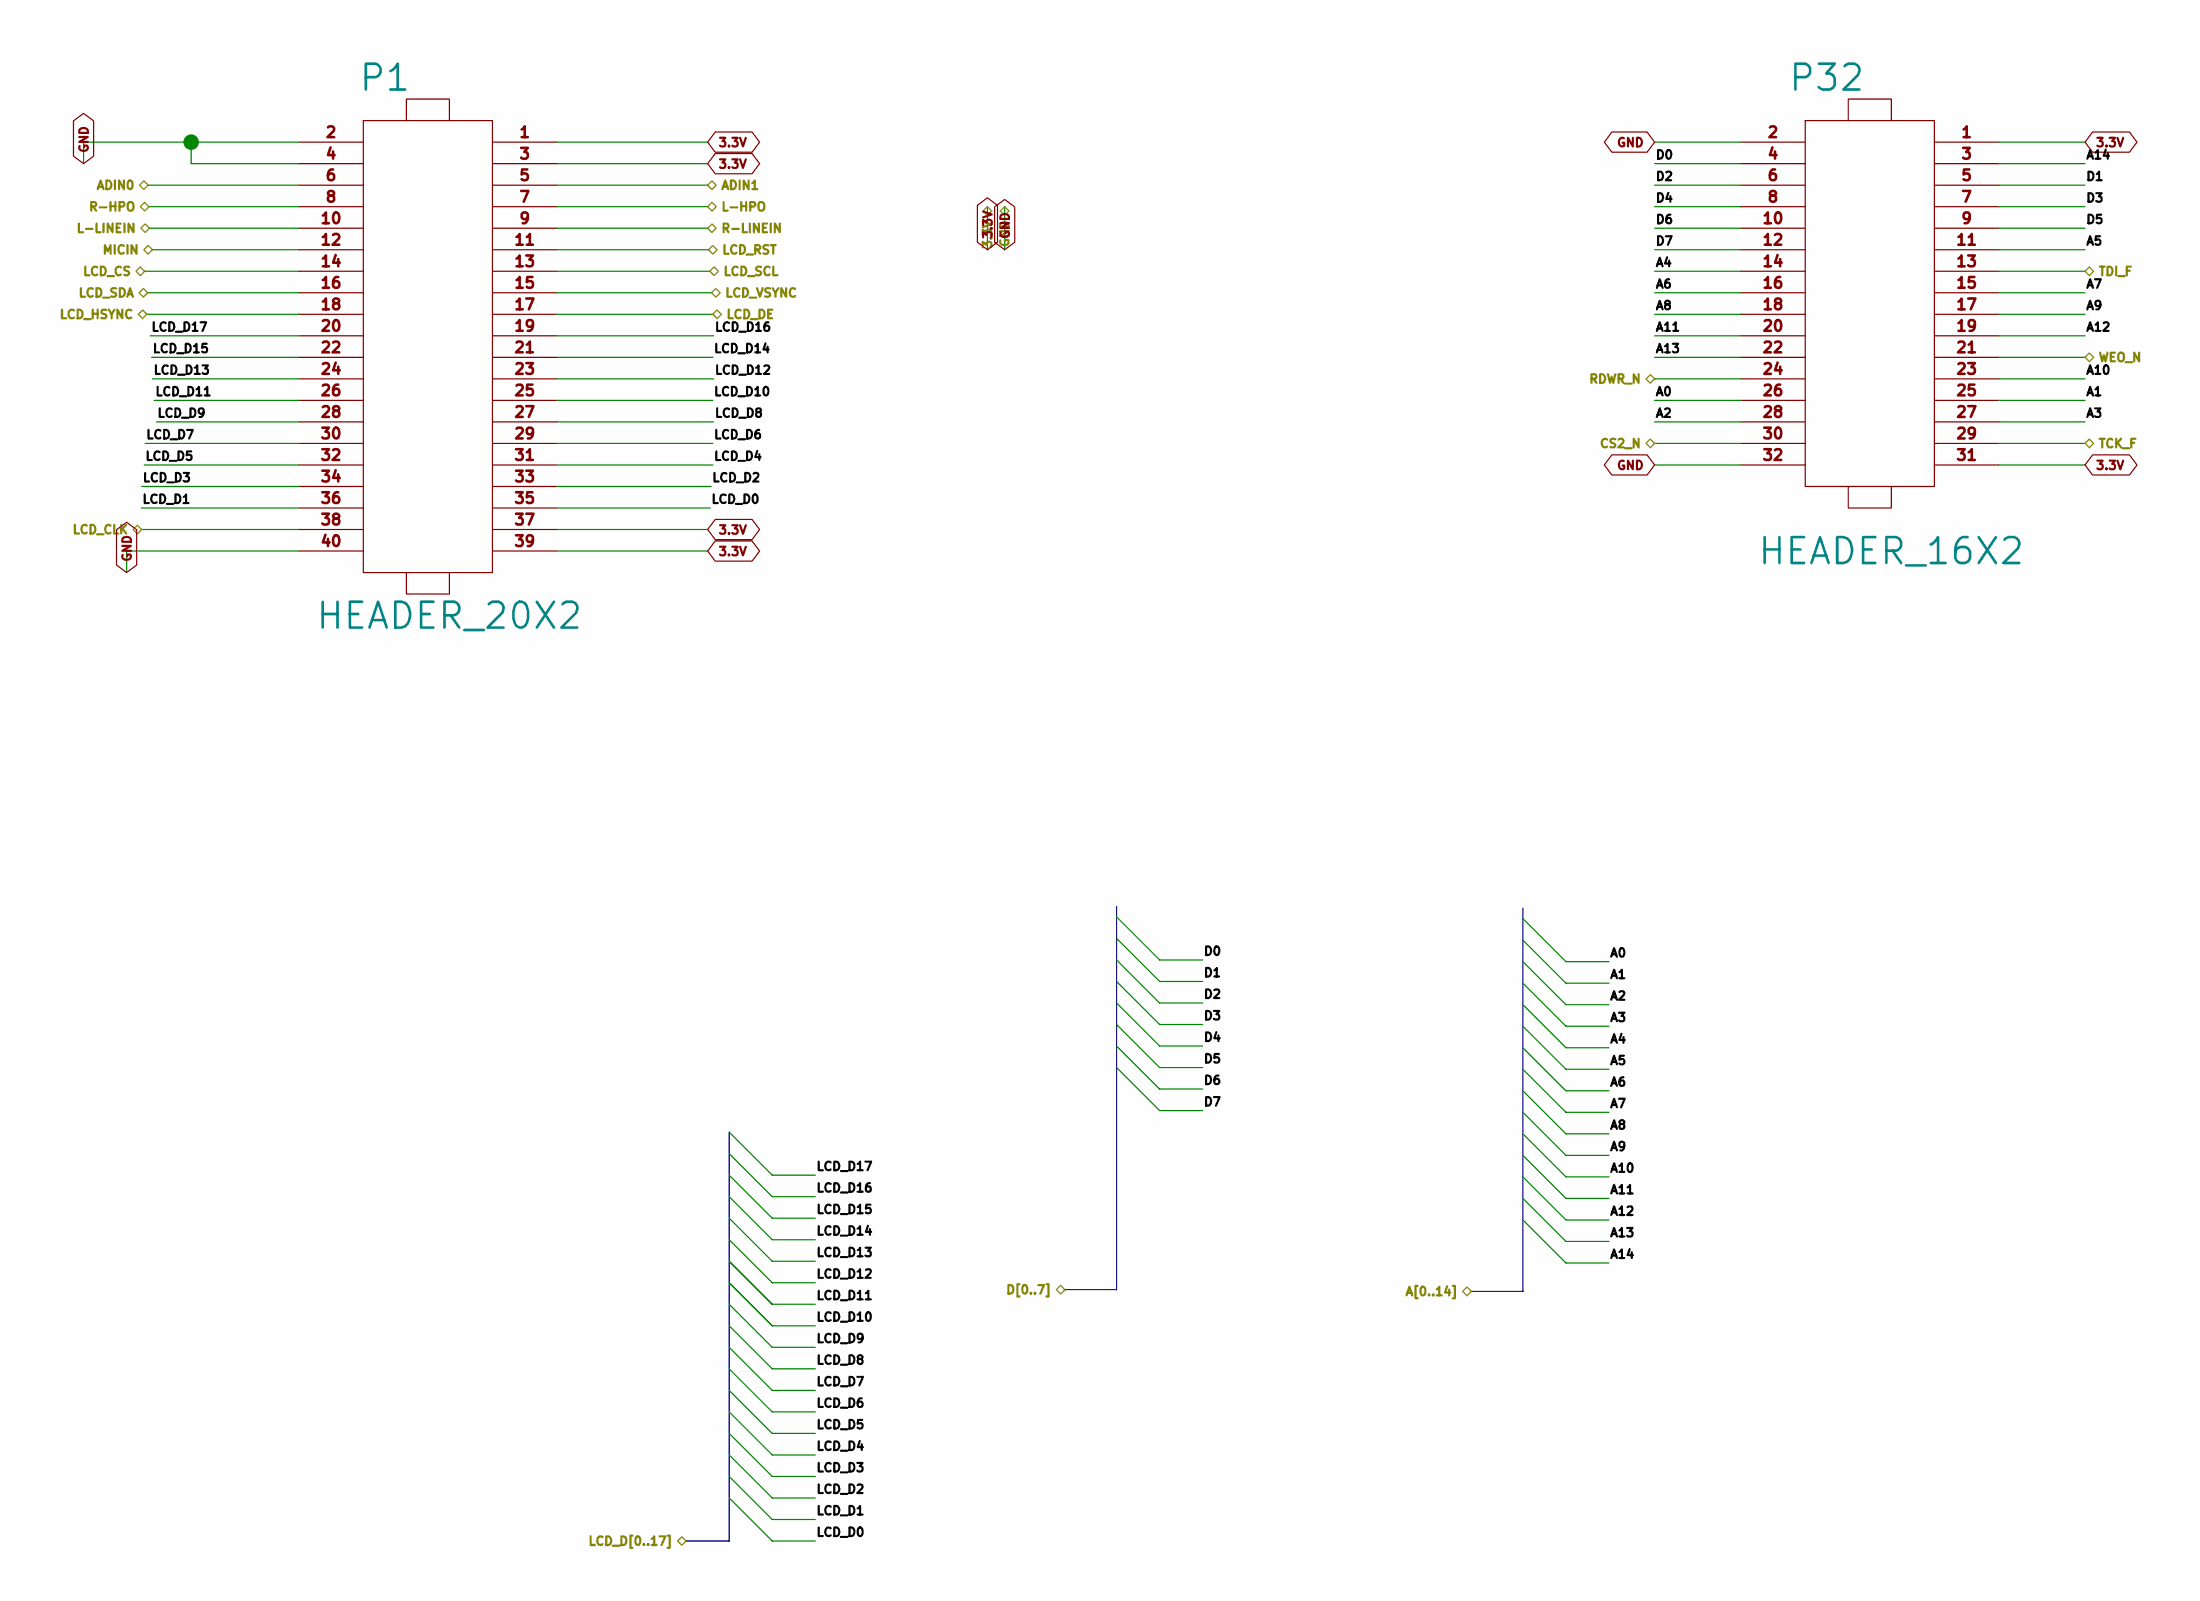
[picture p95: schematic CONNECTORS.sch]

Parts:
P1: HEADER_20X2
P32: HEADER_16X2

Connections:
3.3V: P1.1, P1.3, P1.37, P1.39, P32.1, P32.31
A0: P32.26
A1: P32.25
A2: P32.28
A3: P32.27
A4: P32.14
A5: P32.11
A6: P32.16
A7: P32.15
A8: P32.18
A9: P32.17
A10: P32.23
A11: P32.20
A12: P32.19
A13: P32.22
A14: P32.3
ADIN0: P1.6
ADIN1: P1.5
CS2_N: P32.30
D0: P32.4
D1: P32.5
D2: P32.6
D3: P32.7
D4: P32.8
D5: P32.9
D6: P32.10
D7: P32.12
GND: P1.2, P1.4, P1.40, P32.2, P32.32
L-HPO: P1.7
L-LINEIN: P1.10
LCD_CLK: P1.38
LCD_CS: P1.14
LCD_D0: P1.35
LCD_D1: P1.36
LCD_D2: P1.33
LCD_D3: P1.34
LCD_D4: P1.31
LCD_D5: P1.32
LCD_D6: P1.29
LCD_D7: P1.30
LCD_D8: P1.27
LCD_D9: P1.28
LCD_D10: P1.25
LCD_D11: P1.26
LCD_D12: P1.23
LCD_D13: P1.24
LCD_D14: P1.21
LCD_D15: P1.22
LCD_D16: P1.19
LCD_D17: P1.20
LCD_DE: P1.17
LCD_HSYNC: P1.18
LCD_RST: P1.11
LCD_SCL: P1.13
LCD_SDA: P1.16
LCD_VSYNC: P1.15
MICIN: P1.12
R-HPO: P1.8
R-LINEIN: P1.9
RDWR_N: P32.24
TCK_F: P32.29
TDI_F: P32.13
WEO_N: P32.21
