IndustriasBizarras/SIE/PCB/Kicad/sie_kicad_mini/CPU.sch

## KiCad design PCB/Kicad/sie_kicad_mini/CPU.sch (2011-08-01)

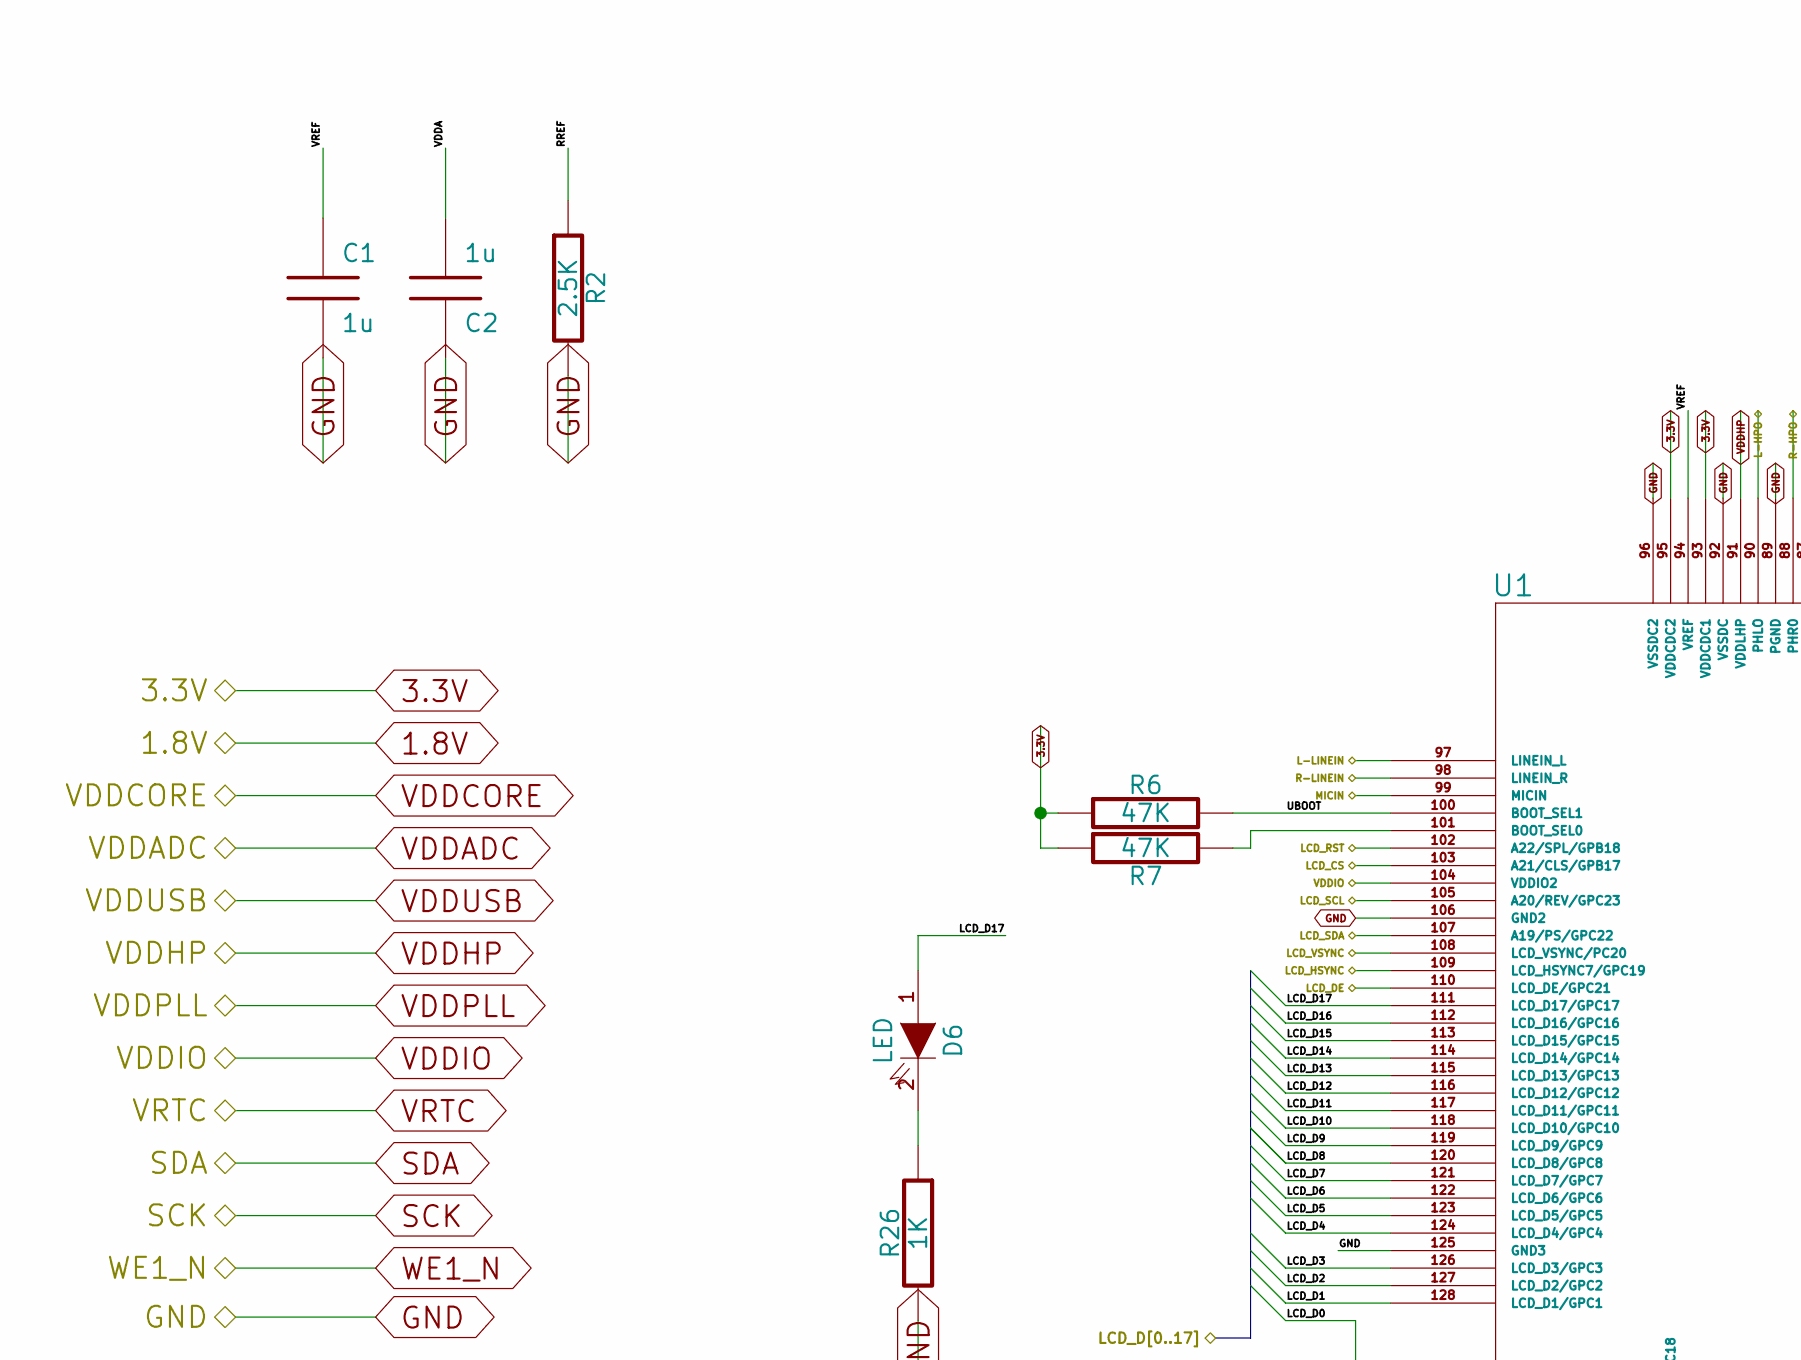
[picture p96: schematic CPU.sch, part in row 1, column 1]

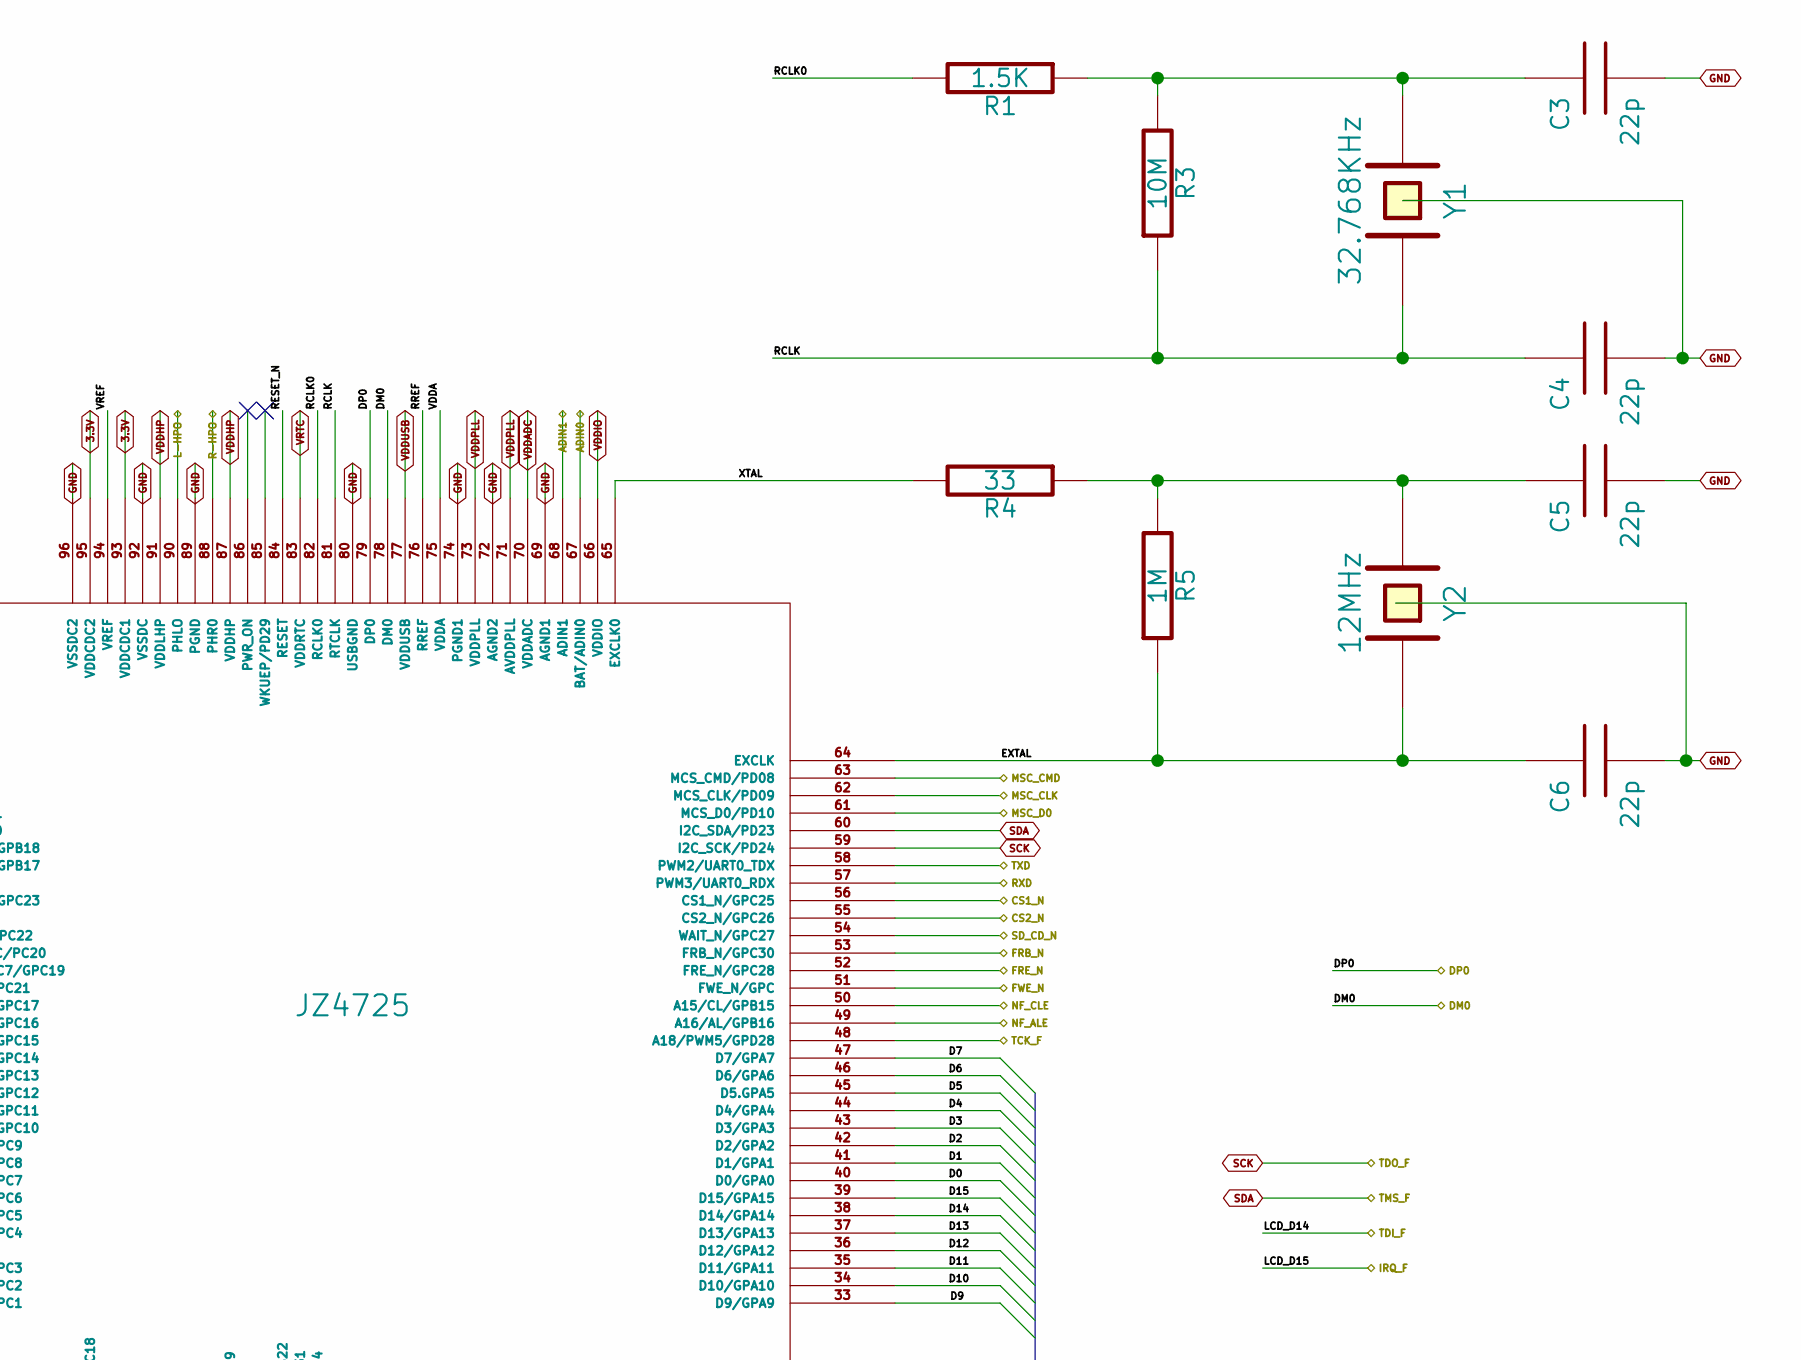
[picture p97: schematic CPU.sch, part in row 1, column 2]

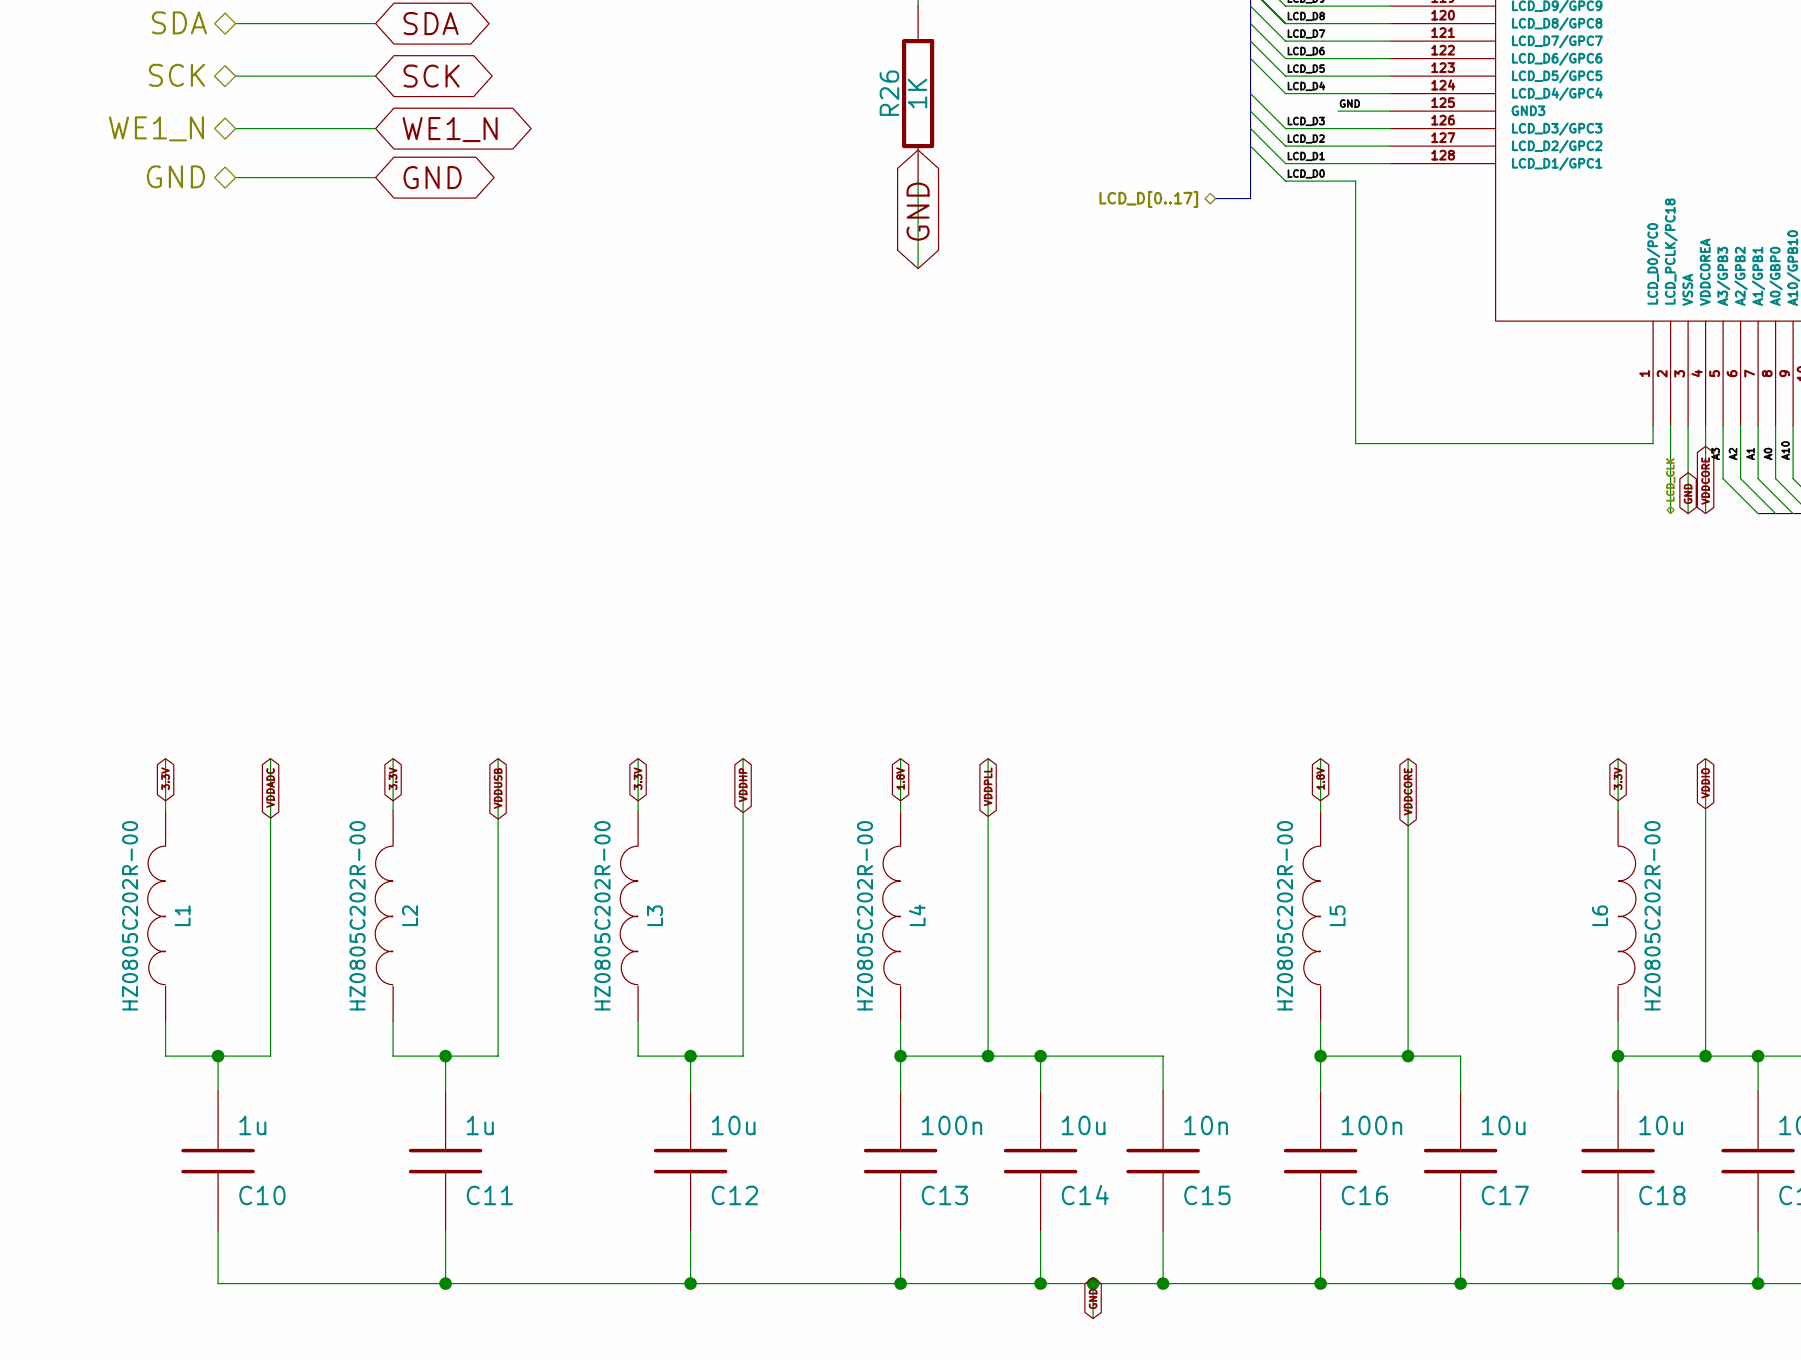
[picture p98: schematic CPU.sch, part in row 2, column 1]

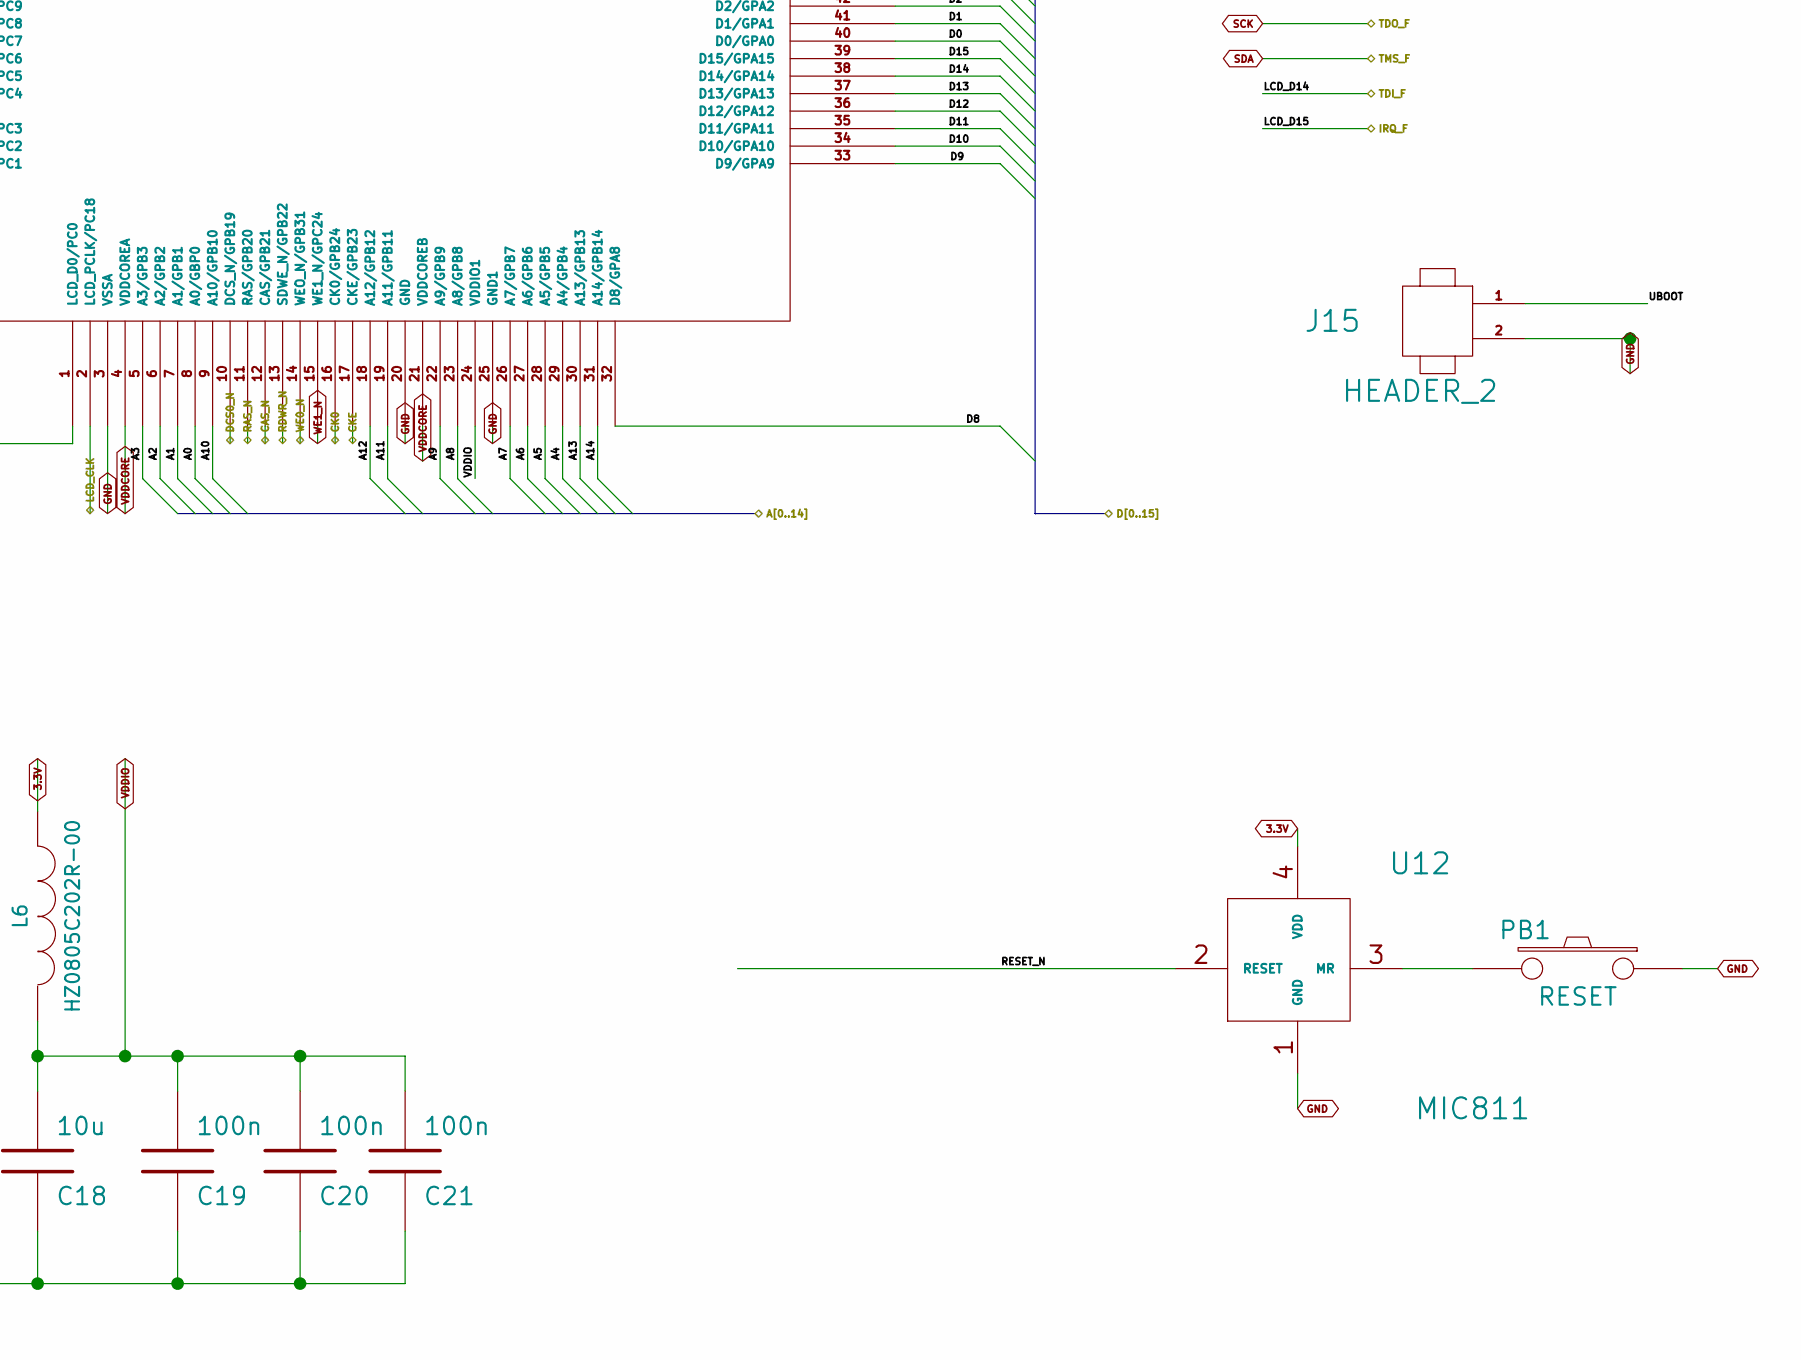
[picture p99: schematic CPU.sch, part in row 2, column 2]

Parts:
C1, C2, C10, C11: 1u
C3, C4, C5, C6: 22p
C12, C14, C17, C18: 10u
C13, C16, C19, C20, C21: 100n
C15: 10n
D6: LED
J15: HEADER_2
L1, L2, L3, L4, L5, L6: HZ0805C202R-00
PB1: RESET
R1: 1.5K
R2: 2.5K; R_MINI
R3: 10M
R4: 33
R5: 1M
R6, R7: 47K
R26: 1K
U1: JZ4725
U12: MIC811
Y1: 32.768KHz
Y2: 12MHz

Connections:
1.8V: L4.2, L5.2
3.3V: L1.2, L2.2, L3.2, L6.2, R6.1, R7.1, U1.93 (VDDCDC1), U1.95 (VDDCDC2), U12.4 (VDD)
A0: U1.8 (A0/GBP0)
A1: U1.7 (A1/GPB1)
A2: U1.6 (A2/GPB2)
A3: U1.5 (A3/GPB3)
A4: U1.29 (A4/GPB4)
A5: U1.28 (A5/GPB5)
A6: U1.27 (A6/GPB6)
A7: U1.26 (A7/GPB7)
A8: U1.23 (A8/GPB8)
A9: U1.22 (A9/GPB9)
A10: U1.9 (A10/GPB10)
A11: U1.19 (A11/GPB11)
A12: U1.18 (A12/GPB12)
A13: U1.30 (A13/GPB13)
A14: U1.31 (A14/GPB14)
ADIN0: U1.67 (BAT/ADIN0)
ADIN1: U1.68 (ADIN1)
CAS_N: U1.12 (CAS/GPB21)
CK0: U1.16 (CK0/GPB24)
CKE: U1.17 (CKE/GPB23)
CS1_N: U1.56 (CS1_N/GPC25)
CS2_N: U1.55 (CS2_N/GPC26)
D0: U1.40 (D0/GPA0)
D1: U1.41 (D1/GPA1)
D2: U1.42 (D2/GPA2)
D3: U1.43 (D3/GPA3)
D4: U1.44 (D4/GPA4)
D5: U1.45 (D5.GPA5)
D6: U1.46 (D6/GPA6)
D7: U1.47 (D7/GPA7)
D8: U1.32 (D8/GPA8)
D9: U1.33 (D9/GPA9)
D10: U1.34 (D10/GPA10)
D11: U1.35 (D11/GPA11)
D12: U1.36 (D12/GPA12)
D13: U1.37 (D13/GPA13)
D14: U1.38 (D14/GPA14)
D15: U1.39 (D15/GPA15)
DCS0_N: U1.10 (DCS_N/GPB19)
DM0: U1.78 (DM0)
DP0: U1.79 (DP0)
EXTAL: C6.1, R5.1, U1.64 (EXCLK), Y2.1
FRB_N: U1.53 (FRB_N/GPC30)
FRE_N: U1.52 (FRE_N/GPC28)
FWE_N: U1.51 (FWE_N/GPC)
GND: C1.2, C2.1, C3.2, C4.2, C5.2, C6.2, C10.1, C11.1, C12.1, C13.1, C14.1, C15.1, C16.1, C17.1, C18.1, C19.1, C20.1, C21.1, J15.2, PB1.1, R2.2, R26.2, U1.3 (VSSA), U1.20 (GND), U1.25 (GND1), U1.69 (AGND1), U1.72 (AGND2), U1.74 (PGND1), U1.80 (USBGND), U1.89 (PGND), U1.92 (VSSDC), U1.96 (VSSDC2), U1.106 (GND2), U1.125 (GND3), U12.1 (GND)
IRQ_F: U1.113 (LCD_D15/GPC15)
L-HPO: U1.90 (PHLO)
L-LINEIN: U1.97 (LINEIN_L)
LCD_CLK: U1.2 (LCD_PCLK/PC18)
LCD_CS: U1.103 (A21/CLS/GPB17)
LCD_D0: U1.1 (LCD_D0/PC0)
LCD_D1: U1.128 (LCD_D1/GPC1)
LCD_D2: U1.127 (LCD_D2/GPC2)
LCD_D3: U1.126 (LCD_D3/GPC3)
LCD_D4: U1.124 (LCD_D4/GPC4)
LCD_D5: U1.123 (LCD_D5/GPC5)
LCD_D6: U1.122 (LCD_D6/GPC6)
LCD_D7: U1.121 (LCD_D7/GPC7)
LCD_D8: U1.120 (LCD_D8/GPC8)
LCD_D9: U1.119 (LCD_D9/GPC9)
LCD_D10: U1.118 (LCD_D10/GPC10)
LCD_D11: U1.117 (LCD_D11/GPC11)
LCD_D12: U1.116 (LCD_D12/GPC12)
LCD_D13: U1.115 (LCD_D13/GPC13)
LCD_D14: U1.114 (LCD_D14/GPC14)
LCD_D16: U1.112 (LCD_D16/GPC16)
LCD_D17: D6.1 (A), U1.111 (LCD_D17/GPC17)
LCD_DE: U1.110 (LCD_DE/GPC21)
LCD_HSYNC: U1.109 (LCD_HSYNC7/GPC19)
LCD_RST: U1.102 (A22/SPL/GPB18)
LCD_SCL: U1.105 (A20/REV/GPC23)
LCD_SDA: U1.107 (A19/PS/GPC22)
LCD_VSYNC: U1.108 (LCD_VSYNC/PC20)
MICIN: U1.99 (MICIN)
MSC_CLK: U1.62 (MCS_CLK/PD09)
MSC_CMD: U1.63 (MCS_CMD/PD08)
MSC_D0: U1.61 (MCS_D0/PD10)
NF_ALE: U1.49 (A16/AL/GPB16)
NF_CLE: U1.50 (A15/CL/GPB15)
unnamed: C3.1, R1.1, R3.2, Y1.2
unnamed: C5.1, R4.1, R5.2, Y2.2
unnamed: D6.2 (K), R26.1
unnamed: PB1.2, U12.3 (MR)
unnamed: R7.2, U1.101 (BOOT_SEL0)
R-HPO: U1.88 (PHR0)
R-LINEIN: U1.98 (LINEIN_R)
RAS_N: U1.11 (RAS/GPB20)
RCLK: C4.1, R3.1, U1.81 (RTCLK), Y1.1
RCLK0: R1.2, U1.82 (RCLK0)
RDWR_N: U1.13 (SDWE_N/GPB22)
RESET_N: U1.84 (RESET), U12.2 (RESET)
RREF: R2.1, U1.76 (RREF)
RXD: U1.57 (PWM3/UART0_RDX)
SCK: U1.59 (I2C_SCK/PD24)
SDA: U1.60 (I2C_SDA/PD23)
SD_CD_N: U1.54 (WAIT_N/GPC27)
TCK_F: U1.48 (A18/PWM5/GPD28)
TXD: U1.58 (PWM2/UART0_TDX)
UBOOT: J15.1, R6.2, U1.100 (BOOT_SEL1)
VDDA: C2.2, U1.75 (VDDA)
VDDADC: C10.2, L1.1, U1.70 (VDDADC)
VDDCORE: C16.2, C17.2, L5.1, U1.4 (VDDCOREA), U1.21 (VDDCOREB)
VDDHP: C12.2, L3.1, U1.87 (VDDHP), U1.91 (VDDLHP)
VDDIO: C18.2, C19.2, C20.2, C21.2, L6.1, U1.24 (VDDIO1), U1.66 (VDDIO), U1.104 (VDDIO2)
VDDPLL: C13.2, C14.2, C15.2, L4.1, U1.71 (AVDDPLL), U1.73 (VDDPLL)
VDDUSB: C11.2, L2.1, U1.77 (VDDUSB)
VREF: C1.1, U1.94 (VREF)
VRTC: U1.83 (VDDRTC)
WE0_N: U1.14 (WEO_N/GPB31)
WE1_N: U1.15 (WE1_N/GPC24)
XTAL: R4.2, U1.65 (EXCLK0)
