IndustriasBizarras/SIE/PCB/Kicad/sie_kicad_mini/D_CONVERTER.sch

## KiCad design PCB/Kicad/sie_kicad_mini/D_CONVERTER.sch (2011-08-01)

Schematic: D_CONVERTER.sch

Parts:
C76: 100n
L12: HZ0805C202R-00
U5: X25X64MB
U11: MCP3008
