IndustriasBizarras/SIE/PCB/Kicad/sie_kicad_mini/FPGA.sch

## KiCad design PCB/Kicad/sie_kicad_mini/FPGA.sch (2011-08-01)

Schematic: FPGA.sch

Parts:
C33, C34, C35, C43, C44, C45, C46, C47, C48, C49, C50, C51, C52: 100n
D5: LED
PB2: I1
PB3: I2
R18, R19, R20, R21: 68
R25: 1K
R32, R33: 4.7K
U9: XC3SXXXE-VQ100
Y3: X_MHZ_OSC
