IndustriasBizarras/SIE/PCB/Kicad/sie_kicad_mini/LCD.sch

## KiCad design PCB/Kicad/sie_kicad_mini/LCD.sch (2011-08-01)

Schematic: LCD.sch

Parts:
C59, C75: 100nF
C61, C62, C63, C64: 2.2uF/16V
C65, C66, C67, C68, C69, C70, C71, C72, C73: 4.7uF/16V
C74: 10uF/16V
D10: SMD24APT
J20: HEADER_40
L10, L14: HZ0805C202R-00
L11: PZ1608D221
L13: PI0302-4R7M
Q1: TM2302N
R35: 1M
R36: 30
RN1, RN2: 33/5%
