IndustriasBizarras/SIE/PCB/Kicad/sie_kicad_mini/MEMORY.sch

## KiCad design PCB/Kicad/sie_kicad_mini/MEMORY.sch (2011-08-01)

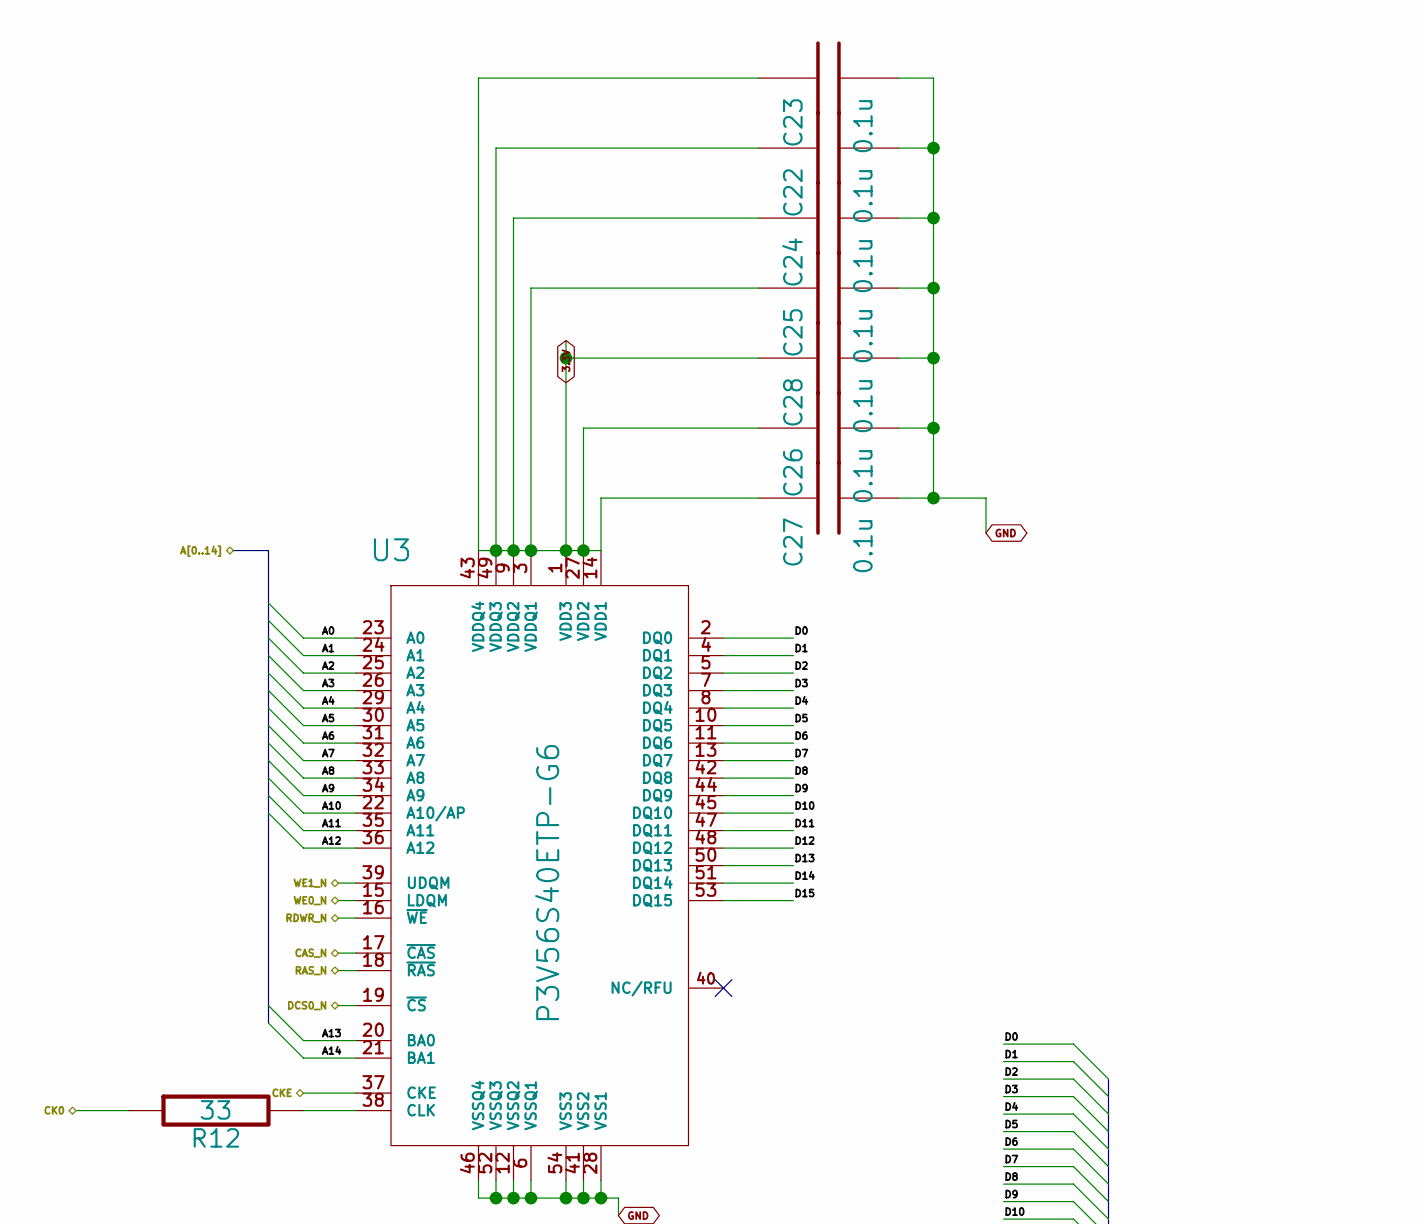
[picture p100: schematic MEMORY.sch, part in row 1, column 1]

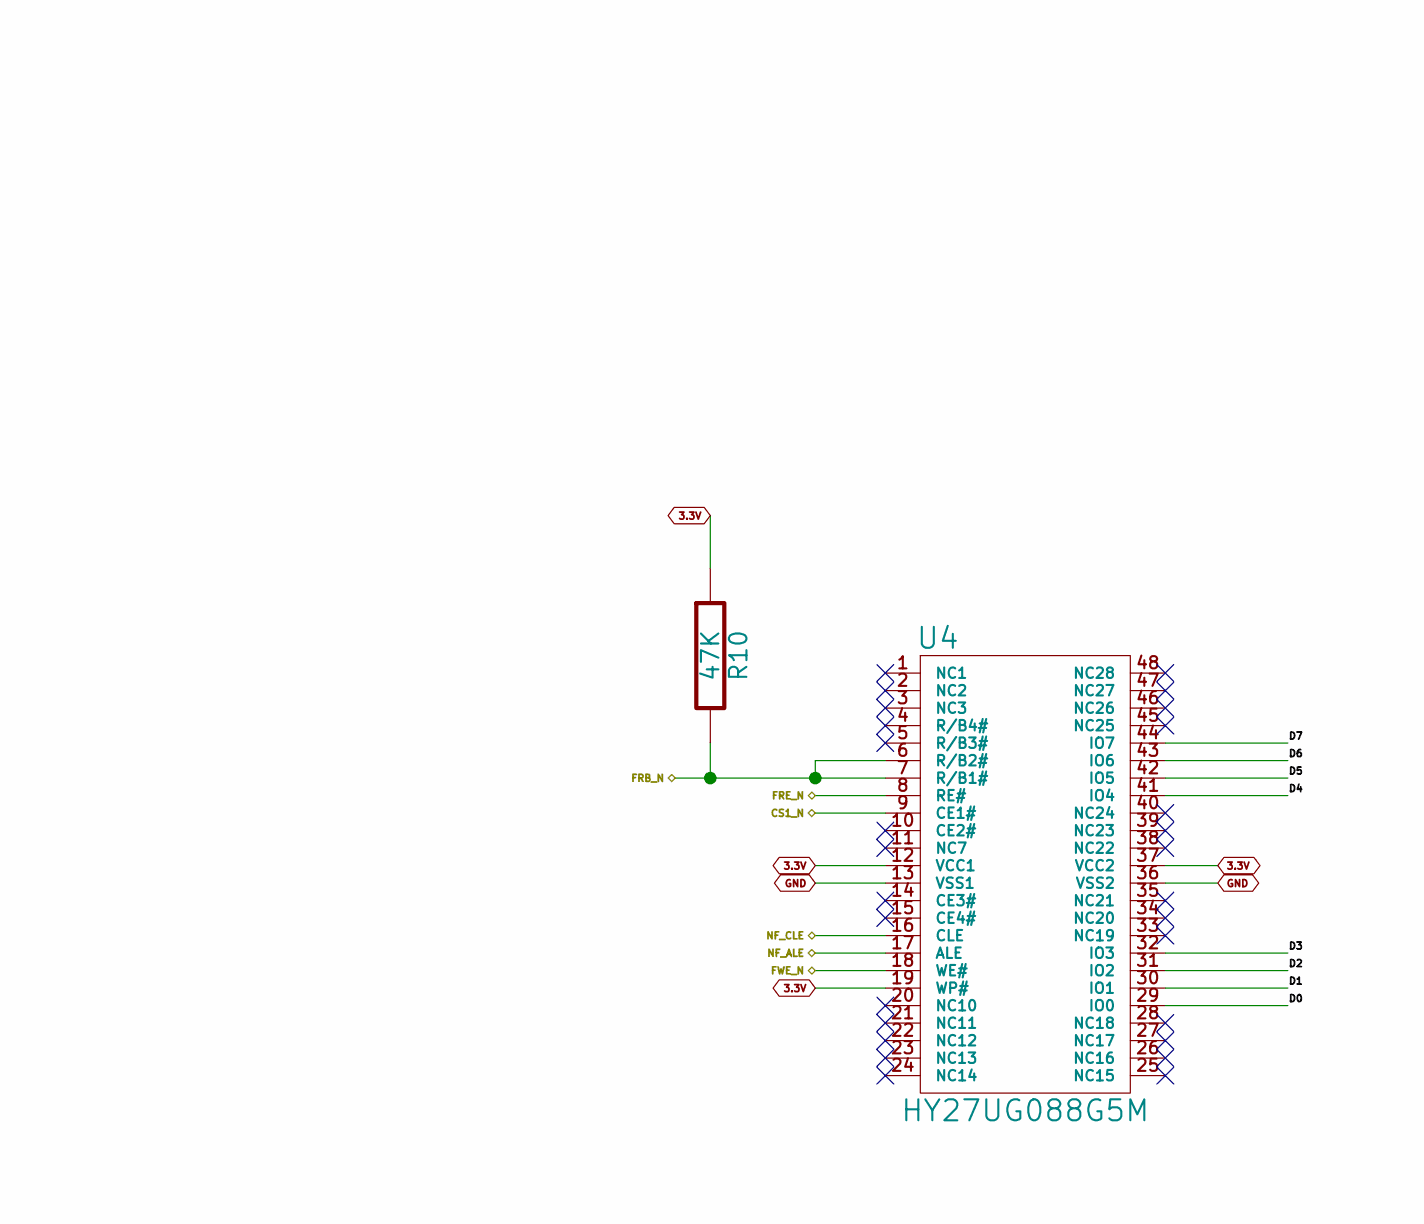
[picture p101: schematic MEMORY.sch, part in row 1, column 2]

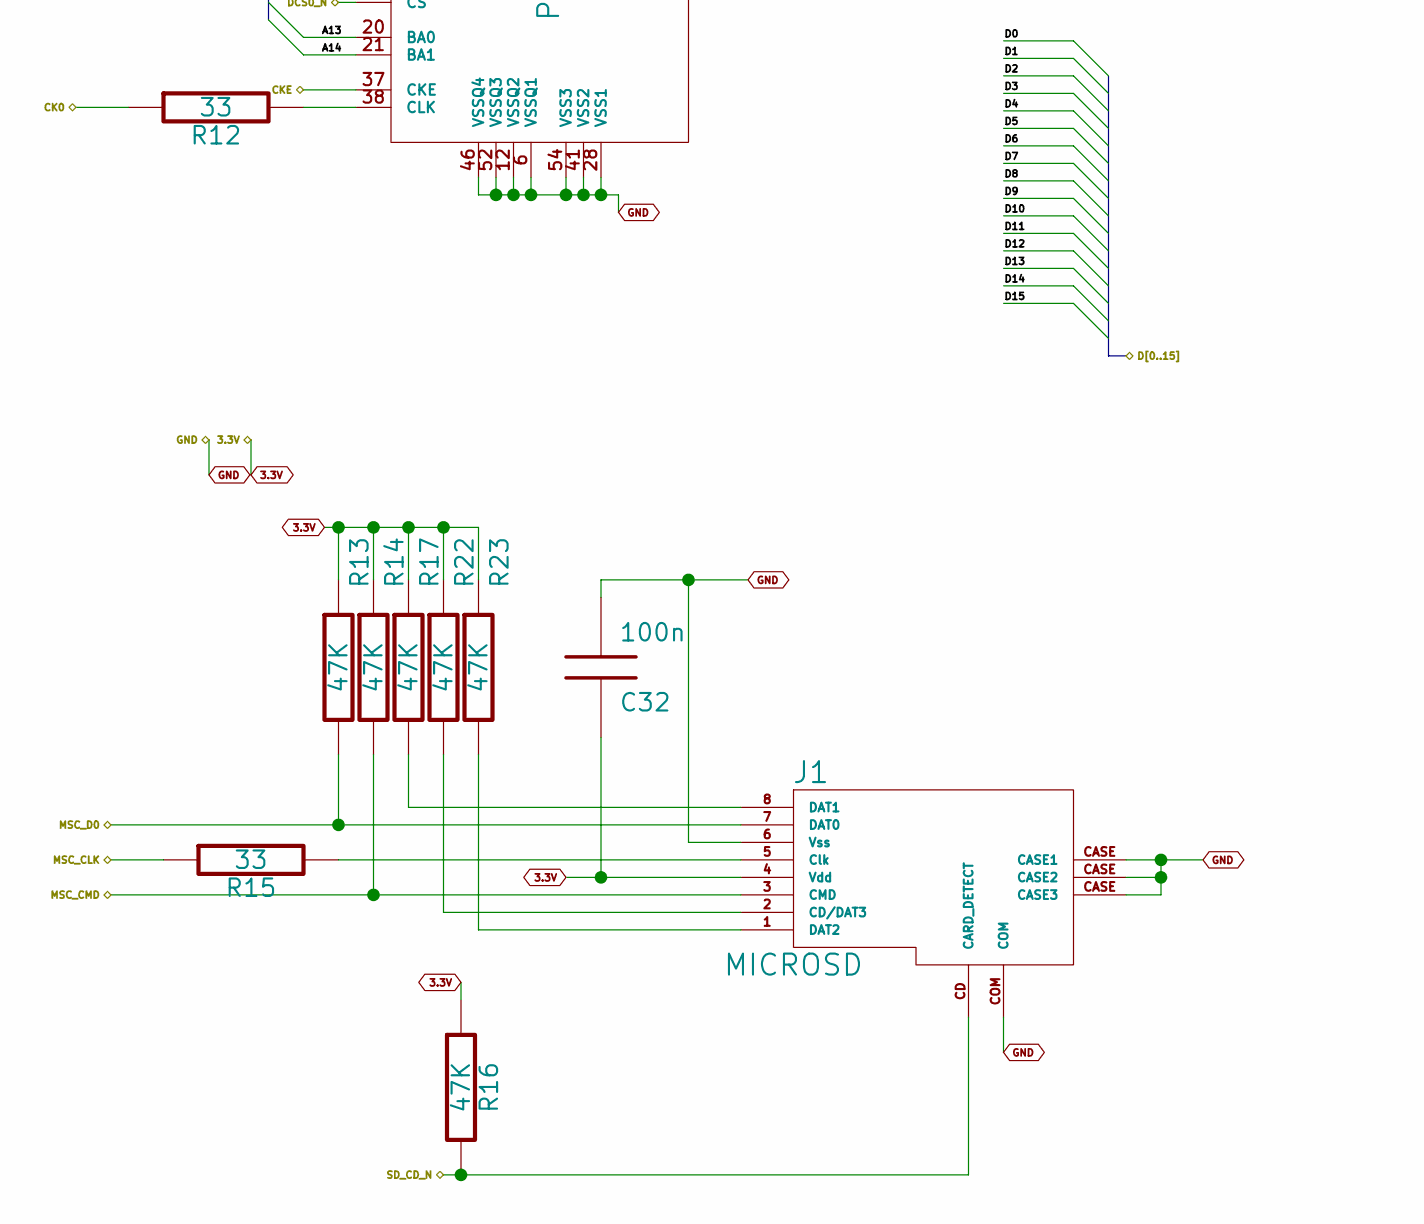
[picture p102: schematic MEMORY.sch, part in row 2, column 1]

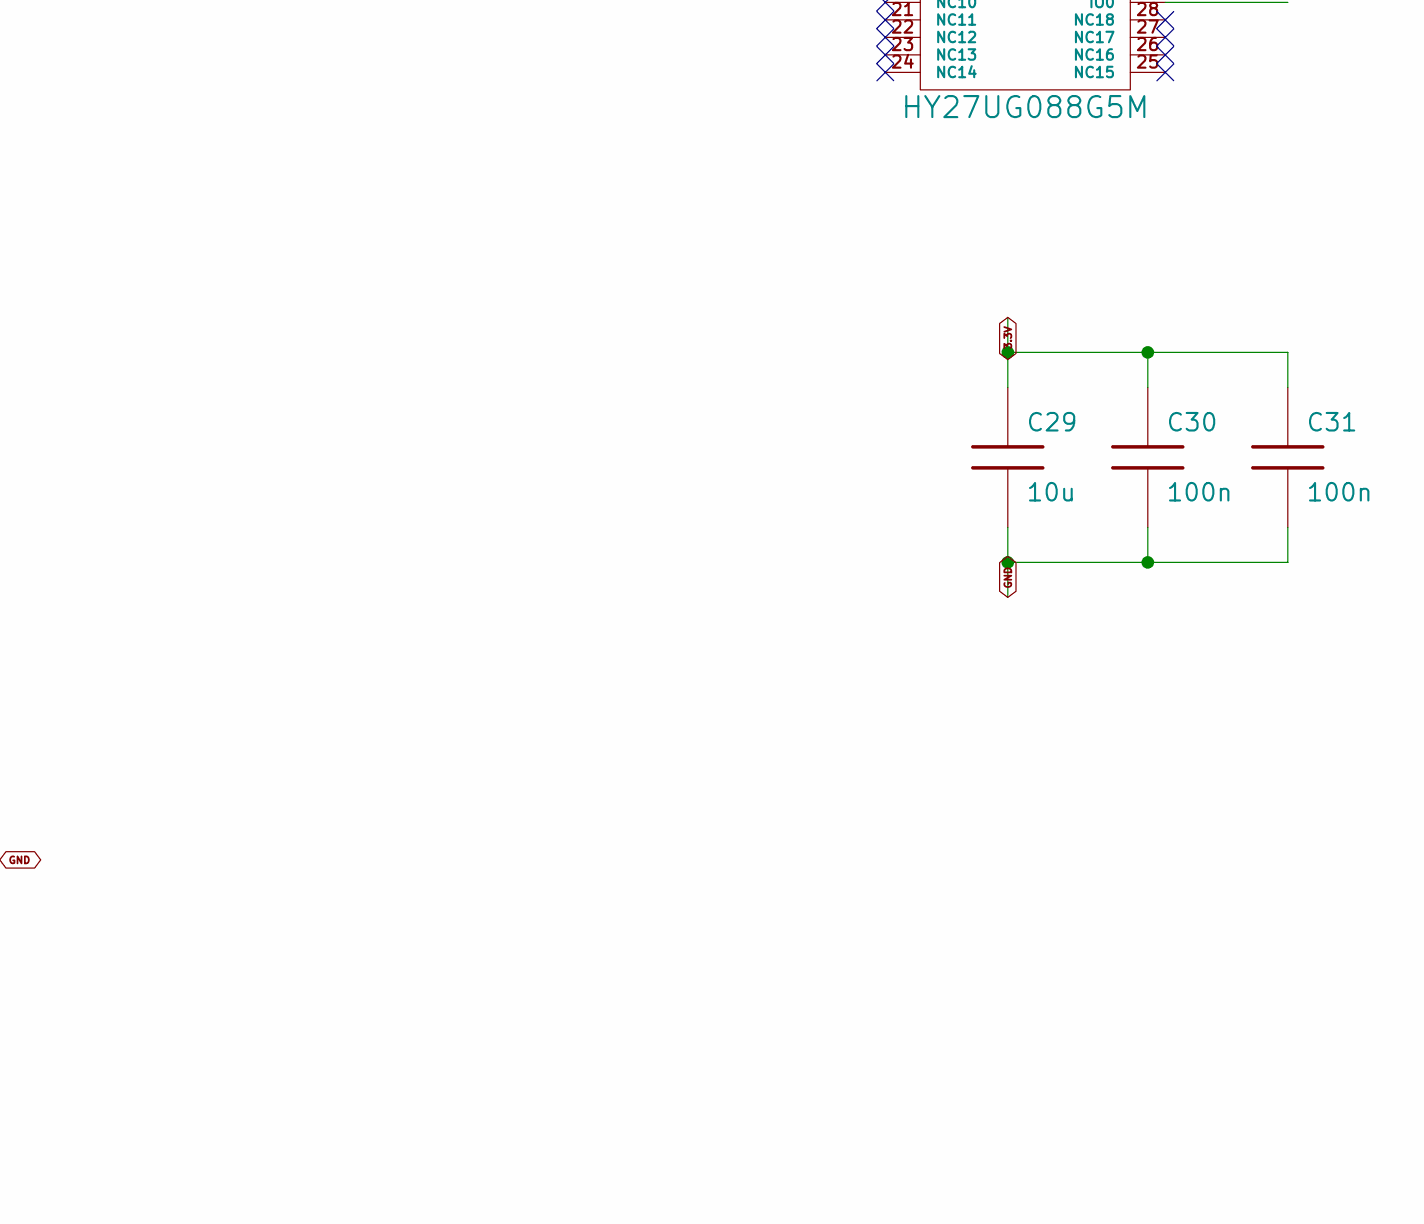
[picture p103: schematic MEMORY.sch, part in row 2, column 2]

Parts:
C22, C23, C24, C25, C26, C27, C28: 0.1u
C29: 10u
C30, C31, C32: 100n
J1: MICROSD
R10, R13, R14, R16, R17, R22, R23: 47K
R12, R15: 33
U3: P3V56S40ETP-G6
U4: HY27UG088G5M

Connections:
3.3V: C22.1, C23.1, C24.1, C25.1, C26.1, C27.1, C28.1, C29.1, C30.1, C31.1, C32.1, J1.4 (Vdd), R10.1, R13.1, R14.1, R16.1, R17.1, R22.1, R23.1, U3.1 (VDD3), U3.3 (VDDQ1), U3.9 (VDDQ2), U3.14 (VDD1), U3.27 (VDD2), U3.43 (VDDQ4), U3.49 (VDDQ3), U4.12 (VCC1), U4.19 (WP#), U4.37 (VCC2)
A0: U3.23 (A0)
A1: U3.24 (A1)
A2: U3.25 (A2)
A3: U3.26 (A3)
A4: U3.29 (A4)
A5: U3.30 (A5)
A6: U3.31 (A6)
A7: U3.32 (A7)
A8: U3.33 (A8)
A9: U3.34 (A9)
A10: U3.22 (A10/AP)
A11: U3.35 (A11)
A12: U3.36 (A12)
A13: U3.20 (BA0)
A14: U3.21 (BA1)
CAS_N: U3.17 (~CAS)
CK0: R12.1
CKE: U3.37 (CKE)
CS1_N: U4.9 (CE1#)
D0: U3.2 (DQ0), U4.29 (IO0)
D1: U3.4 (DQ1), U4.30 (IO1)
D2: U3.5 (DQ2), U4.31 (IO2)
D3: U3.7 (DQ3), U4.32 (IO3)
D4: U3.8 (DQ4), U4.41 (IO4)
D5: U3.10 (DQ5), U4.42 (IO5)
D6: U3.11 (DQ6), U4.43 (IO6)
D7: U3.13 (DQ7), U4.44 (IO7)
D8: U3.42 (DQ8)
D9: U3.44 (DQ9)
D10: U3.45 (DQ10)
D11: U3.47 (DQ11)
D12: U3.48 (DQ12)
D13: U3.50 (DQ13)
D14: U3.51 (DQ14)
D15: U3.53 (DQ15)
DCS0_N: U3.19 (~CS)
FRB_N: R10.2, U4.6 (R/B2#), U4.7 (R/B1#)
FRE_N: U4.8 (RE#)
FWE_N: U4.18 (WE#)
GND: C22.2, C23.2, C24.2, C25.2, C26.2, C27.2, C28.2, C29.2, C30.2, C31.2, C32.2, J1.6 (Vss), J1.CASE (CASE1), J1.COM, U3.6 (VSSQ1), U3.12 (VSSQ2), U3.28 (VSS1), U3.41 (VSS2), U3.46 (VSSQ4), U3.52 (VSSQ3), U3.54 (VSS3), U4.13 (VSS1), U4.36 (VSS2)
MSC_CLK: R15.1
MSC_CMD: J1.3 (CMD), R14.2
MSC_D0: J1.7 (DAT0), R13.2
NF_ALE: U4.17 (ALE)
NF_CLE: U4.16 (CLE)
unnamed: J1.1 (DAT2), R23.2
unnamed: J1.2 (CD/DAT3), R22.2
unnamed: J1.5 (Clk), R15.2
unnamed: J1.8 (DAT1), R17.2
unnamed: R12.2, U3.38 (CLK)
RAS_N: U3.18 (~RAS)
RDWR_N: U3.16 (~WE)
SD_CD_N: J1.CD (CARD_DETECT), R16.2
WE0_N: U3.15 (LDQM)
WE1_N: U3.39 (UDQM)
