IndustriasBizarras/SIE/PCB/Kicad/sie_kicad_mini/UART_USB_I2C.sch

## KiCad design PCB/Kicad/sie_kicad_mini/UART_USB_I2C.sch (2011-08-01)

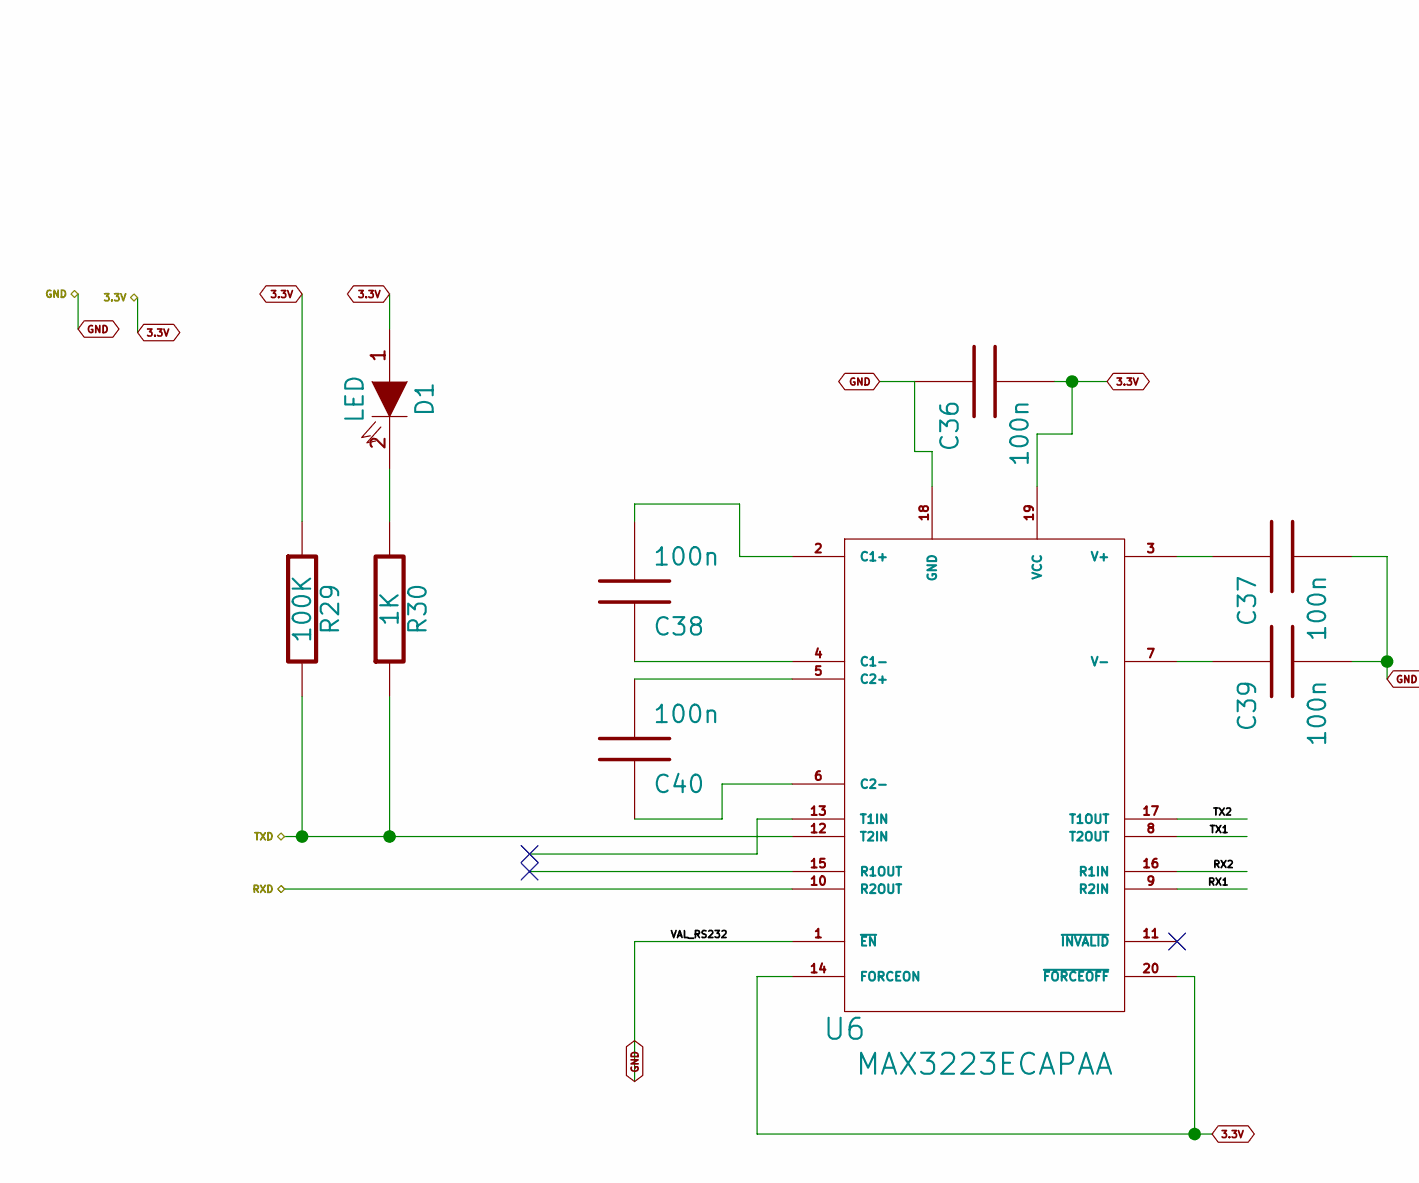
[picture p106: schematic UART_USB_I2C.sch, part in row 1, column 1]

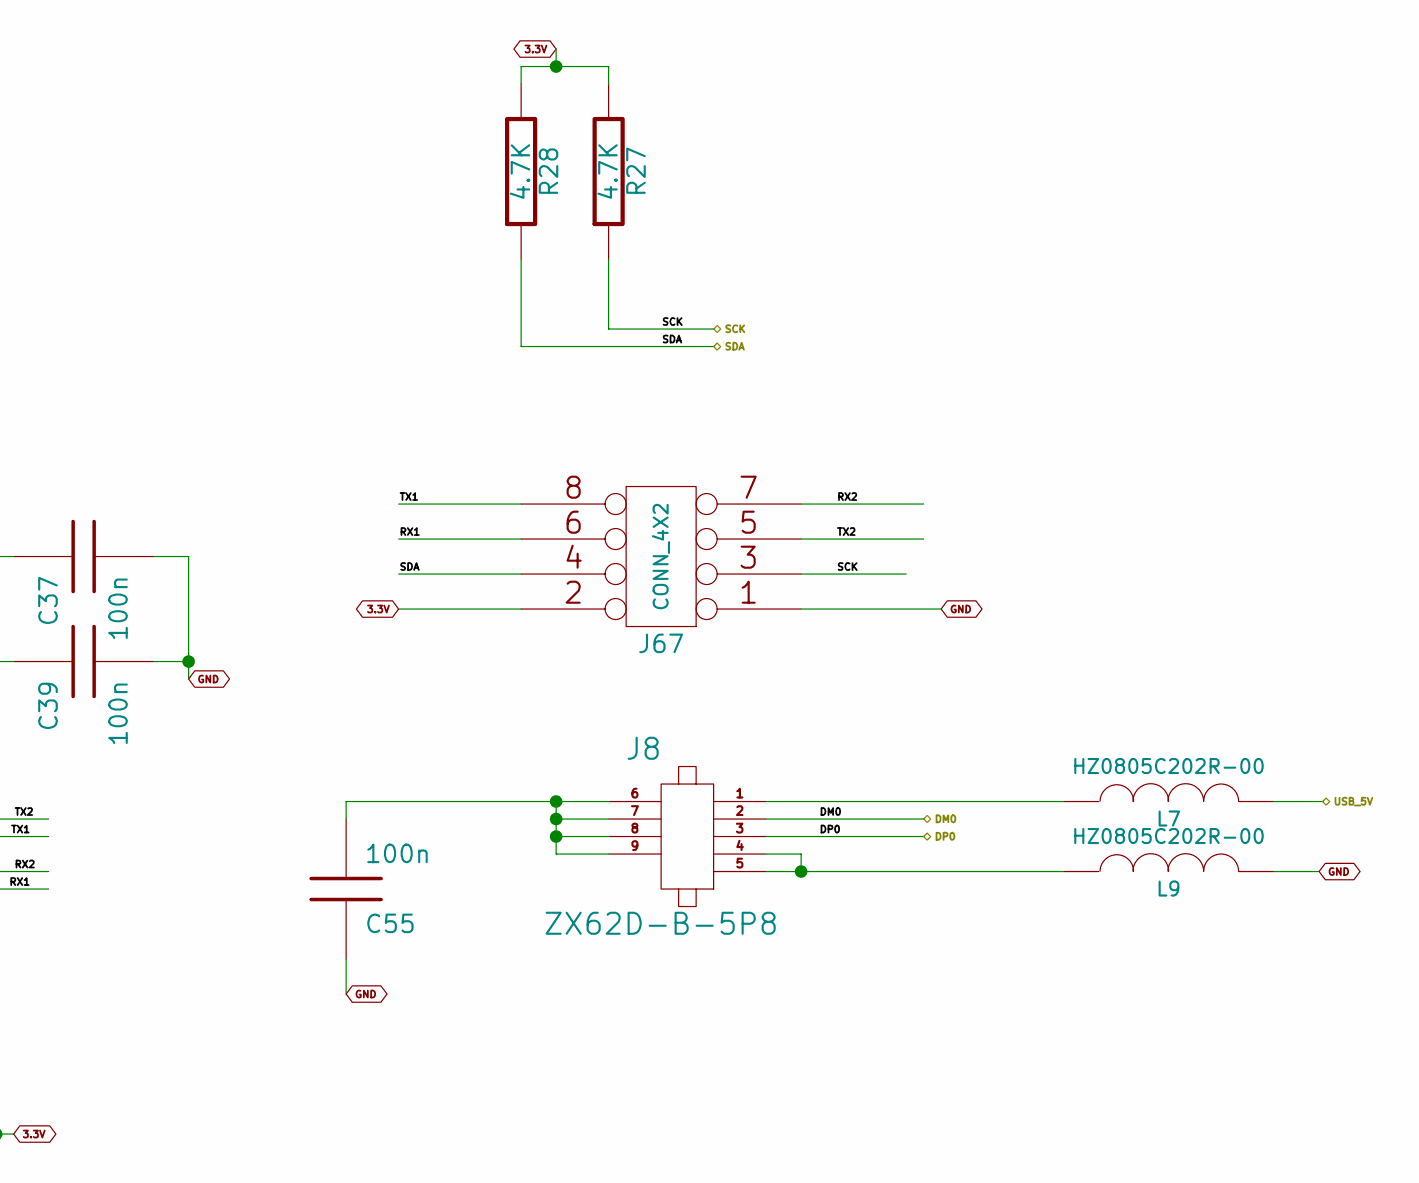
[picture p107: schematic UART_USB_I2C.sch, part in row 1, column 2]

Parts:
C36, C37, C38, C39, C40, C55: 100n
D1: LED
J8: ZX62D-B-5P8
J67: CONN_4X2
L7, L9: HZ0805C202R-00
R27, R28: 4.7K
R29: 100K
R30: 1K
U6: MAX3223ECAPAA

Connections:
3.3V: C36.2, D1.1 (A), J67.2, R27.2, R28.2, R29.1, U6.14 (FORCEON), U6.19 (VCC), U6.20 (~FORCEOFF)
DM0: J8.2
DP0: J8.3
GND: C36.1, C37.2, C39.2, C55.1, J67.1, L9.2, U6.1 (~EN), U6.18 (GND)
unnamed: C37.1, U6.3 (V+)
unnamed: C38.1, U6.4 (C1-)
unnamed: C38.2, U6.2 (C1+)
unnamed: C39.1, U6.7 (V-)
unnamed: C40.1, U6.6 (C2-)
unnamed: C40.2, U6.5 (C2+)
unnamed: C55.2, J8.6, J8.7, J8.8, J8.9
unnamed: D1.2 (K), R30.2
unnamed: J8.1, L7.1
unnamed: J8.4, J8.5, L9.1
RX1: J67.6, U6.9 (R2IN)
RX2: J67.7, U6.16 (R1IN)
RXD: U6.10 (R2OUT)
SCK: J67.3, R27.1
SDA: J67.4, R28.1
TX1: J67.8, U6.8 (T2OUT)
TX2: J67.5, U6.17 (T1OUT)
TXD: R29.2, R30.1, U6.12 (T2IN)
USB_5V: L7.2
