IndustriasBizarras/SIE/PCB/Kicad/sie_kicad_v2/CONNECTORS.sch

## KiCad design PCB/Kicad/sie_kicad_v2/CONNECTORS.sch (2012-03-29, an earlier design)

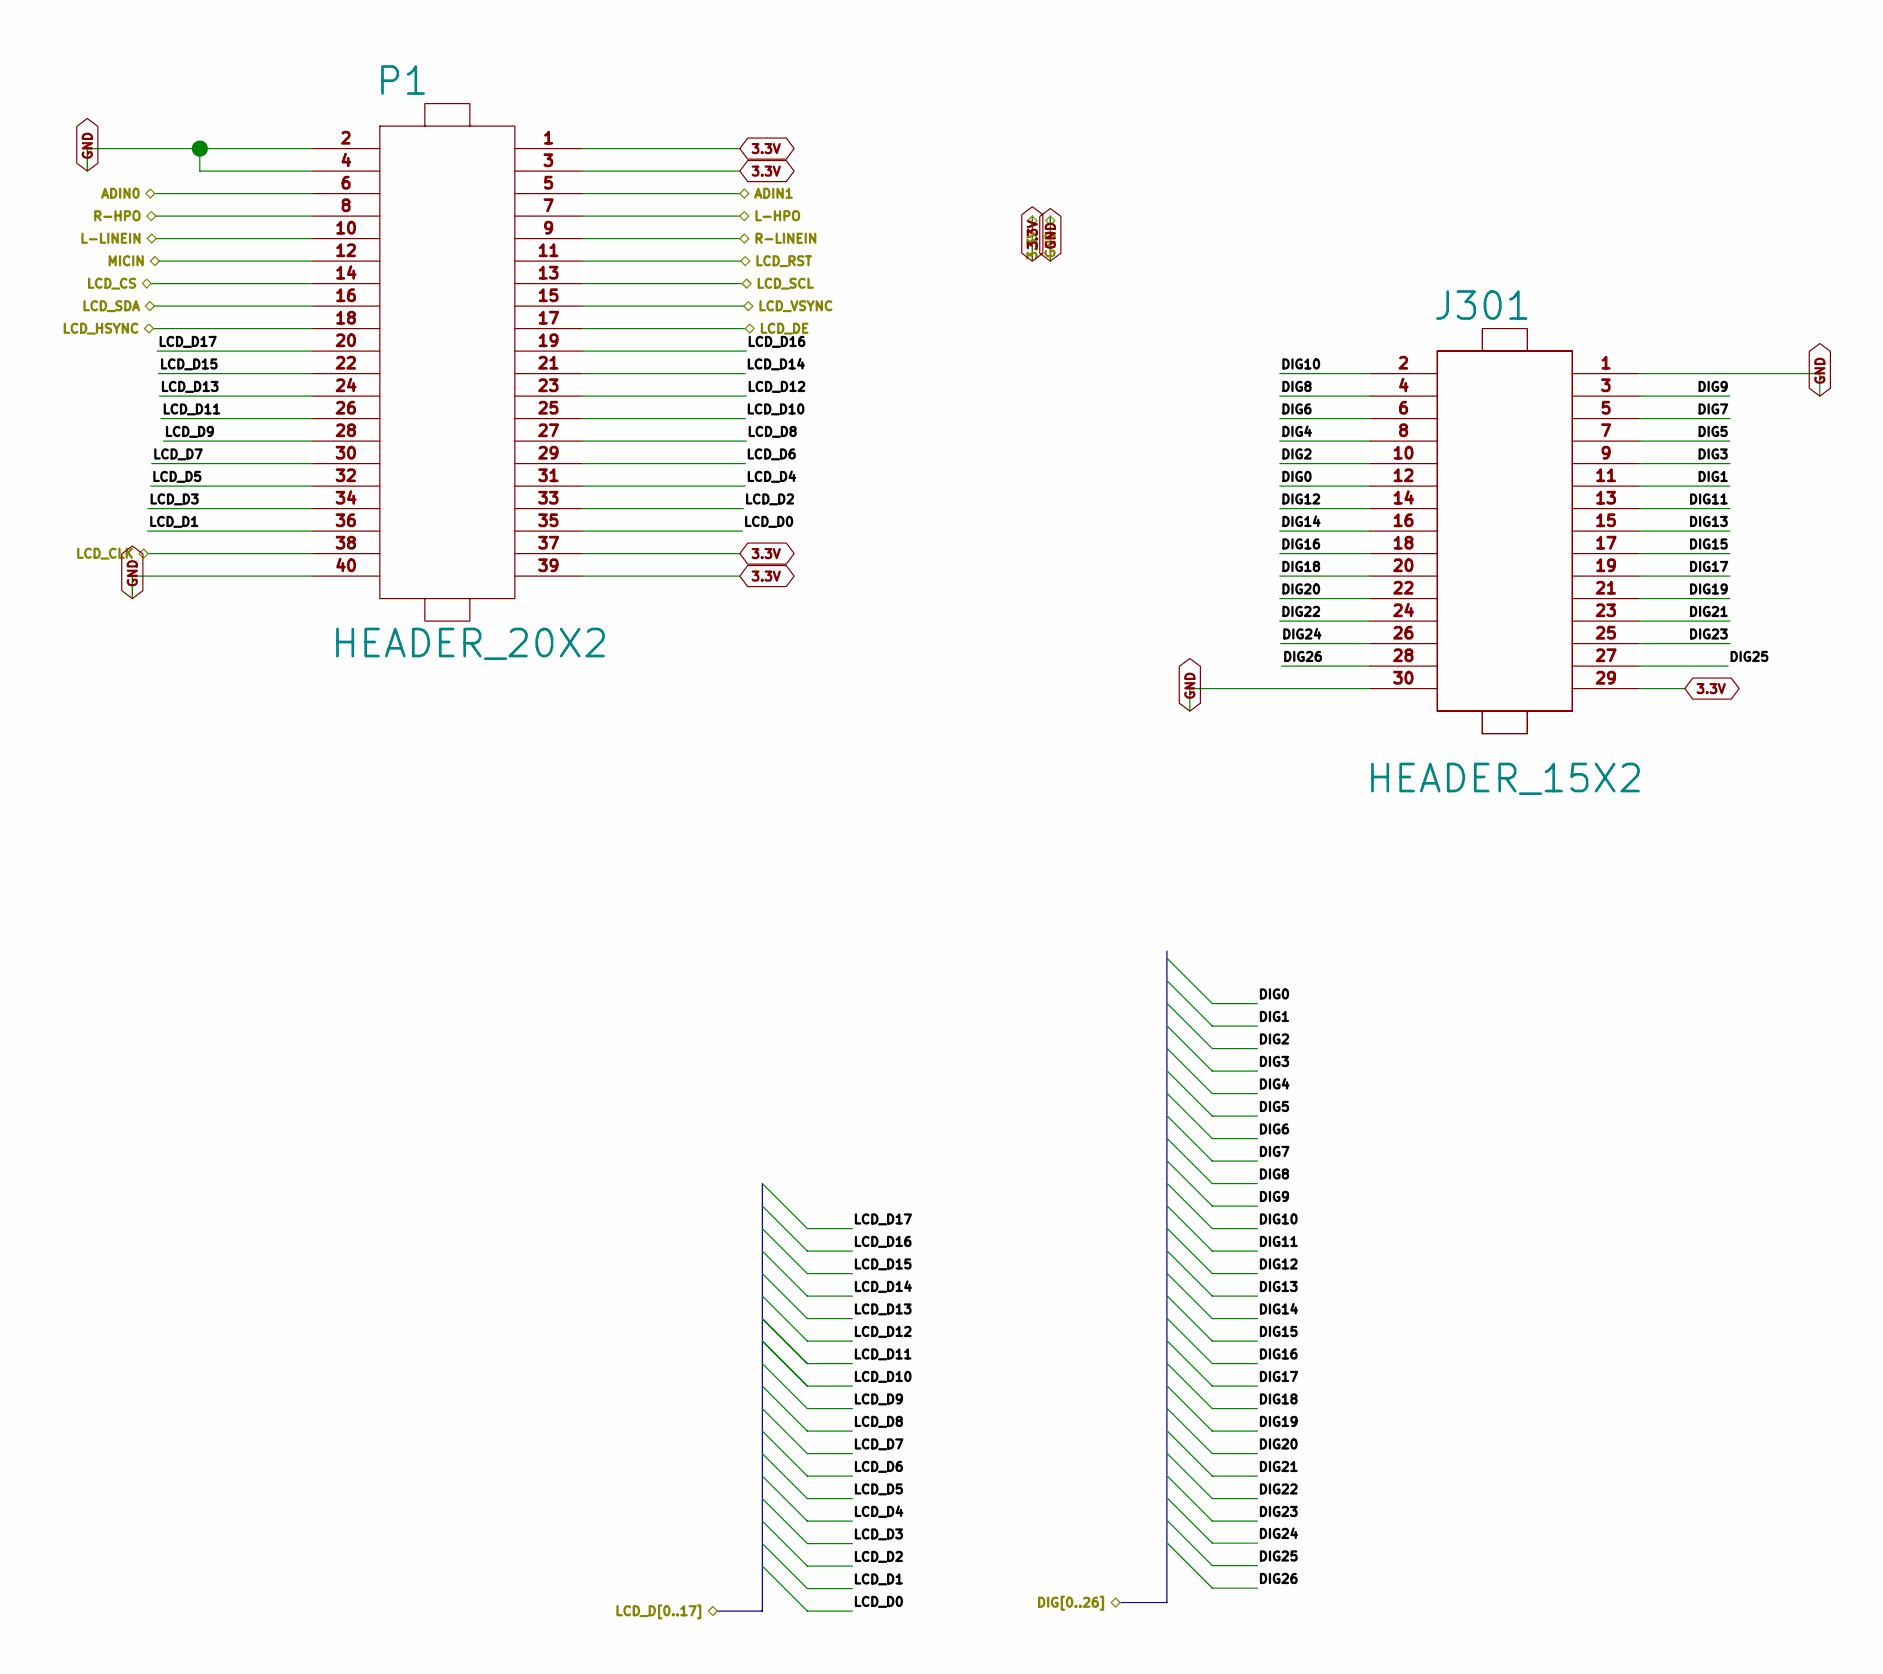
[picture p108: schematic CONNECTORS.sch]

Parts:
J301: HEADER_15X2
P1: HEADER_20X2

Connections:
3.3V: J301.29, P1.1, P1.3, P1.37, P1.39
ADIN0: P1.6
ADIN1: P1.5
DIG0: J301.12
DIG1: J301.11
DIG2: J301.10
DIG3: J301.9
DIG4: J301.8
DIG5: J301.7
DIG6: J301.6
DIG7: J301.5
DIG8: J301.4
DIG9: J301.3
DIG10: J301.2
DIG11: J301.13
DIG12: J301.14
DIG13: J301.15
DIG14: J301.16
DIG15: J301.17
DIG16: J301.18
DIG17: J301.19
DIG18: J301.20
DIG19: J301.21
DIG20: J301.22
DIG21: J301.23
DIG22: J301.24
DIG23: J301.25
DIG24: J301.26
DIG25: J301.27
DIG26: J301.28
GND: J301.1, J301.30, P1.2, P1.4, P1.40
L-HPO: P1.7
L-LINEIN: P1.10
LCD_CLK: P1.38
LCD_CS: P1.14
LCD_D0: P1.35
LCD_D1: P1.36
LCD_D2: P1.33
LCD_D3: P1.34
LCD_D4: P1.31
LCD_D5: P1.32
LCD_D6: P1.29
LCD_D7: P1.30
LCD_D8: P1.27
LCD_D9: P1.28
LCD_D10: P1.25
LCD_D11: P1.26
LCD_D12: P1.23
LCD_D13: P1.24
LCD_D14: P1.21
LCD_D15: P1.22
LCD_D16: P1.19
LCD_D17: P1.20
LCD_DE: P1.17
LCD_HSYNC: P1.18
LCD_RST: P1.11
LCD_SCL: P1.13
LCD_SDA: P1.16
LCD_VSYNC: P1.15
MICIN: P1.12
R-HPO: P1.8
R-LINEIN: P1.9
