IndustriasBizarras/SIE/PCB/Kicad/sie_kicad_v2/POWER_SUPPLY.sch

## KiCad design PCB/Kicad/sie_kicad_v2/POWER_SUPPLY.sch (2012-03-29, an earlier design)

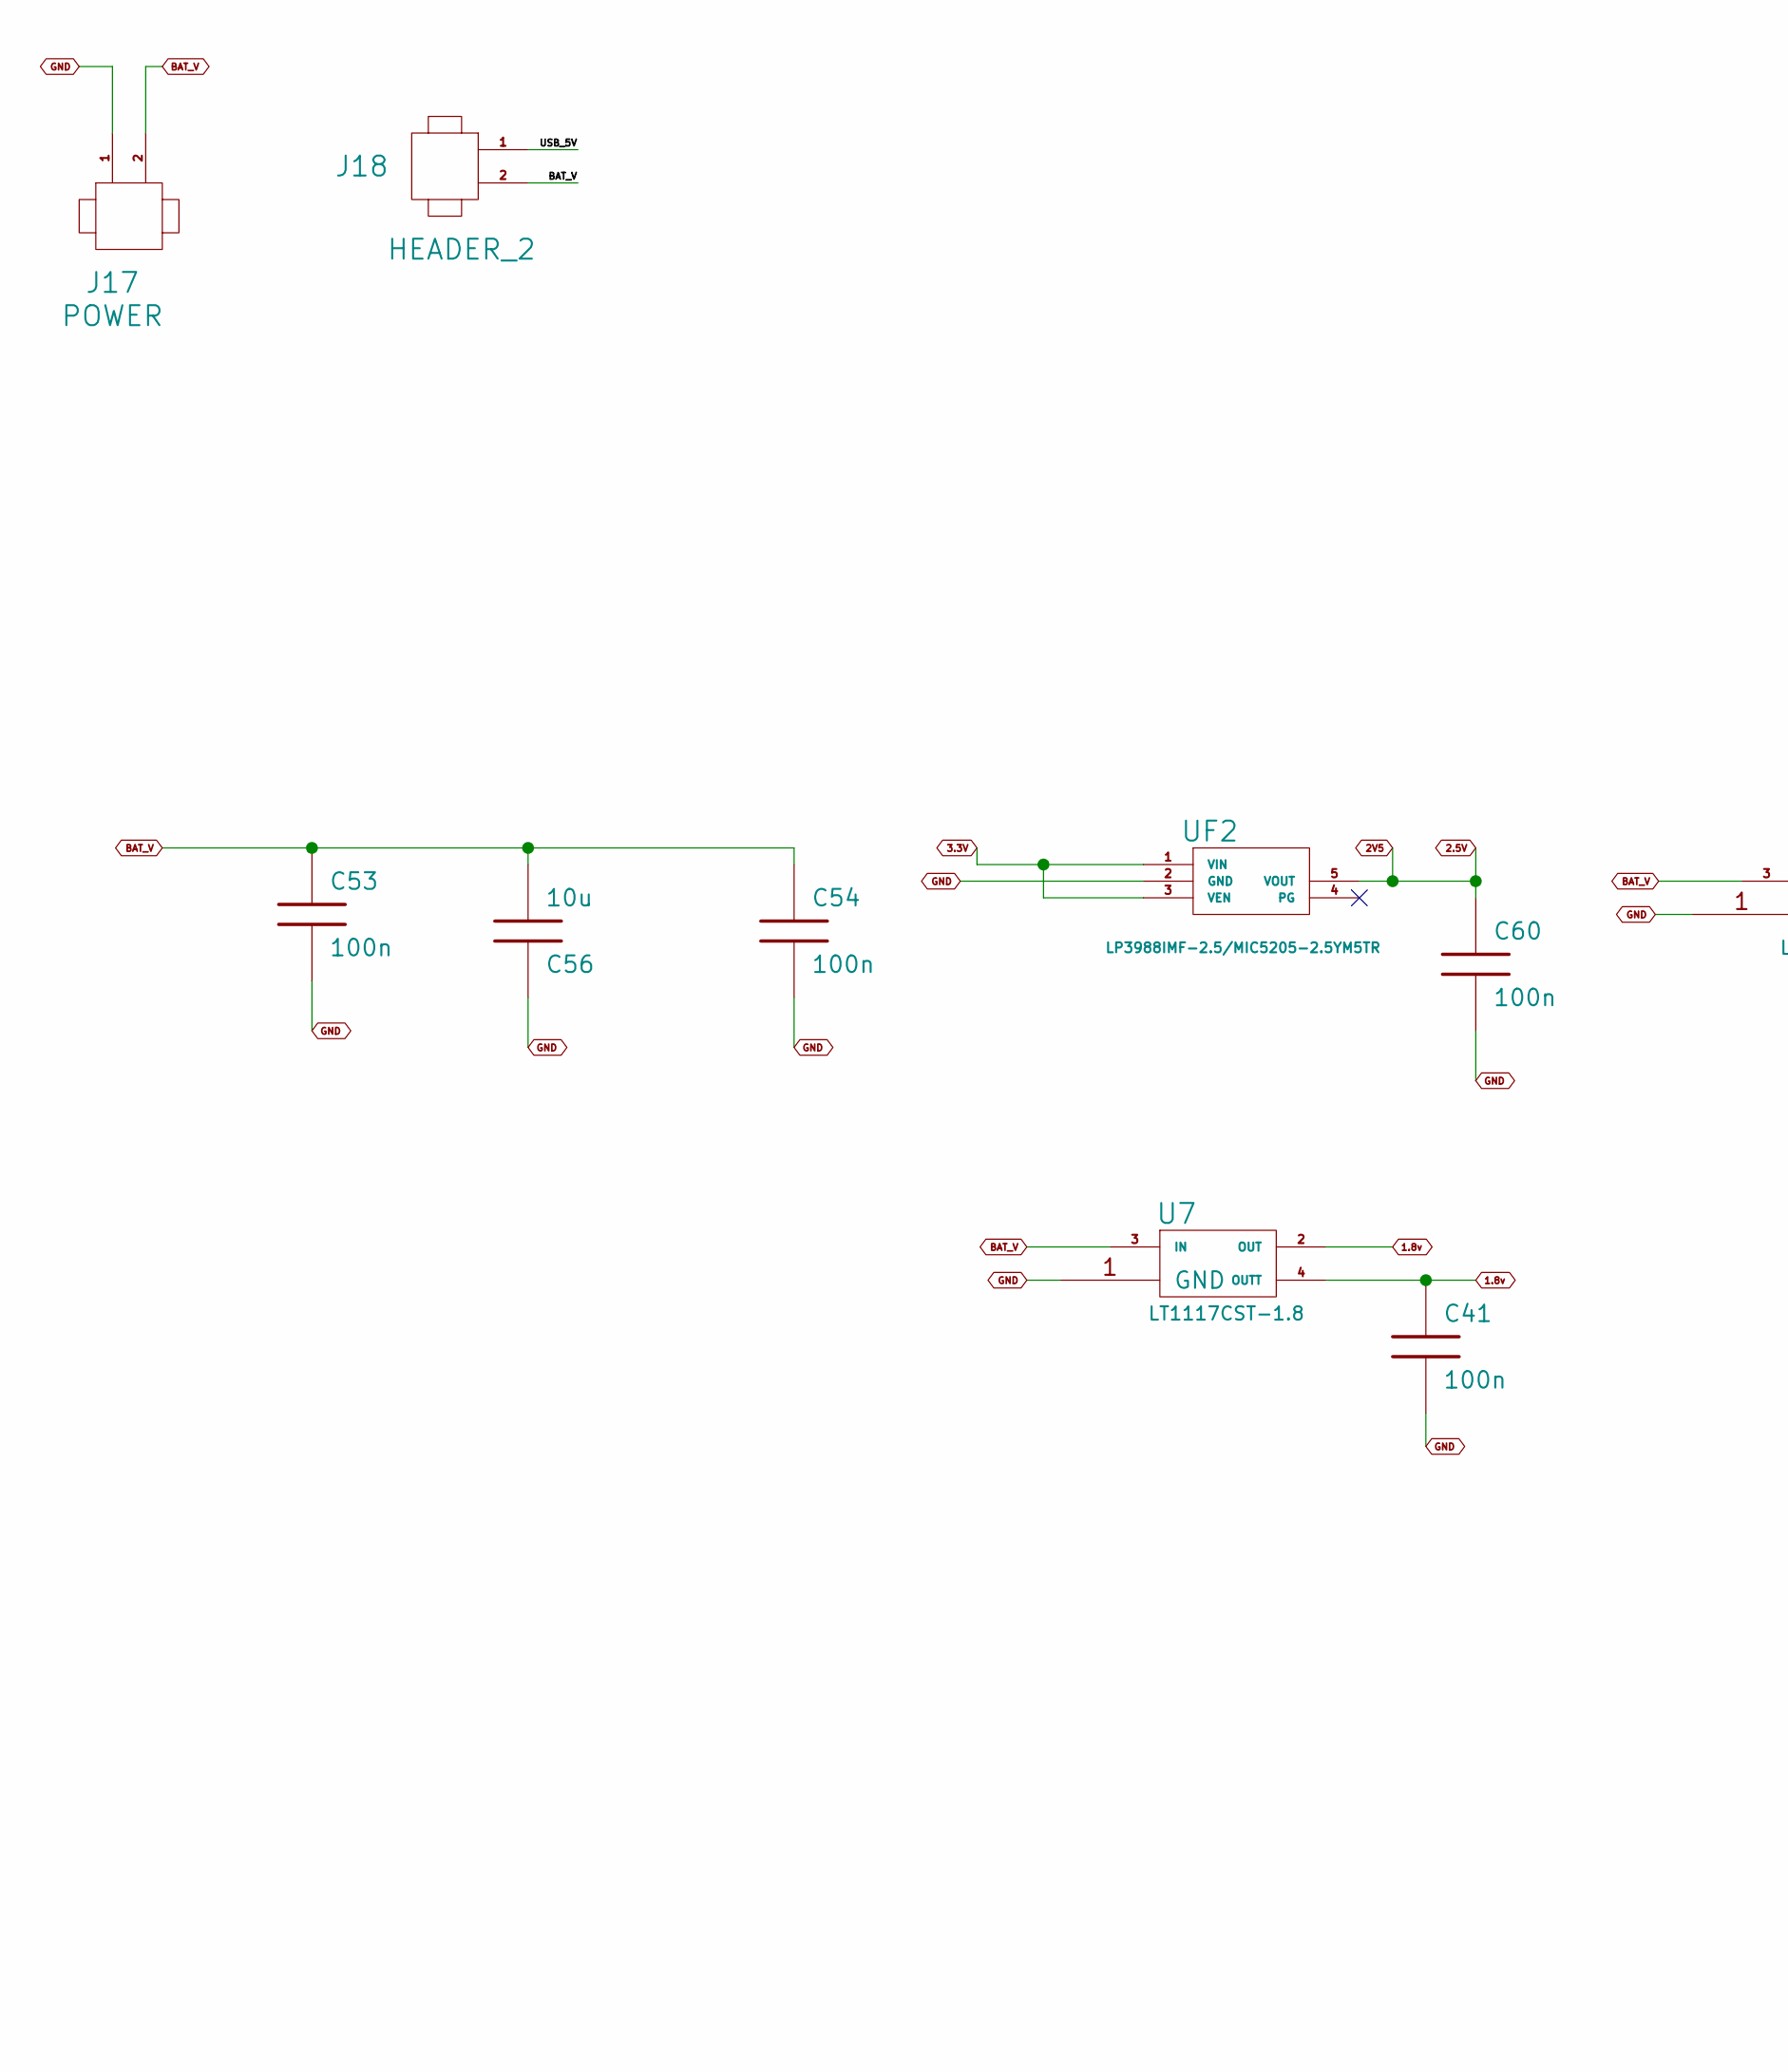
[picture p109: schematic POWER_SUPPLY.sch, part in row 1, column 1]

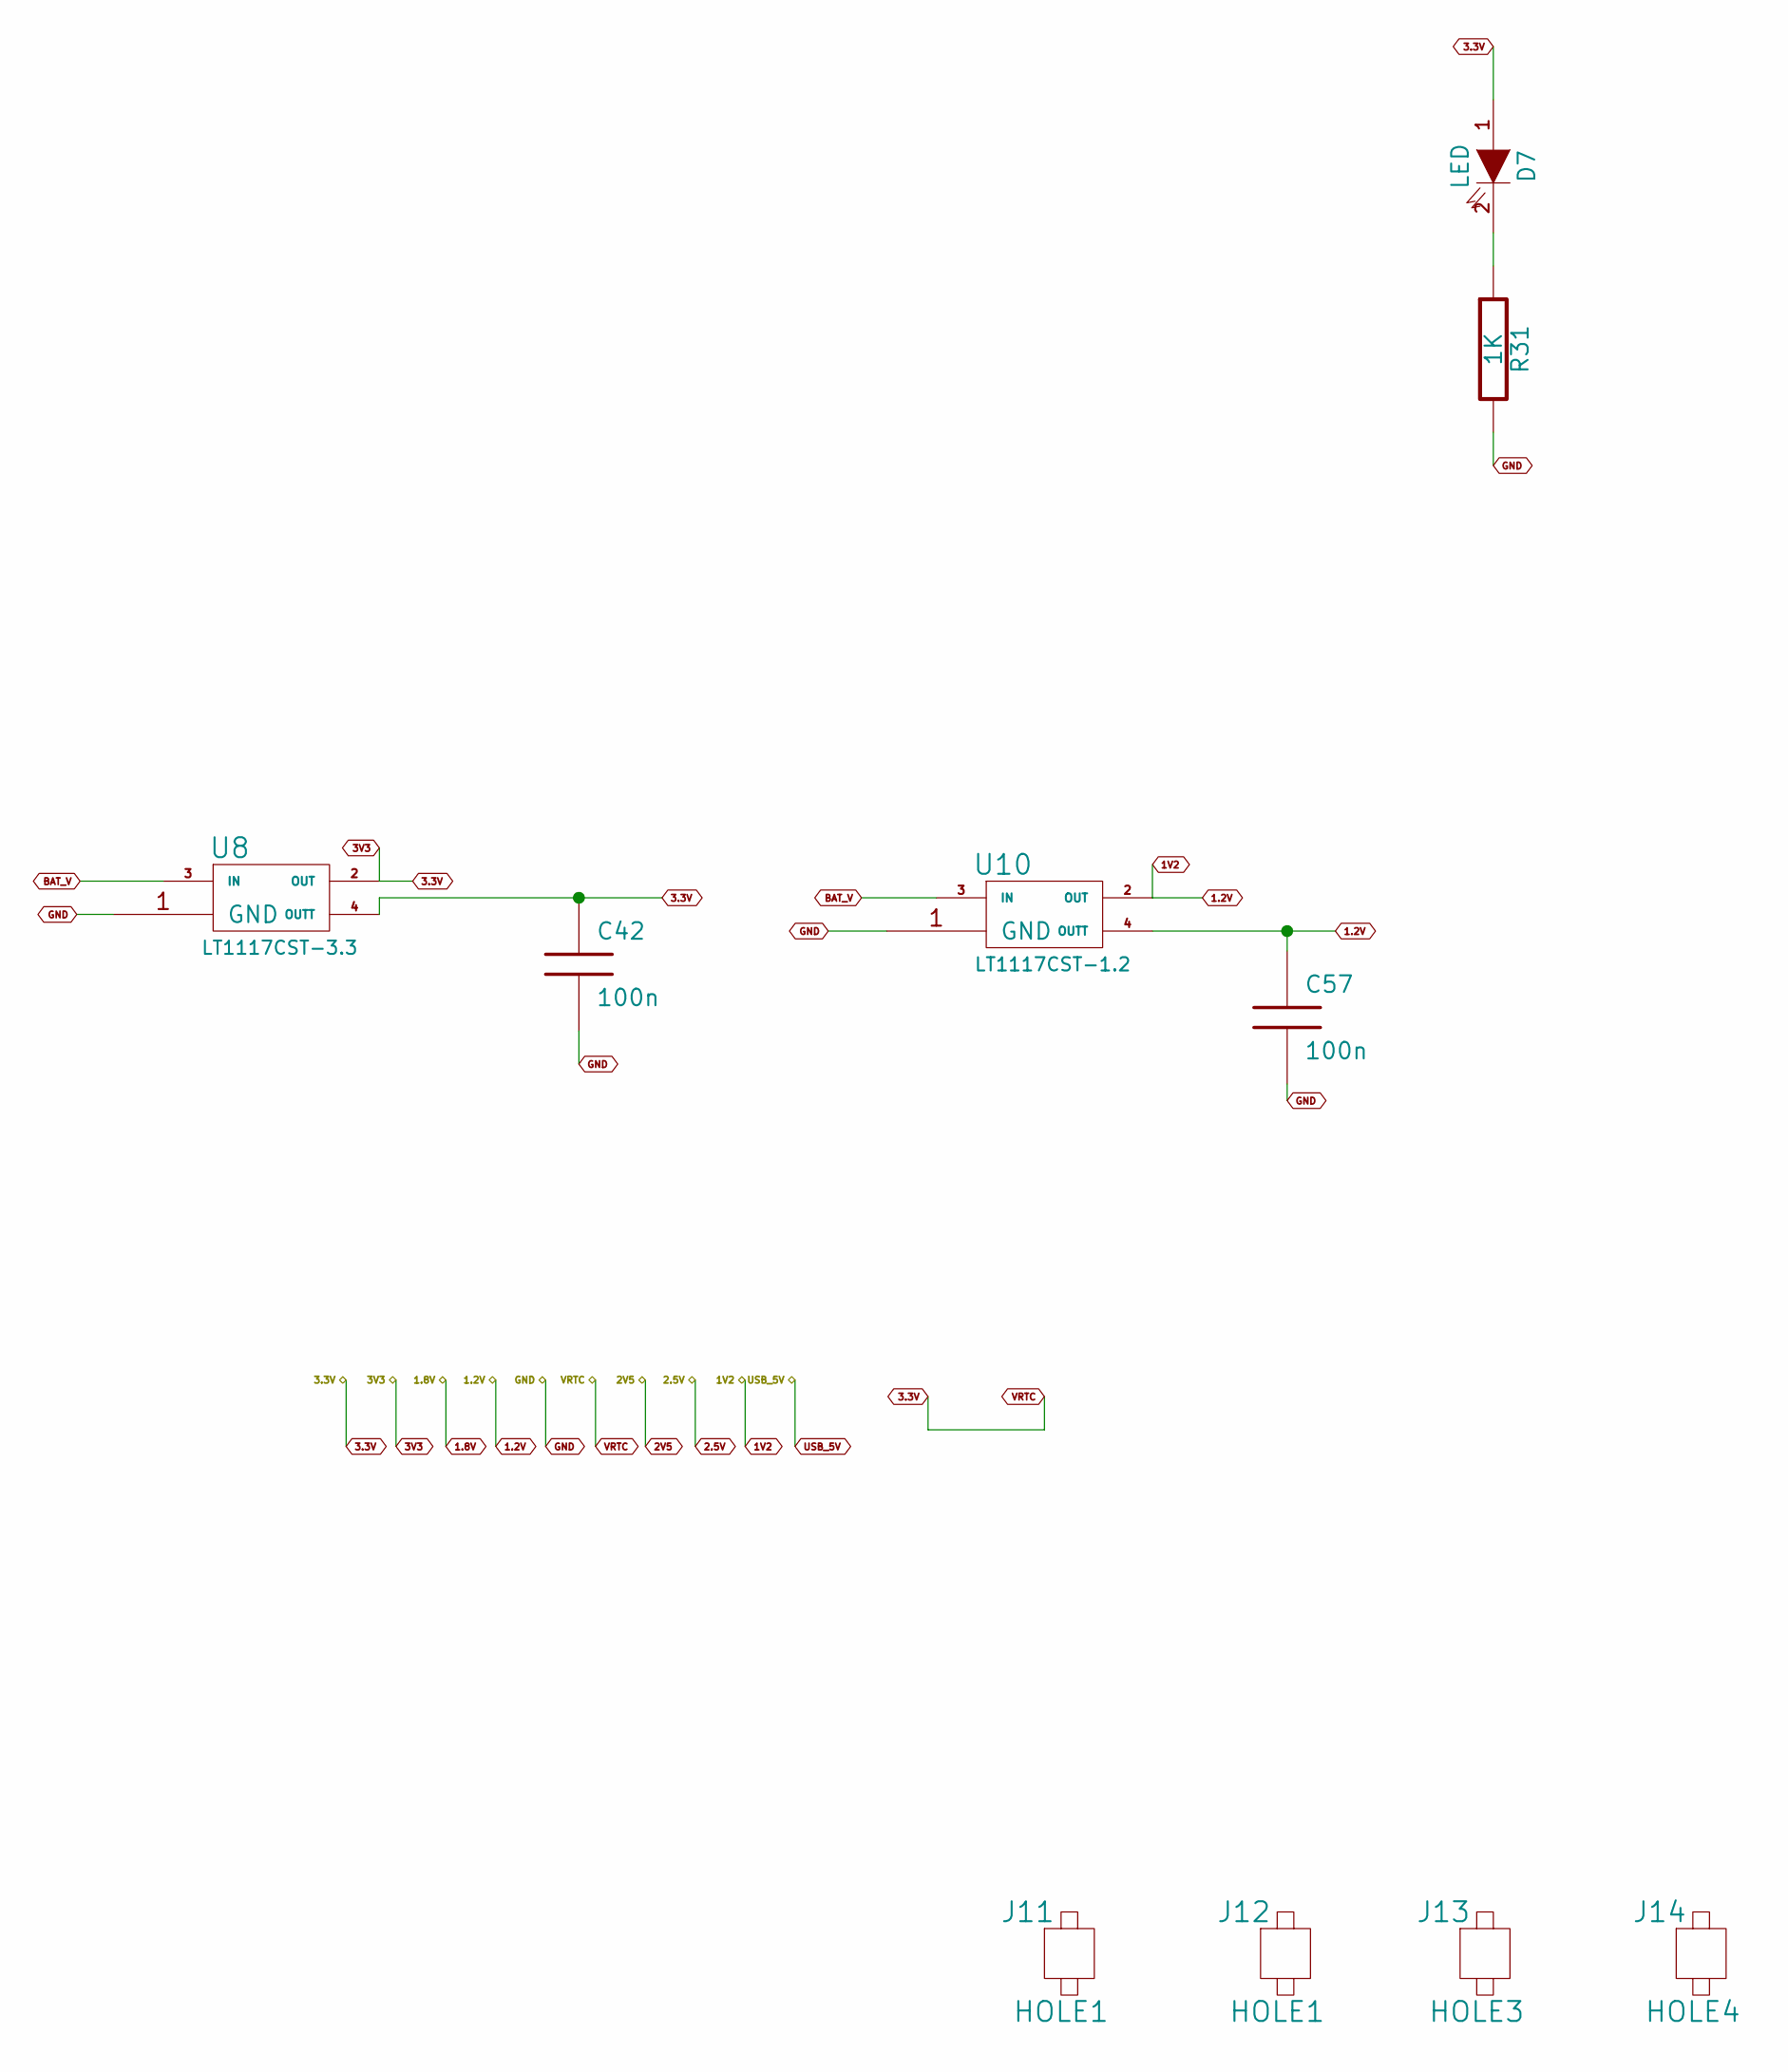
[picture p110: schematic POWER_SUPPLY.sch, part in row 1, column 2]

Parts:
C41, C42, C53, C54, C57, C60: 100n
C56: 10u
D7: LED
J11, J12: HOLE1
J13: HOLE3
J14: HOLE4
J17: POWER
J18: HEADER_2
R31: 1K
U7: LT1117CST-1.8
U8: LT1117CST-3.3
U10: LT1117CST-1.2
UF2: LP3988IMF-2.5/MIC5205-2.5YM5TR

Connections:
1.2V: C57.1, U10.2 (OUT), U10.4 (OUTT)
1.8V: C41.1, U7.2 (OUT), U7.4 (OUTT)
2.5V: C60.1, UF2.5 (VOUT)
3.3V: C42.1, D7.1 (A), U8.2 (OUT), U8.4 (OUTT), UF2.1 (VIN), UF2.3 (VEN)
BAT_V: C53.1, C54.1, C56.2, J17.2, J18.2, U7.3 (IN), U8.3 (IN), U10.3 (IN)
GND: C41.2, C42.2, C53.2, C54.2, C56.1, C57.2, C60.2, J17.1, R31.2, U7.1 (GND), U8.1 (GND), U10.1 (GND), UF2.2 (GND)
unnamed: D7.2 (K), R31.1
USB_5V: J18.1
