IndustriasBizarras/SIE/PCB/Kicad/sie_v1/FSK_Trasnceiver_AND_Signal_Adecuation/FSK_TRANSCEIVER.sch

## KiCad design PCB/Kicad/sie_v1/FSK_Trasnceiver_AND_Signal_Adecuation/FSK_TRANSCEIVER.sch (2011-02-02)

Schematic: FSK_TRANSCEIVER.sch

Parts:
C1, C2, C3, C4, C5, C6: 0.1uF
J2: HEADER_20X2
J3, J6: HEADER
J4: HEADER_3
J5: HEADER_2
R1: 150K
R2: 1K
R7, R10, R12, R13, R14, R17, R18: 10K
R8, R9: 100K
R11, R15, R16: 5K
R19: 100
U1: RFM12B
U2: TPS721XX
U3, U4: AD8605/6/8
U5: TZXXX
