IndustriasBizarras/SIE/PCB/Kicad/sie_v1/SAKC_PCB/CONNECTORS.sch

## KiCad design PCB/Kicad/sie_v1/SAKC_PCB/CONNECTORS.sch (2011-02-02)

Schematic: CONNECTORS.sch

Parts:
J16: HEADER_4X2
J19: HEADER_20X2
