IndustriasBizarras/SIE/PCB/Kicad/sie_v1/SAKC_PCB/D_CONVERTER.sch

## KiCad design PCB/Kicad/sie_v1/SAKC_PCB/D_CONVERTER.sch (2011-02-02)

Schematic: D_CONVERTER.sch

Parts:
L12: HZ0805C202R-00
U11: TLV1548
