IndustriasBizarras/SIE/PCB/Kicad/sie_v1/SAKC_PCB/LCD.sch

## KiCad design PCB/Kicad/sie_v1/SAKC_PCB/LCD.sch (2011-02-02)

Schematic: LCD.sch

Parts:
C58: 10u
C59: 100n
J4: FPCCON24
L10: HZ0805C202R-00
L11: PZ1608D221
RN1, RN2: 33/5%
