IndustriasBizarras/SIE/PCB/Kicad/sie_v1/SAKC_PCB/POWER_SUPPLY.sch

## KiCad design PCB/Kicad/sie_v1/SAKC_PCB/POWER_SUPPLY.sch (2011-02-02)

Schematic: POWER_SUPPLY.sch

Parts:
BT1: BATTERY
C41, C42, C53, C54, C57, C60: 100n
C56: 10u
D7: LED
D8, D9: CDBU0130L
J11, J12: HOLE1
J13: HOLE3
J14: HOLE4
J17: HEADER_2
R31, R34: 1K
U7: LT1117CST-1.8
U8: LT1117CST-3.3
U10: LT1117CST-1.2
UF2: LP3988IMF-2.5/MIC5205-2.5YM5TR
