IndustriasBizarras/SIE/PCB/Kicad/sie_v1/SAKC_PCB/UART_USB_I2C.sch

## KiCad design PCB/Kicad/sie_v1/SAKC_PCB/UART_USB_I2C.sch (2011-02-02)

Schematic: UART_USB_I2C.sch

Parts:
C36, C37, C38, C39, C40, C55: 100n
D1: LED
J6, J7: HEADER_4
J8: ZX62D-B-5P8
J18: HEADER_2
L7, L9: HZ0805C202R-00
R27, R28: 4.7K
R29: 100K
R30: 1K
U6: MAX3223ECAPAA
