IndustriasBizarras/SIE/PCB/Kicad/sie_v1/SAKC_PCB_v2/POWER_SUPPLY.sch

## KiCad design PCB/Kicad/sie_v1/SAKC_PCB_v2/POWER_SUPPLY.sch (2011-02-02)

Schematic: POWER_SUPPLY.sch

Parts:
C41, C42, C53, C54, C57, C60, C77, C78, C79, C80: 100n
C56: 10u
D7: LED
J11, J12: HOLE1
J13: HOLE3
J14: HOLE4
J17: POWER
Q2: TM2301N
R8: 10K
R31: 1K
U7: LT1117CST-1.8
U8: LT1117CST-3.3
U10: LT1117CST-1.2
UF2: LP3988IMF-2.5/MIC5205-2.5YM5TR
UMP1: TL780-05CKTTR; TO263
USWA: LM358; -SOIC8
USWB: LM358; -SOIC8
