IndustriasBizarras/SIE/Examples/moto_display/MAIN/source/drivers/Teclas_IRQ/userspace/jz_test_gpio.c

/*
  JZ47xx test gpio 

  Copyright (C) 2010      Andres Calderon andres.calderon@emqbit.com
                          Carlos Camargo  cicamargoba@unal.edu.co
                                 
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
You should have received a copy of the GNU General Public License
along with this program; if not, write to the Free Software
Foundation, Inc., 59 Temple Place, Suite 330, Boston, MA  02111-1307  USA */

#include <stdio.h>
#include <unistd.h>

#include "jz47xx_gpio.h"

//#define TEST_PORT JZ_GPIO_PORT_C
//#define TEST_PIN  17 

int
main (int argc,char *argv[])

{
  int TEST_PORT, TEST_PIN;

  if(argc != 3){
    fprintf(stderr,"\nUsage: %s TEST_PIN_PORT(A=0, B=1, C=2, D=3) TEST_PIN \n",argv[0]);
  }

  TEST_PORT = ;
  TEST_PIN  = ;
  JZ_PIO *pio = jz_gpio_map (TEST_PORT);//declara un puntero que mapea la dirección fisica del controlador que está dentro del chip. (mapeo de la memoria fisica)

  if (!pio)
    return -1;

  jz_gpio_as_output (pio, TEST_PIN);//define el pin, para que sea una salida, pasa la direccion de memoria en donde está el controlador y el pin. Está declarado en el archivojz47xx_gpio.c la función as_func es similar a la que se asigna en el kernel. Sin necesidad del driver. (Espacio de usuario). Utilizan interfaces diferentes. Los registros tienen que moverse físicamente. En el espacio de usuario es más complicado y pueden tener mucha latencia.  En el kernel se ejecuta sin tanta latencia.

//mirar diferencias entre espacio de kernel y espacio de usuario.


//otra forma es hacerlo por parte de un intérprete.

// tener una librería básica que haga las funciones y a través de un lenguaje de muy alto nivel se puede interpretar los comandos...


//Lenguaje -LUA-
/*
intérprete de alto nivel desarrollado por unos brasileros.

*/
  int tg = 1;

  while (1)
    {
      jz_gpio_out (pio, TEST_PIN, tg);
      printf ("[%d]", jz_gpio_get_pin (pio, TEST_PIN));
      fflush (stdout);
      usleep (500 * 1000);
      tg = !tg;
    }
  return 0;
}
