IndustriasBizarras/SIE/(commit log)

2011-02-02 Repositorio de SIE, tutoriales, demos, software, proyectos que ya corren en SIE
    [$savepcb.brd, BOM.csv, CONNECTORS.sch, CPU.sch, D_CONVERTER.sch, ECB_JZ7425.DSN, ECB_JZ7425.opj, FPGA.sch]
2011-03-01 Adición de los mejores proyectos del 2010: Teclado capacitivo, control de dispositivos PS2, PaIntes, Pedal de efectos
    [$savepcb.brd, LCD.brd, LCD.dsn, LCD.sch, PS2.DSN, Pedalv2.brd, Pedalv2.sch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]
2011-08-01 Adición de los archivos en kicad para SIE: Cambios a la versión anterior de Orcad: - Se eliminaron los conectores de 2mm de separación, se reemplazaron por conectores de 2.5mm que son más fáciles de 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
    Se adicionó una neva versión de ISE sin la FPGA para reducir costos de producción y proporcionar una herramienta económica para el aprendizaje de los sistemas embebidos basados en Linux
    [$savepcb.brd, BOM.csv, CONNECTORS.sch, CPU.sch, D_CONVERTER.sch, ECB_JZ7425.DSN, ECB_JZ7425.opj, FPGA.sch]
2011-08-04 Adición de archivos para probar una SIE nueva
    [ubinize.cfg]
2011-08-04 Archivo para cargar u-boot a la nand de sie
2011-08-05 Adición del sistema de archivos para pruebas basado en la distribución oficial de openwrt
    [usbboot_2gb_nand.cfg]
2011-08-05 Cambio en la capa de silk screen dela tarjeta SIE en la versión de Orcad
2011-08-05 Adición de un sistema de imágenes para el reflash con una distribución basada en openwrt
    [ubinize.cfg]
2011-08-08 Adición del proyecto para verificar los circuitos de la FPGA utilizando urjtag y el puerto JTAG de la FPGA
2011-08-15 Adición del sistema de archivos para probar las nuevas SIE
2011-08-15 Adición de un sistema de archivos y la configuración con que fué creado basado en openwrt
2011-08-15 Adición del proyecto urjtag_PLD que permite configurar la FPGA de SIE desde urjtag
2011-08-16 Adición del manual de programación del JZ4725
2012-02-03 Adición del proyecto de visualización de motocicleta
    [$savepcb (lithium's conflicted copy 2011-04-03).brd, $savepcb.brd, AnalogINS.brd, AnalogINS.dsn, AnalogINS.sch, AnalogINS_prueba.brd, AnalogINS_prueba.dsn, BOM.csv]
2012-03-29 Adición del sistema de archivos y script para crear la imagen completa
    [CONNECTORS.sch, CPU.sch, FPGA.sch, MEMORY.sch, POWER_SUPPLY.sch, SAKC.sch, UART_USB_I2C.sch, usbboot_2gb_nand.cfg]
2012-04-19 Cambio del conbus por uno más sencillo,
    [DE1_pin_assignments.csv, clock.sch, empfanger1.psm, empfanger2.psm, io_out.sch, mcu.psm, mux_2_8.sch, pico10.psm]
2012-04-19 Cambio de nombre de la carpeta SIE en SoftCores
    [DE1_pin_assignments.csv, clock.sch, empfanger1.psm, empfanger2.psm, io_out.sch, mcu.psm, mux_2_8.sch, pico10.psm]
2012-04-21 Adición de un ejemplo de periférico gpio
    [DE1_pin_assignments.csv, clock.sch, empfanger1.psm, empfanger2.psm, io_out.sch, mcu.psm, mux_2_8.sch, pico10.psm]
2012-08-14 Arreglo del ejemplo blink y del xc3sprog
    [blink_TB.v, devicedb.cpp]
2012-09-22 Se incluye una opción de simulación post-síntesis con iverilog
2012-09-24 Adición de un ejemplo con jerarquia (Multiplicador )
2012-10-09 Eliminación de la carpeta softcores
