IndustriasBizarras/SIE/(notices)

Notices in the files:
Examples/moto_display/MAIN/source/drivers/IRQ/irq.c:
it under the terms of the GNU General Public License as published by
the Free Software Foundation; either version 2 of the License, or
(at your option) any later version.
PCB/Kicad/sie_kicad_mini/SAKC.brd:
SIE_BOARD CC-BY-SA 4.0 20100728
PCB/Kicad/sie_kicad_v2/$savepcb.brd:
SIE_BOARD CC-BY-SA 3.0 20100728
